hotchk155/arpie/docs/images/FlickerFix.JPG

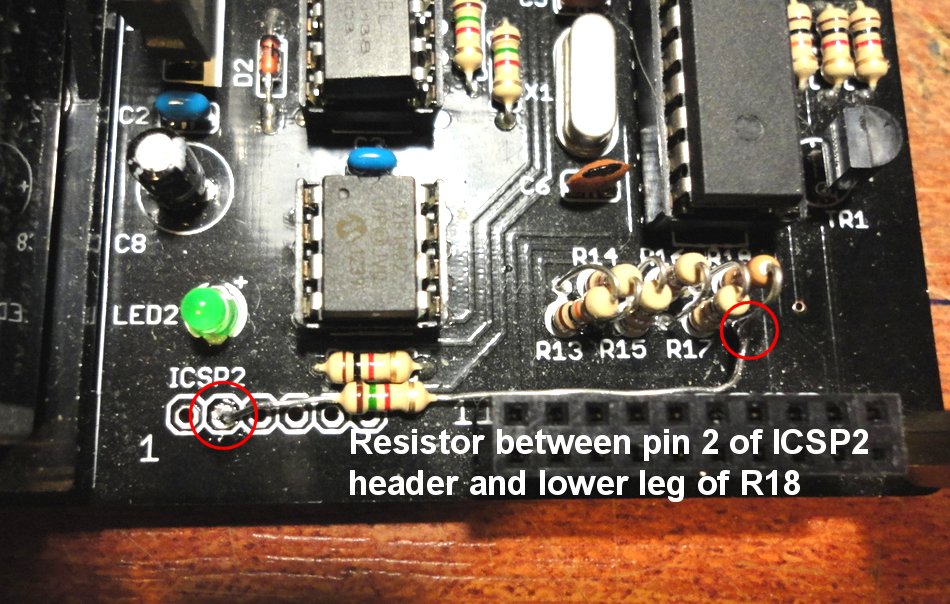
docs/images/FlickerFix.JPG
