hotchk155/arpie/docs/images/Dsc01868.jpg

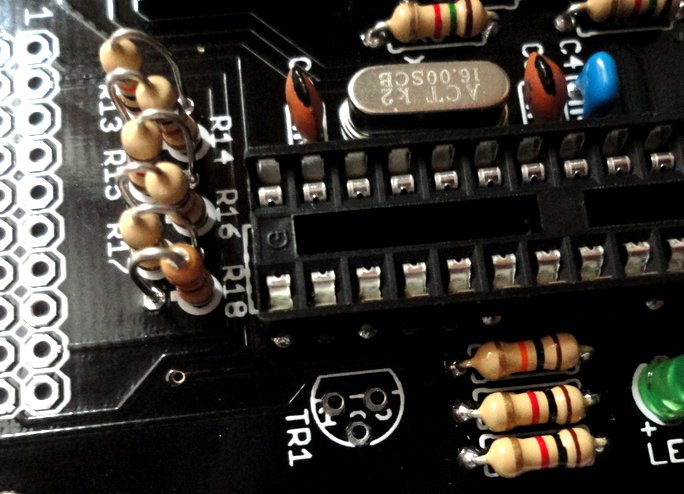
docs/images/Dsc01868.jpg
