hotchk155/arpie/case/ARPIE Case Label.docx

ARPIE Case For assembly instructions please see http://six4pix.com/arpie/case If you have any questions please contact me at goarpie@gmail.com Thanks! Jason | ARPIE Case For assembly instructions please see http://six4pix.com/arpie/case If you have any questions please contact me at goarpie@gmail.com Thanks! Jason
ARPIE Case For assembly instructions please see http://six4pix.com/arpie/case If you have any questions please contact me at goarpie@gmail.com Thanks! Jason | ARPIE Case For assembly instructions please see http://six4pix.com/arpie/case If you have any questions please contact me at goarpie@gmail.com Thanks! Jason
ARPIE Case For assembly instructions please see http://six4pix.com/arpie/case If you have any questions please contact me at goarpie@gmail.com Thanks! Jason | ARPIE Case For assembly instructions please see http://six4pix.com/arpie/case If you have any questions please contact me at goarpie@gmail.com Thanks! Jason
ARPIE Case For assembly instructions please see http://six4pix.com/arpie/case If you have any questions please contact me at goarpie@gmail.com Thanks! Jason | ARPIE Case For assembly instructions please see http://six4pix.com/arpie/case If you have any questions please contact me at goarpie@gmail.com Thanks! Jason
