hotchk155/arpie/docs/Arpie Upgrade.odt

ARPIE 4 Firmware Upgrade (ATMega328)

Before starting work, turn ARPIE off and touch a grounded metal surface to discharge any static build-up (These components can be damaged by static discharge)

Align the pin 1 notch on the chip with the notch on the socket and take care to avoid bending the pins.

Tip: Your old microcontroller chip can be reprogrammed and used in other projects so take care removing it and don't throw it away! (it has Arduino Duemilanova bootloader on it)

ARPIE Website (incl. new user manual): six4pix.com/arpie

Email: goarpie@gmail.com

ARPIE 4 Firmware Upgrade (ATMega328)

Before starting work, turn ARPIE off and touch a grounded metal surface to discharge any static build-up (These components can be damaged by static discharge)

Align the pin 1 notch on the chip with the notch on the socket and take care to avoid bending the pins.

Tip: Your old microcontroller chip can be reprogrammed and used in other projects so take care removing it and don't throw it away! (it has Arduino Duemilanova bootloader on it)

ARPIE Website (incl. new user manual): six4pix.com/arpie

Email: goarpie@gmail.com

ARPIE 4 Firmware Upgrade (ATMega328)

Before starting work, turn ARPIE off and touch a grounded metal surface to discharge any static build-up (These components can be damaged by static discharge)

Align the pin 1 notch on the chip with the notch on the socket and take care to avoid bending the pins.

Tip: Your old microcontroller chip can be reprogrammed and used in other projects so take care removing it and don't throw it away! (it has Arduino Duemilanova bootloader on it)

ARPIE Website (incl. new user manual): six4pix.com/arpie

Email: goarpie@gmail.com

ARPIE 4 Firmware Upgrade (ATMega328)

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

ARPIE Website (incl. new user manual): six4pix.com/arpie

Email: goarpie@gmail.com

ARPIE 4 Firmware Upgrade (ATMega328)

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

ARPIE Website (incl. new user manual): six4pix.com/arpie

Email: goarpie@gmail.com

ARPIE 4 Firmware Upgrade (ATMega328)

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

ARPIE Website (incl. new user manual): six4pix.com/arpie

Email: goarpie@gmail.com

ARPIE 4 Firmware Upgrade (ATMega328)

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

ARPIE Website (incl. new user manual): six4pix.com/arpie

Email: goarpie@gmail.com

ARPIE 4 Firmware Upgrade (ATMega328)

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

ARPIE Website (incl. new user manual): six4pix.com/arpie

Email: goarpie@gmail.com
