hotchk155/arpie/docs/images/B300.JPG

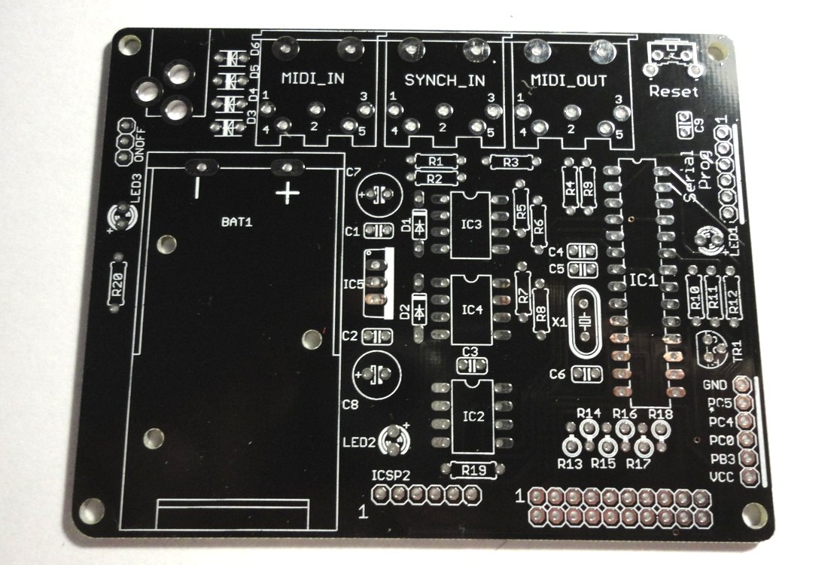
docs/images/B300.JPG
