hotchk155/arpie/docs/images/B301.JPG

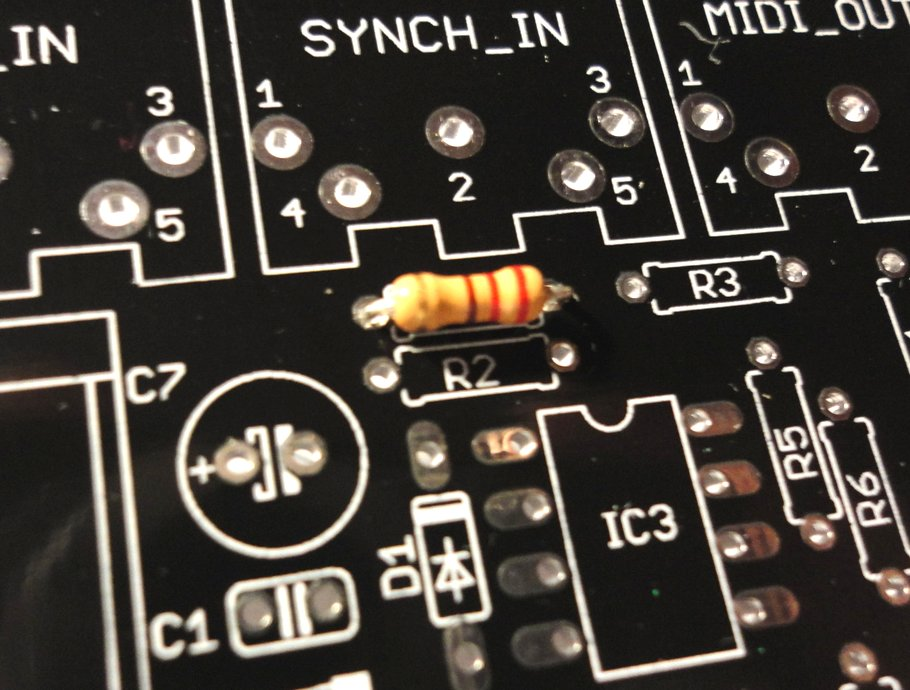
docs/images/B301.JPG
