hotchk155/arpie/docs/images/B302.JPG

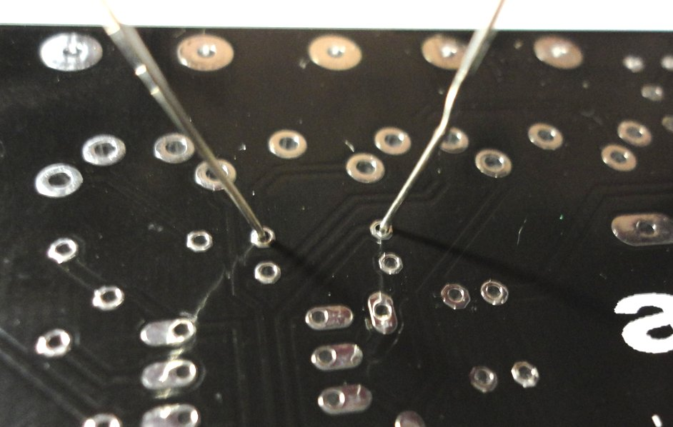
docs/images/B302.JPG
