hotchk155/arpie/docs/images/B303.JPG

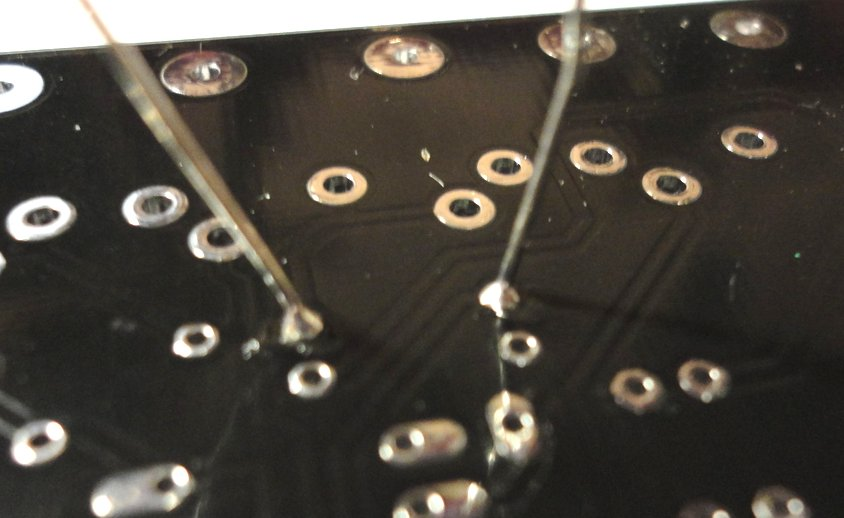
docs/images/B303.JPG
