hotchk155/arpie/docs/images/B304.JPG

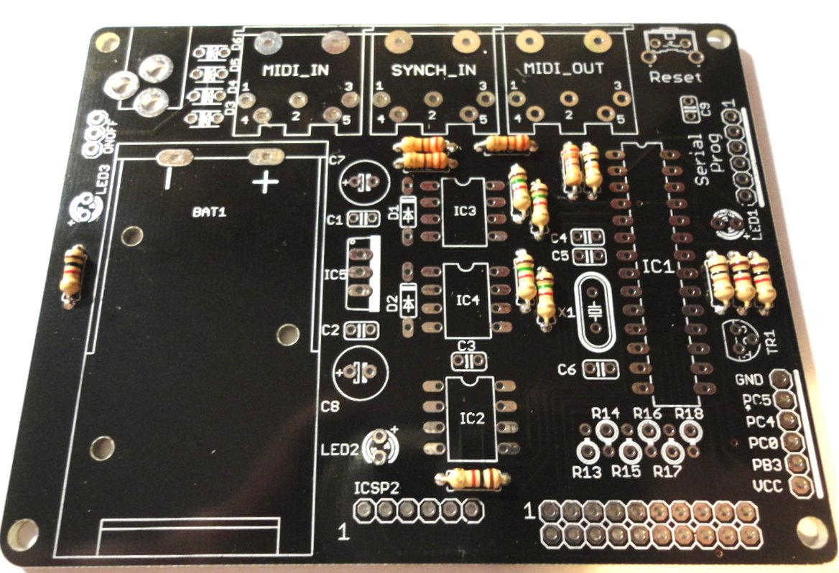
docs/images/B304.JPG
