hotchk155/arpie/docs/images/B305.JPG

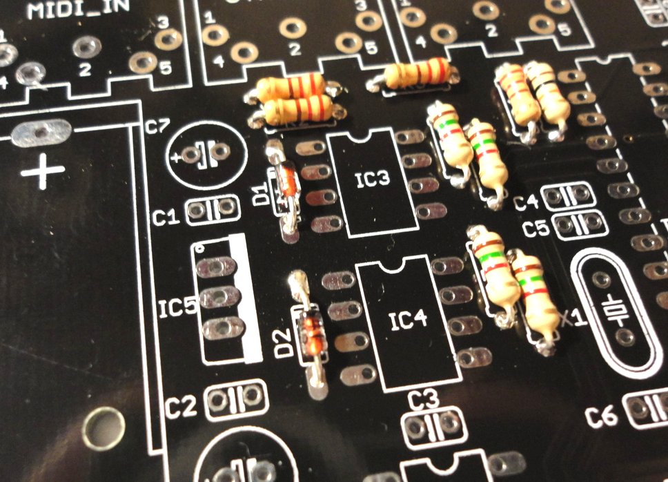
docs/images/B305.JPG
