hotchk155/arpie/docs/images/B306.JPG

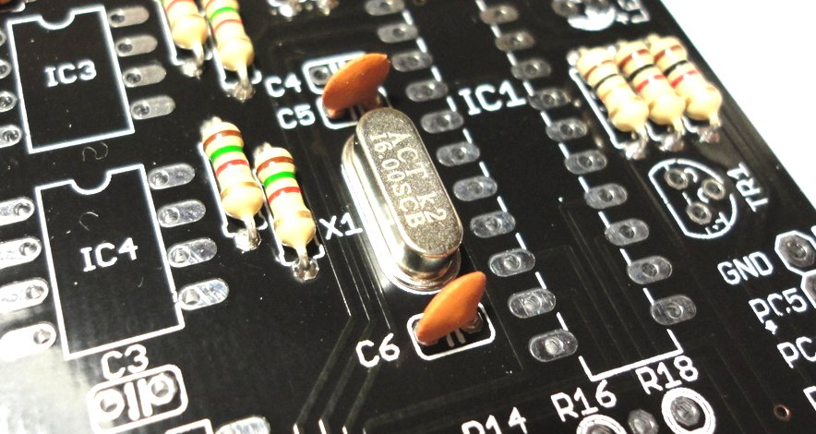
docs/images/B306.JPG
