hotchk155/arpie/docs/images/B307.JPG

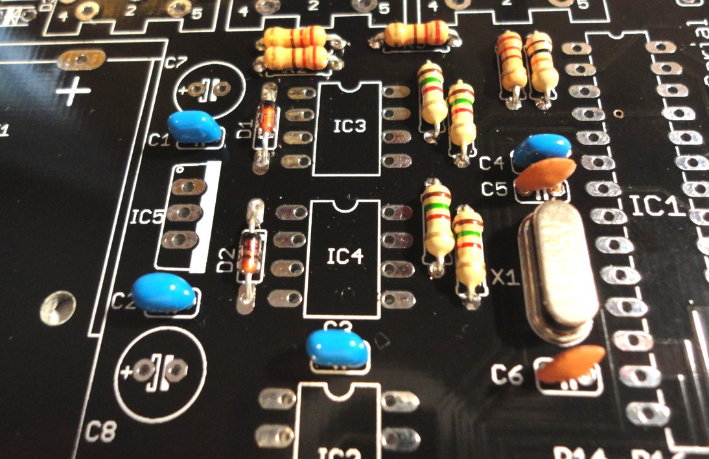
docs/images/B307.JPG
