hotchk155/arpie/docs/images/B308.JPG

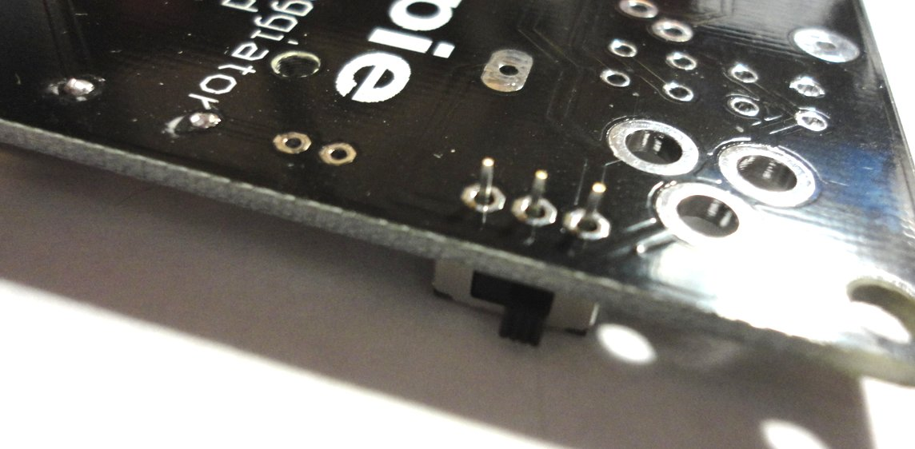
docs/images/B308.JPG
