hotchk155/arpie/docs/images/B309.JPG

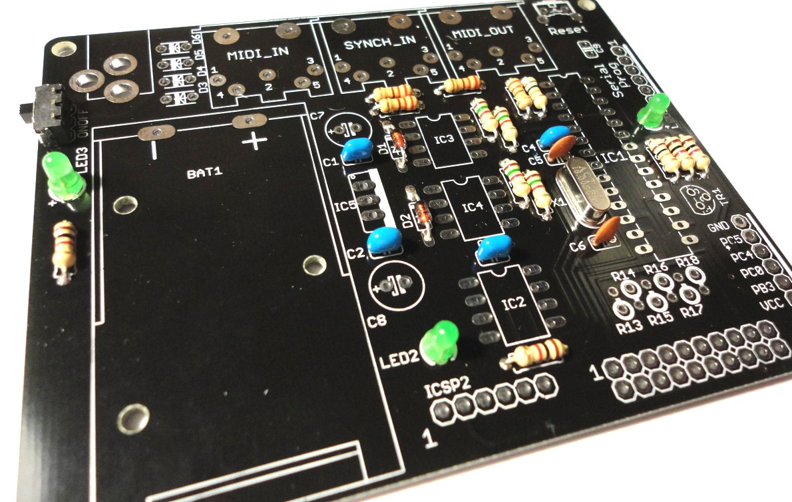
docs/images/B309.JPG
