hotchk155/arpie/docs/images/B310.JPG

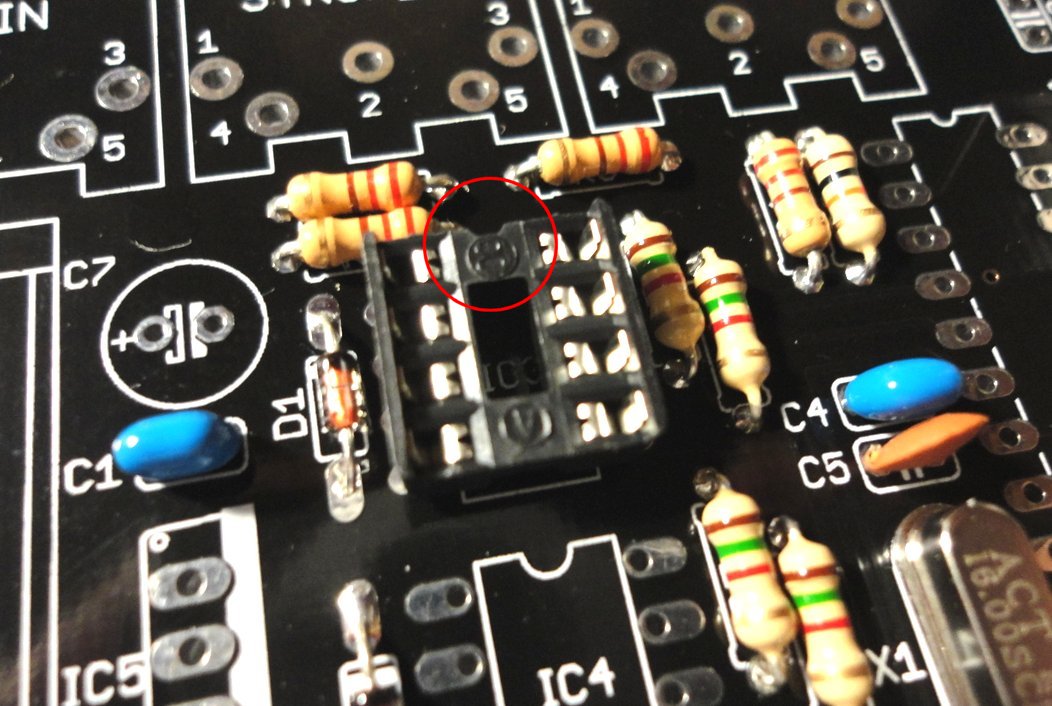
docs/images/B310.JPG
