hotchk155/arpie/docs/images/B311.JPG

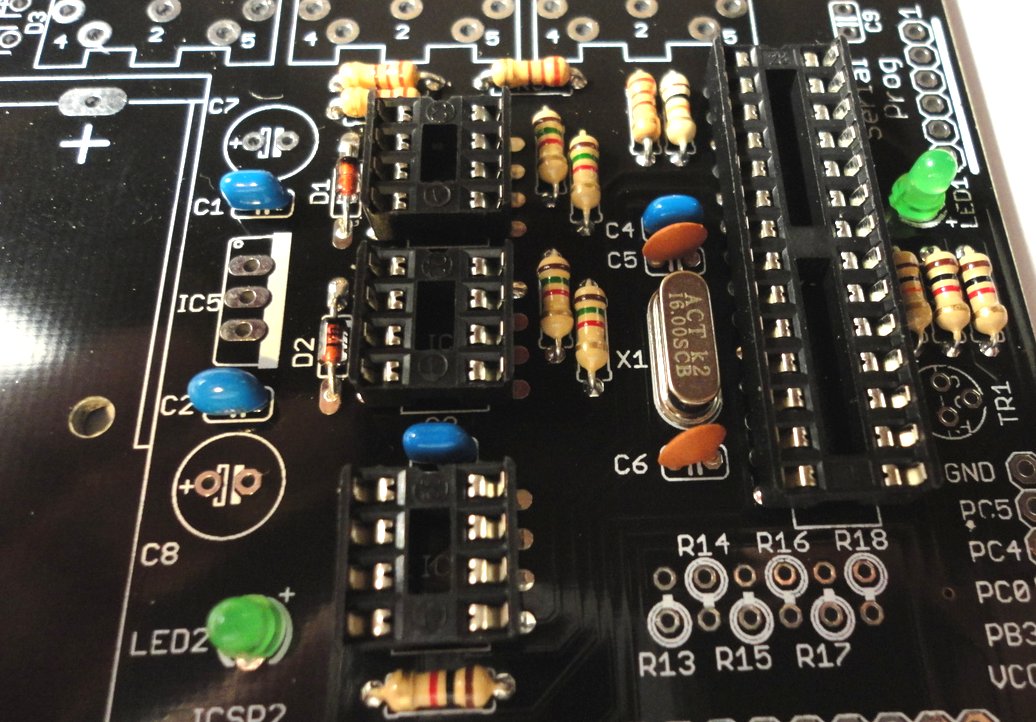
docs/images/B311.JPG
