hotchk155/arpie/docs/images/B312.JPG

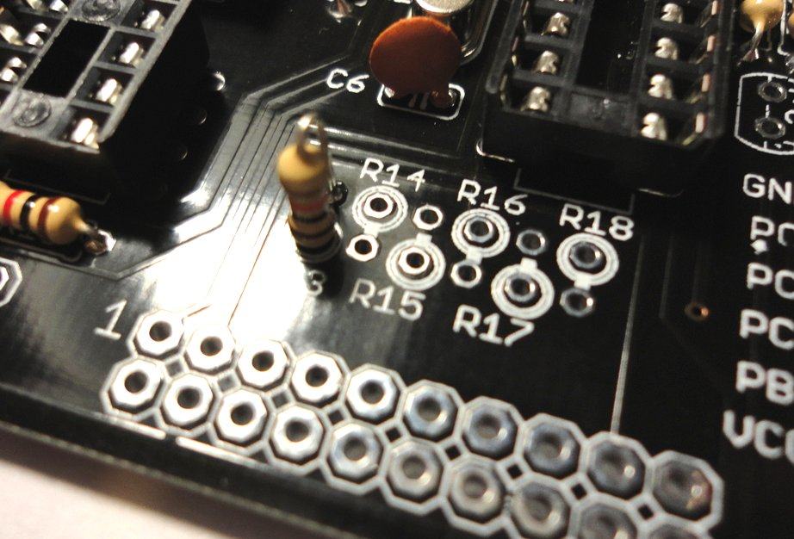
docs/images/B312.JPG
