hotchk155/arpie/docs/images/B313.JPG

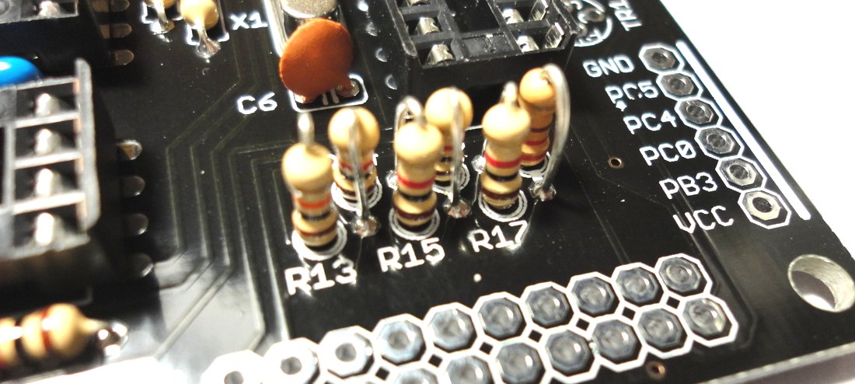
docs/images/B313.JPG
