hotchk155/arpie/docs/images/B314.JPG

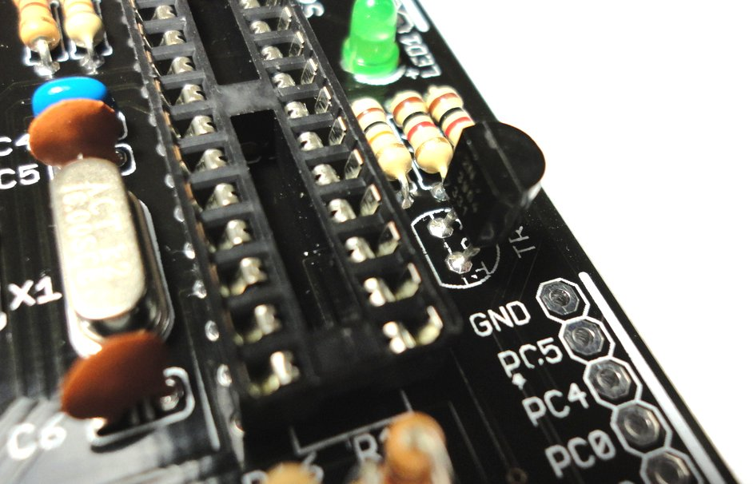
docs/images/B314.JPG
