hotchk155/arpie/docs/images/B315.JPG

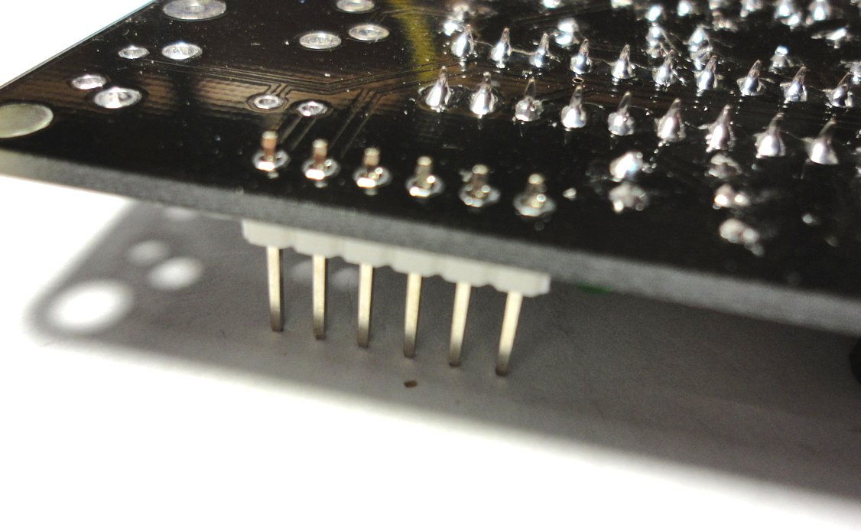
docs/images/B315.JPG
