hotchk155/arpie/docs/images/B316.JPG

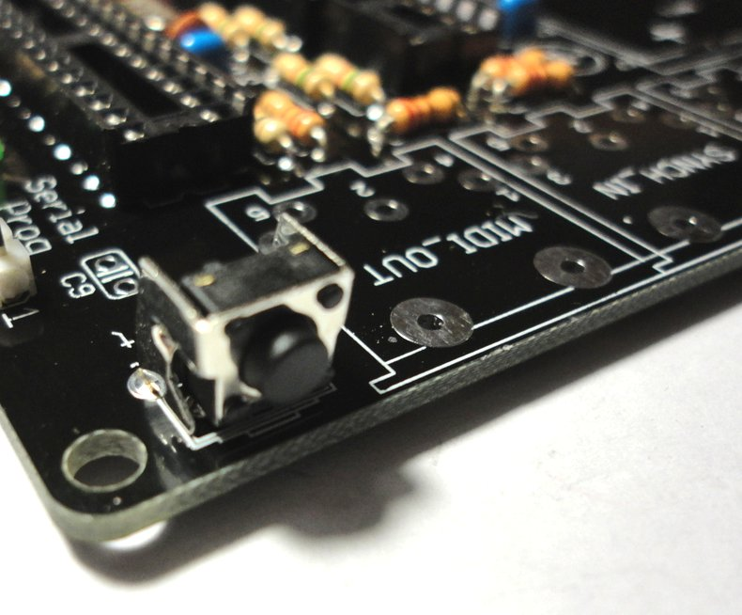
docs/images/B316.JPG
