hotchk155/arpie/docs/images/B317.JPG

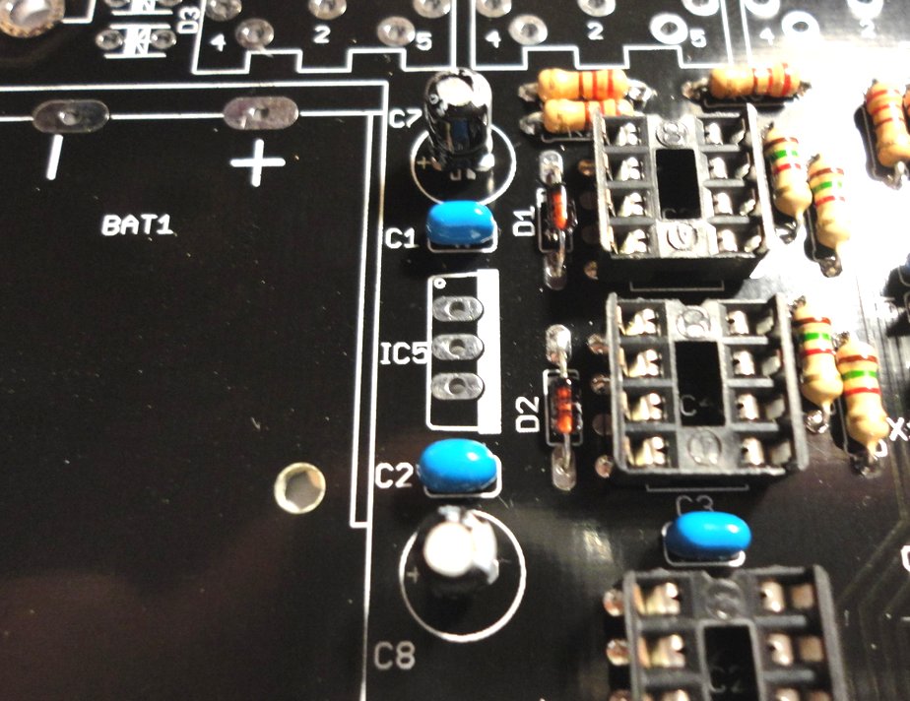
docs/images/B317.JPG
