hotchk155/arpie/docs/images/B318.JPG

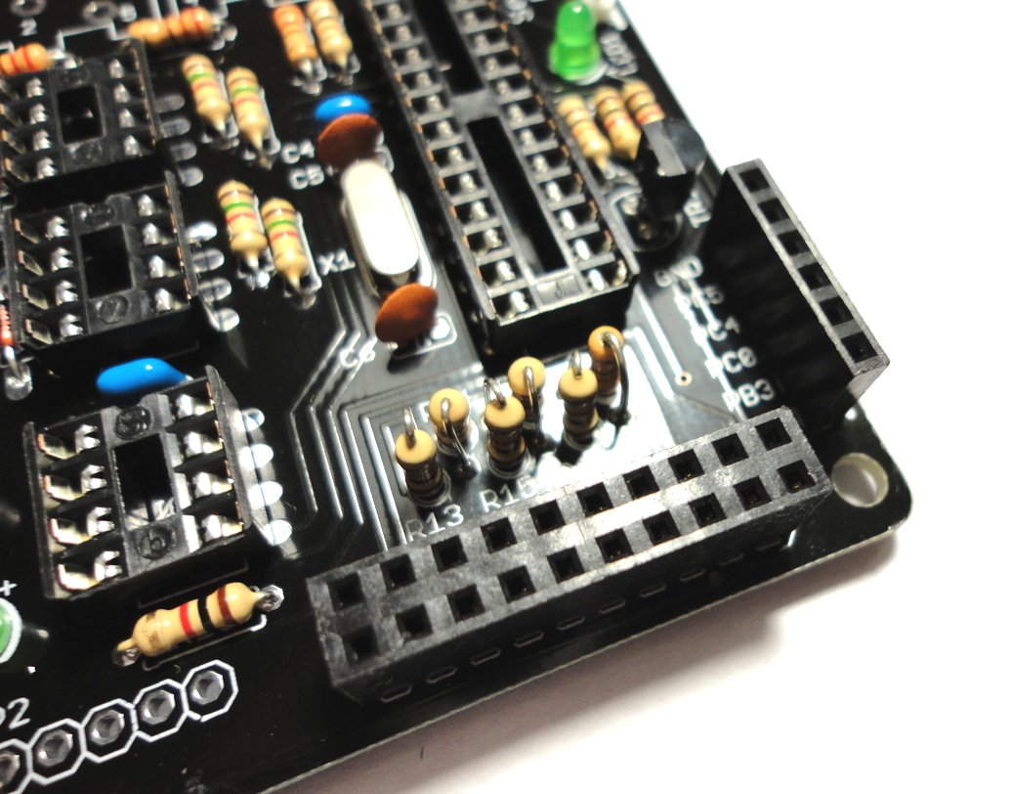
docs/images/B318.JPG
