hotchk155/arpie/docs/images/B319.JPG

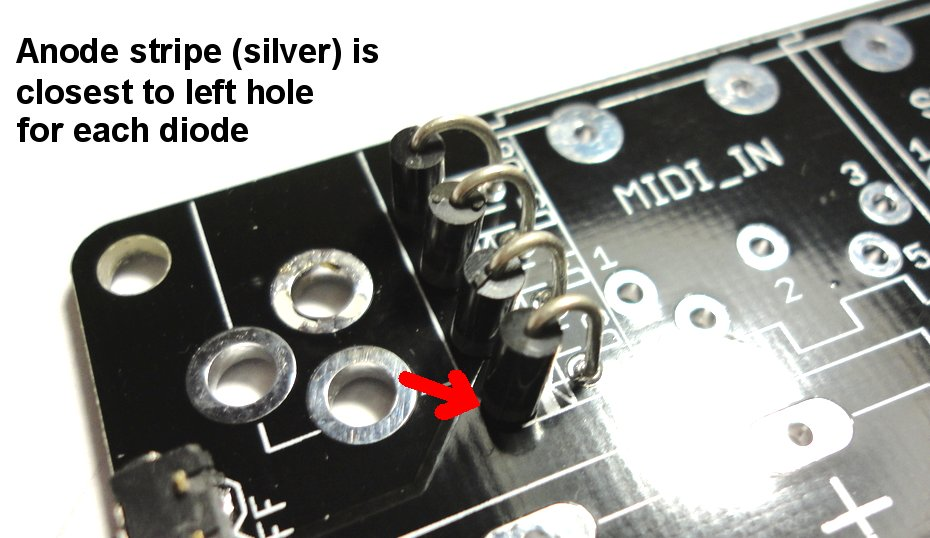
docs/images/B319.JPG
