hotchk155/arpie/docs/images/B320.JPG

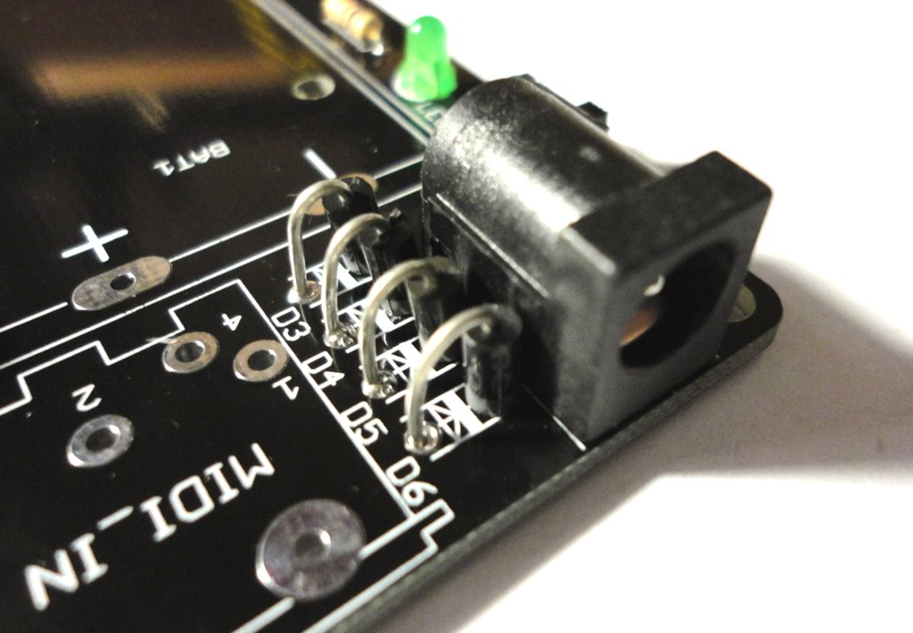
docs/images/B320.JPG
