hotchk155/arpie/docs/images/B321.JPG

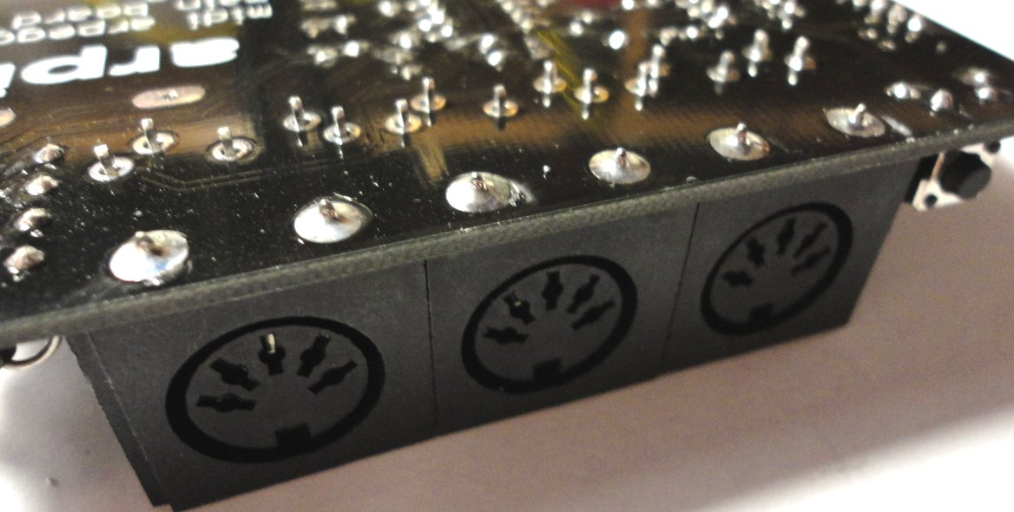
docs/images/B321.JPG
