hotchk155/arpie/docs/images/B322.JPG

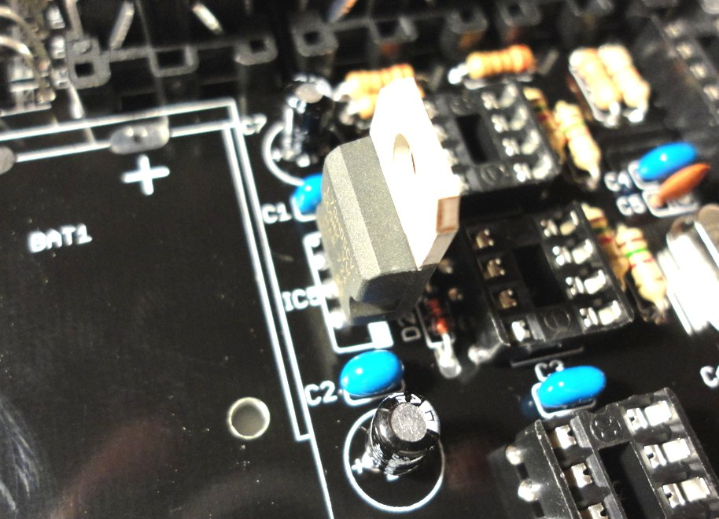
docs/images/B322.JPG
