hotchk155/arpie/docs/images/B323.JPG

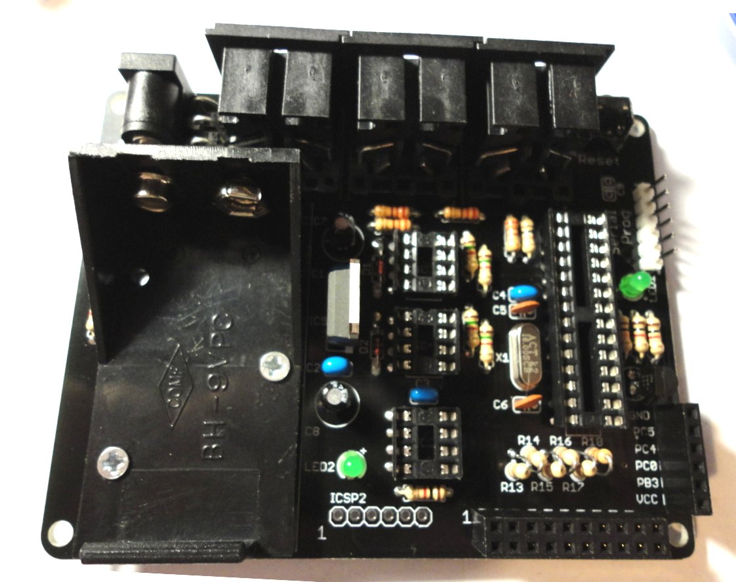
docs/images/B323.JPG
