hotchk155/arpie/docs/images/B324.JPG

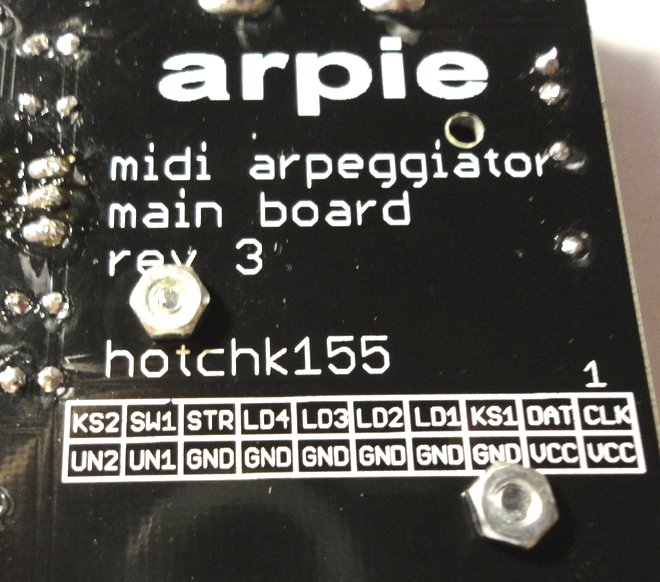
docs/images/B324.JPG
