hotchk155/arpie/docs/images/B325.JPG

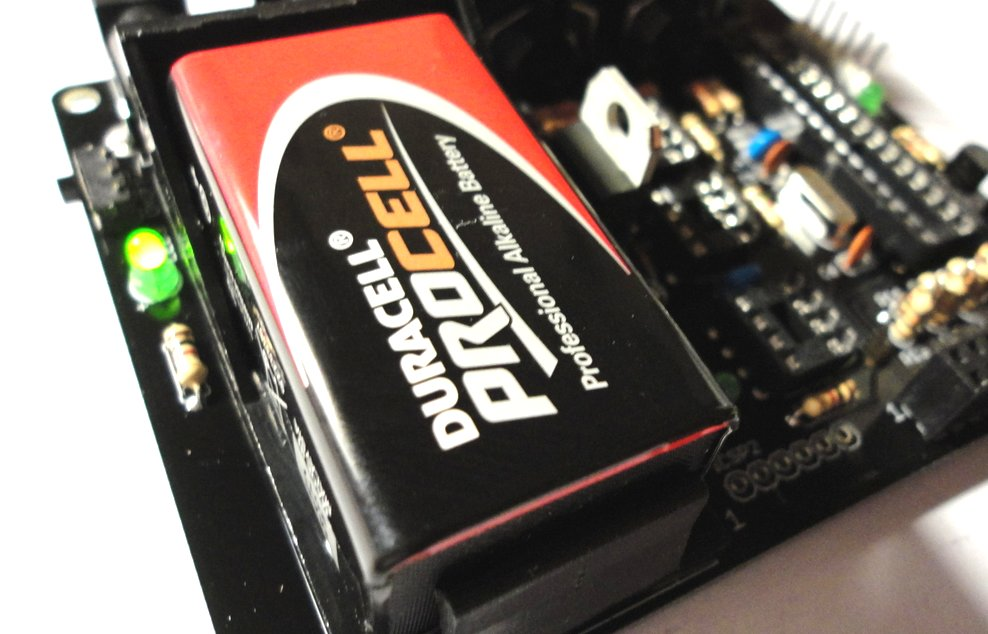
docs/images/B325.JPG
