hotchk155/arpie/docs/images/B326.JPG

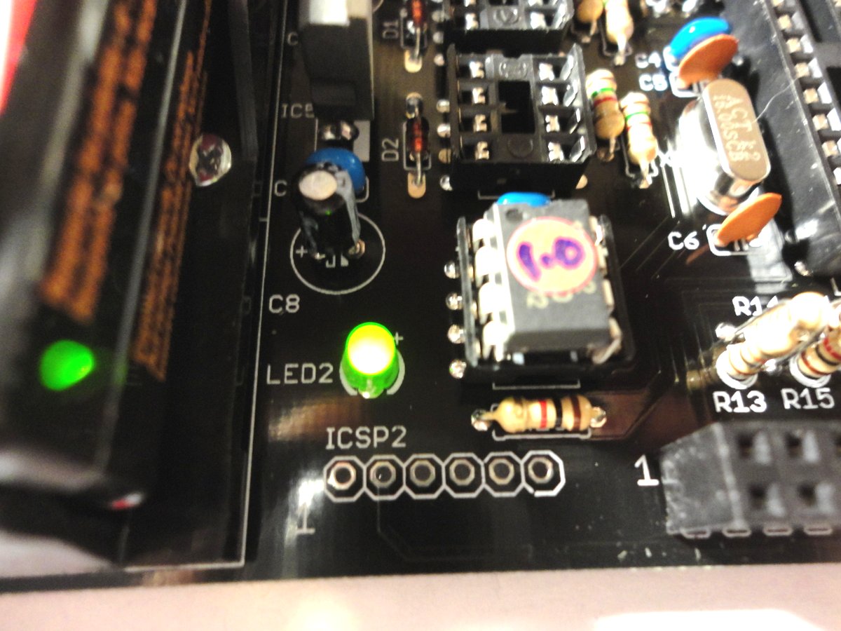
docs/images/B326.JPG
