hotchk155/arpie/docs/images/B327.JPG

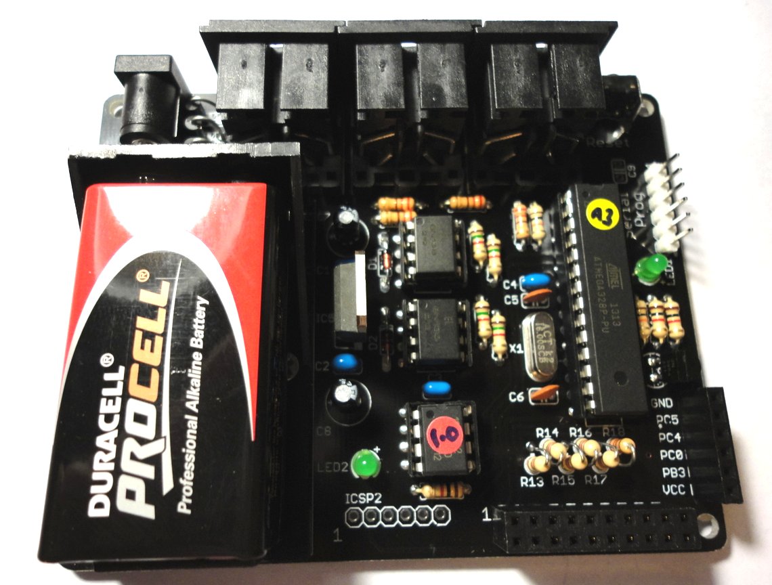
docs/images/B327.JPG
