hotchk155/arpie/docs/images/B328.JPG

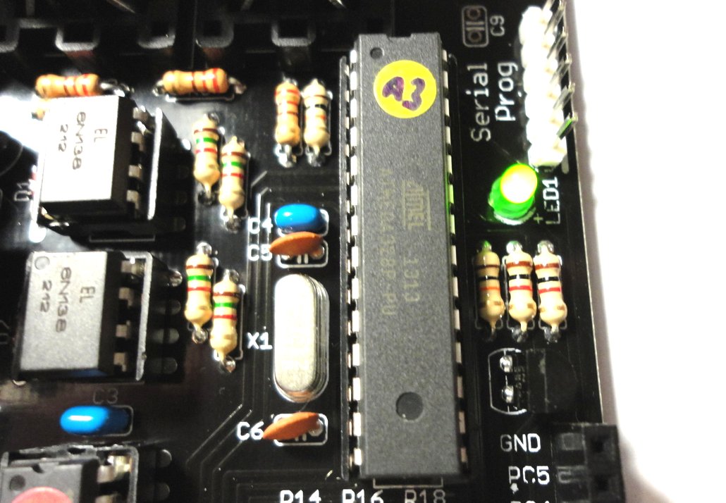
docs/images/B328.JPG
