hotchk155/arpie/docs/images/B329.JPG

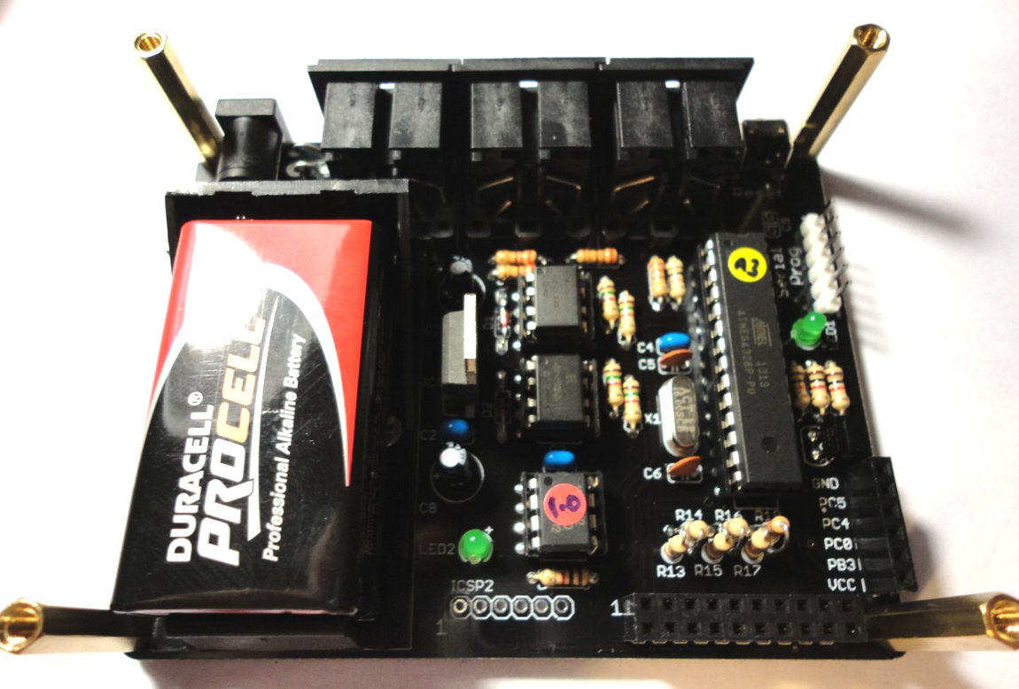
docs/images/B329.JPG
