hotchk155/arpie/docs/images/B330.JPG

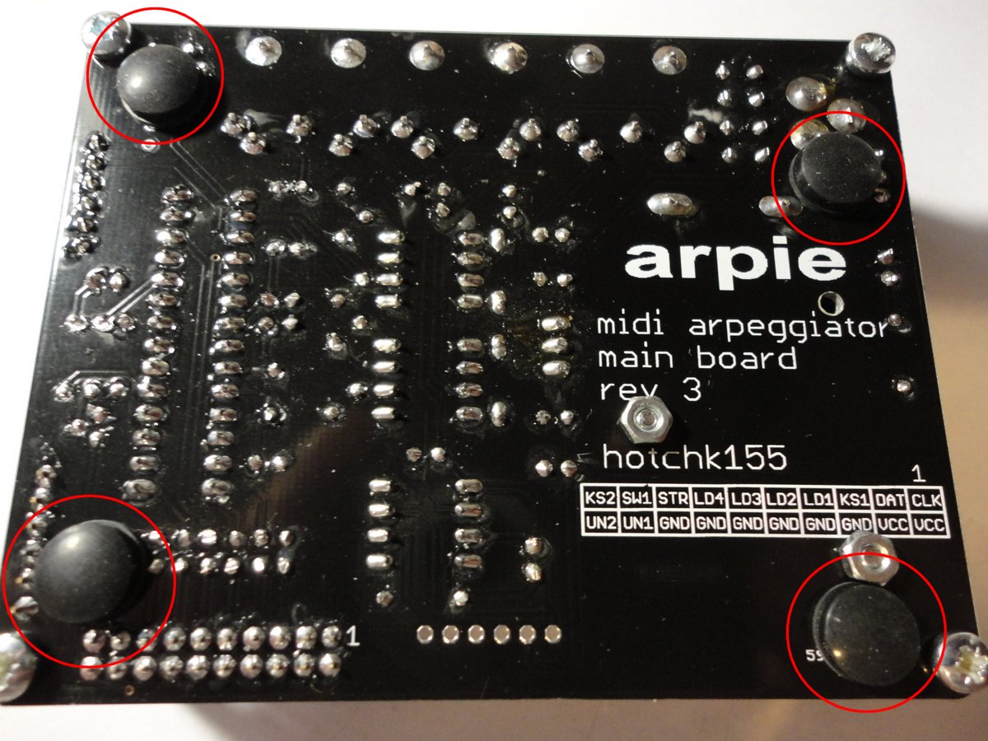
docs/images/B330.JPG
