hotchk155/arpie/docs/images/chan.png

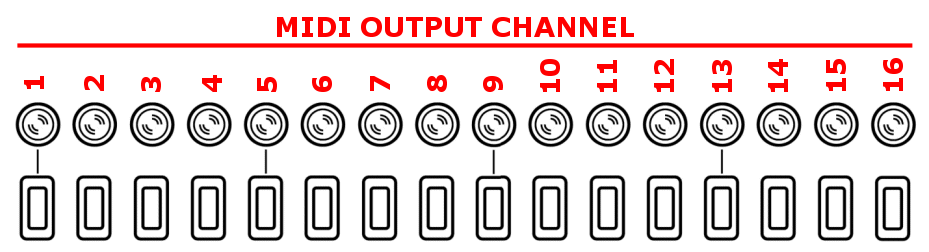
docs/images/chan.png
