hotchk155/arpie/docs/images/display_template.png

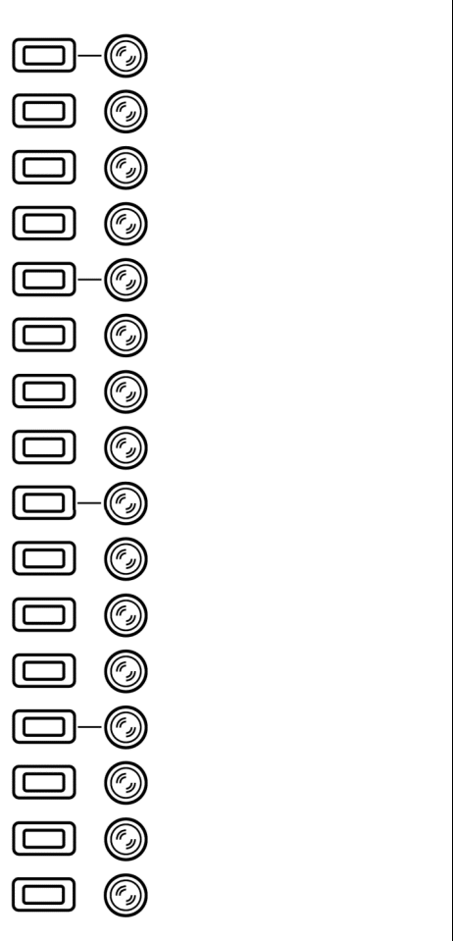
docs/images/display_template.png
