hotchk155/arpie/docs/images/DSC01828.JPG

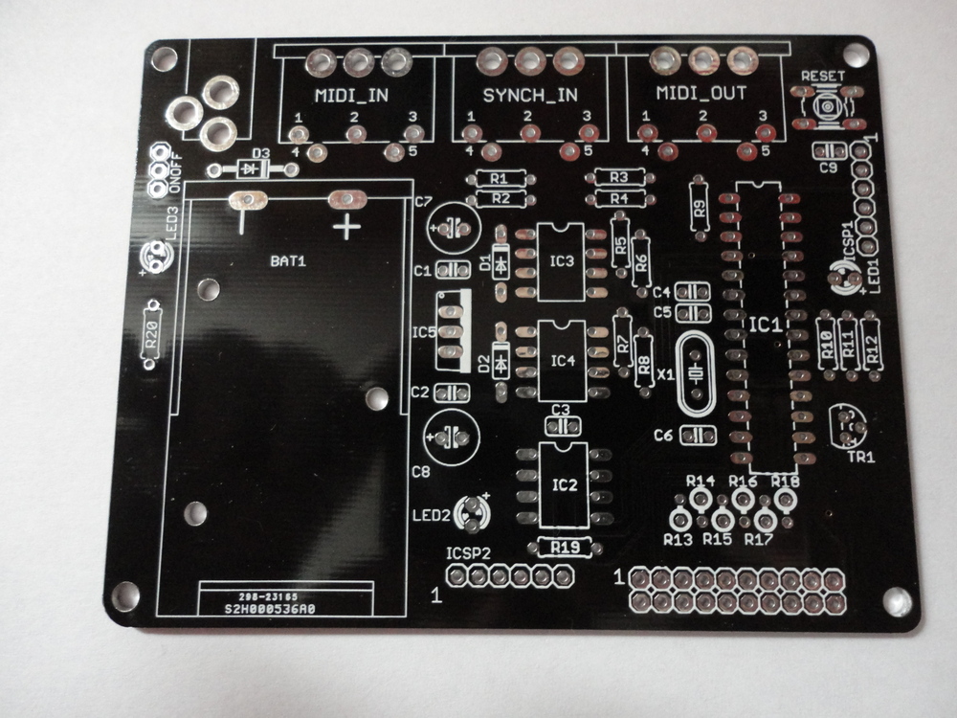
docs/images/DSC01828.JPG
