hotchk155/arpie/docs/images/Dsc01830.jpg

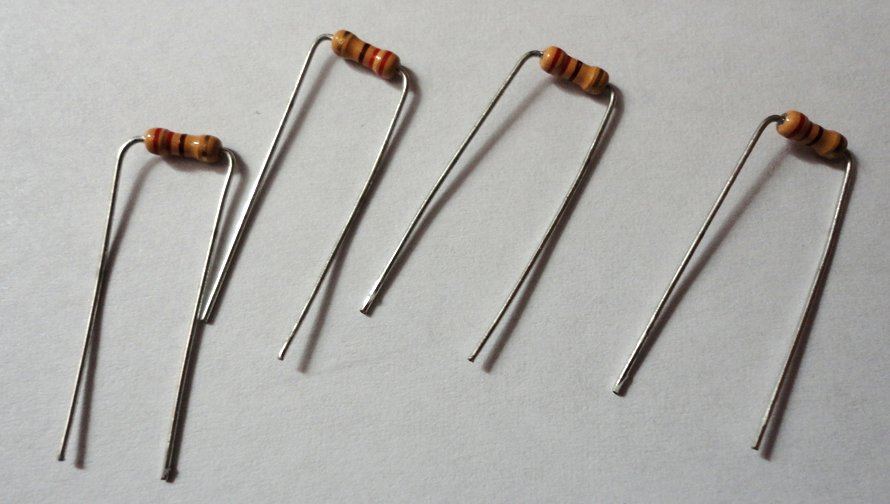
docs/images/Dsc01830.jpg
