hotchk155/arpie/docs/images/DSC01833.JPG

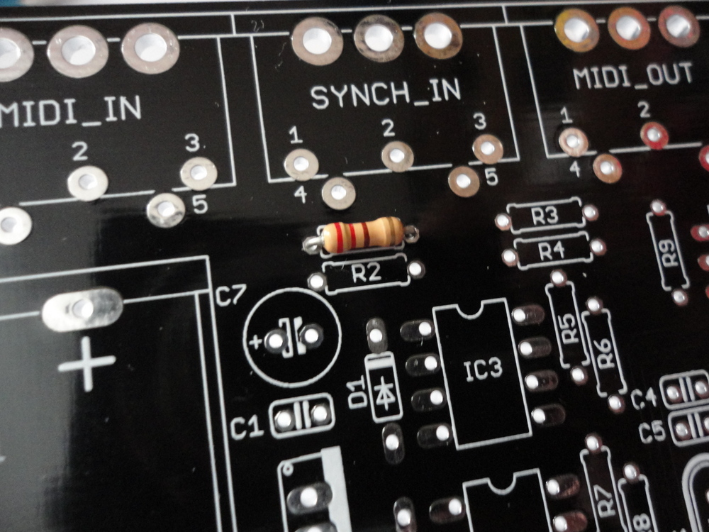
docs/images/DSC01833.JPG
