hotchk155/arpie/docs/images/Dsc01834.jpg

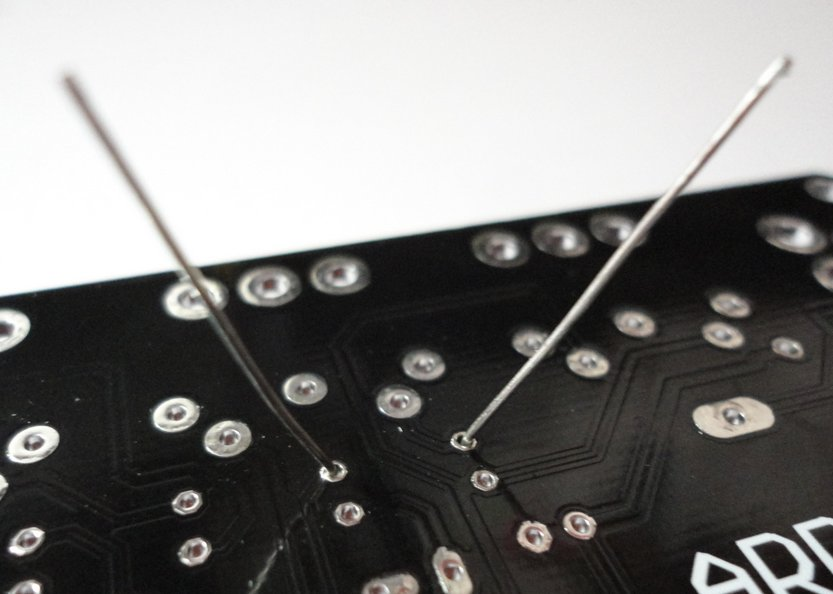
docs/images/Dsc01834.jpg
