hotchk155/arpie/docs/images/Dsc01835.jpg

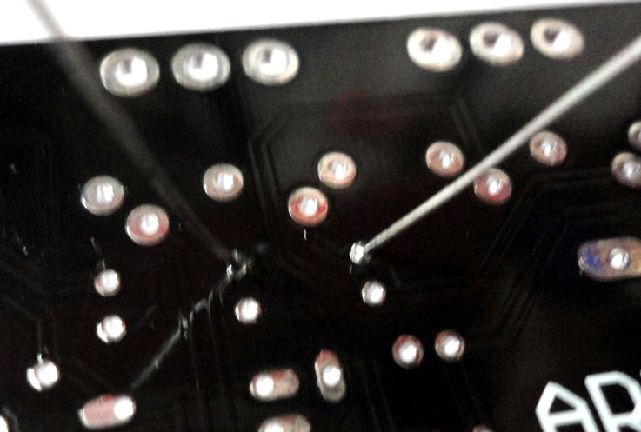
docs/images/Dsc01835.jpg
