hotchk155/arpie/docs/images/Dsc01839.jpg

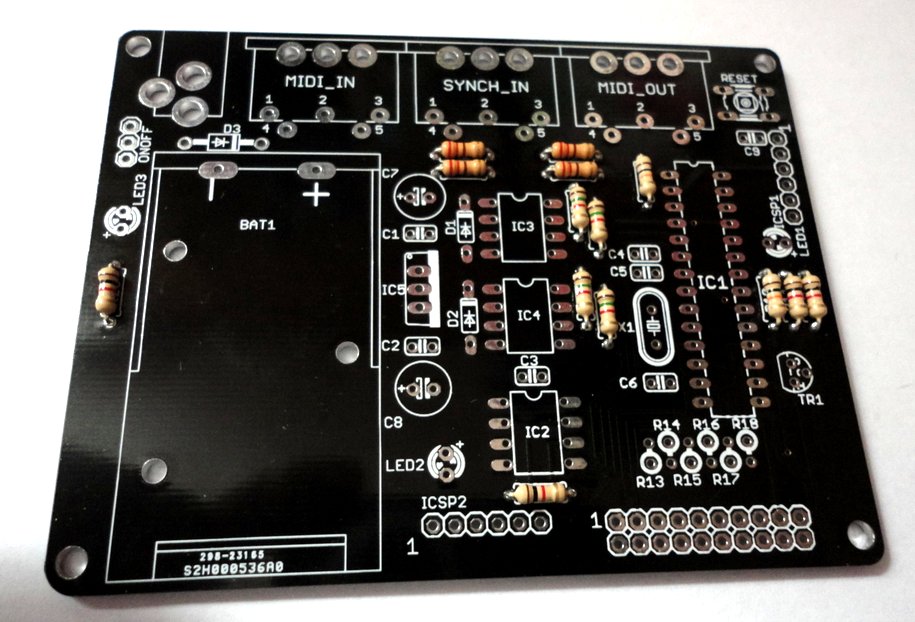
docs/images/Dsc01839.jpg
