hotchk155/arpie/docs/images/DSC01840.JPG

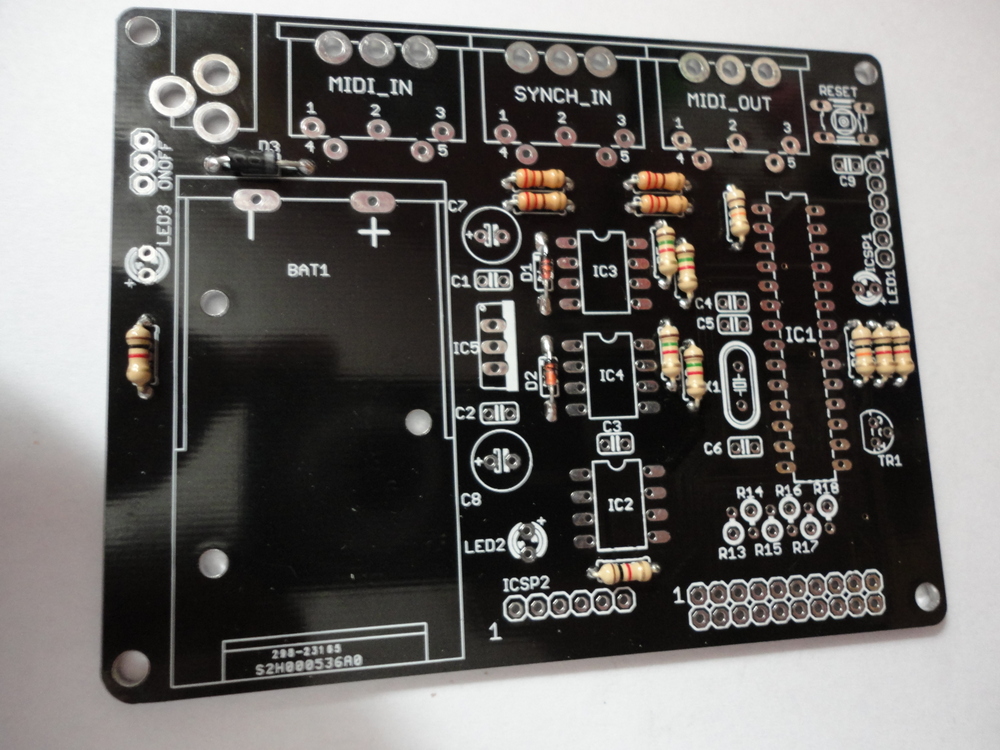
docs/images/DSC01840.JPG
