hotchk155/arpie/docs/images/Dsc01841.jpg

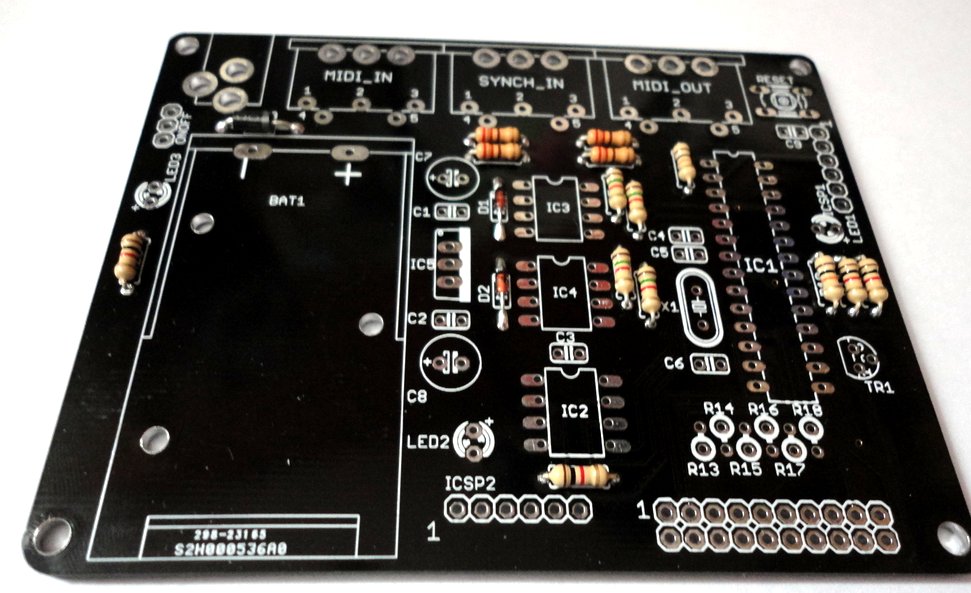
docs/images/Dsc01841.jpg
