hotchk155/arpie/docs/images/Dsc01846.jpg

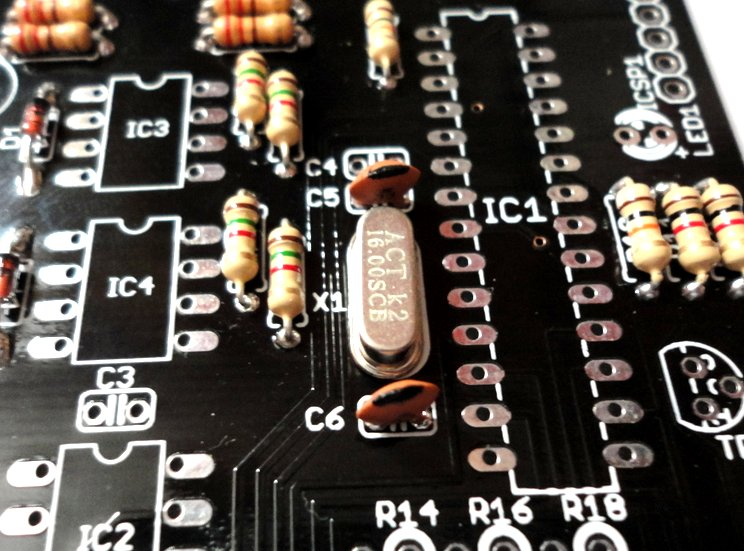
docs/images/Dsc01846.jpg
