hotchk155/arpie/docs/images/Dsc01847.jpg

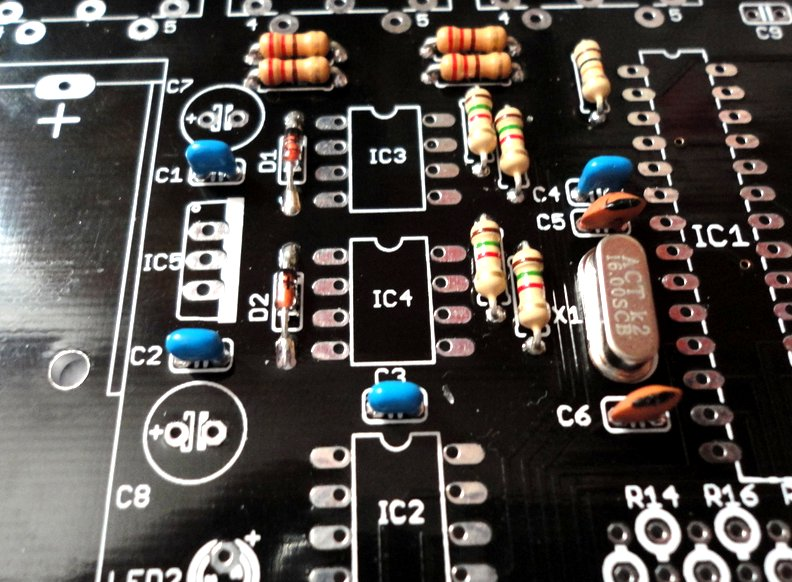
docs/images/Dsc01847.jpg
