hotchk155/arpie/docs/images/Dsc01849.jpg

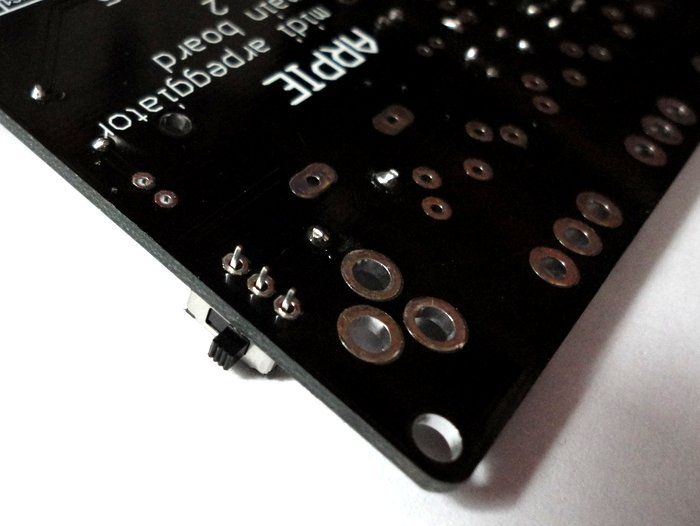
docs/images/Dsc01849.jpg
