hotchk155/arpie/docs/images/Dsc01852.jpg

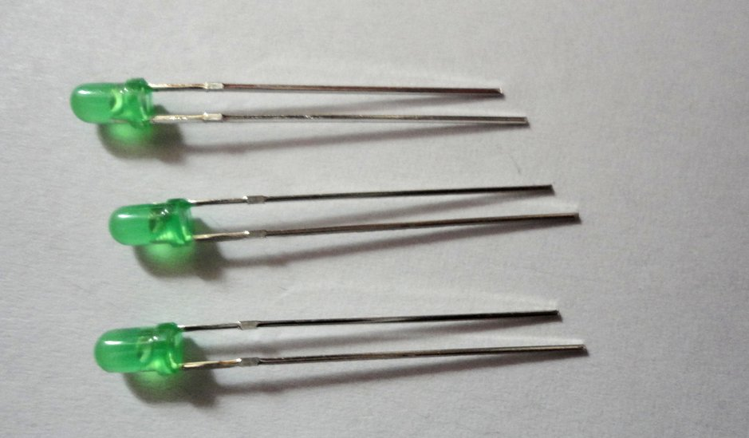
docs/images/Dsc01852.jpg
