hotchk155/arpie/docs/images/Dsc01853.jpg

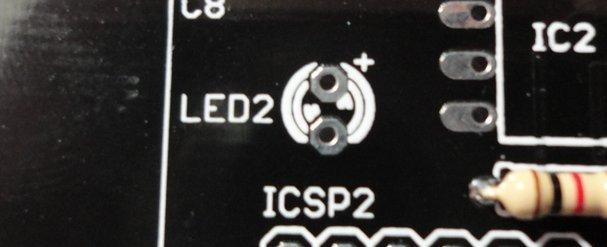
docs/images/Dsc01853.jpg
