hotchk155/arpie/docs/images/Dsc01854.jpg

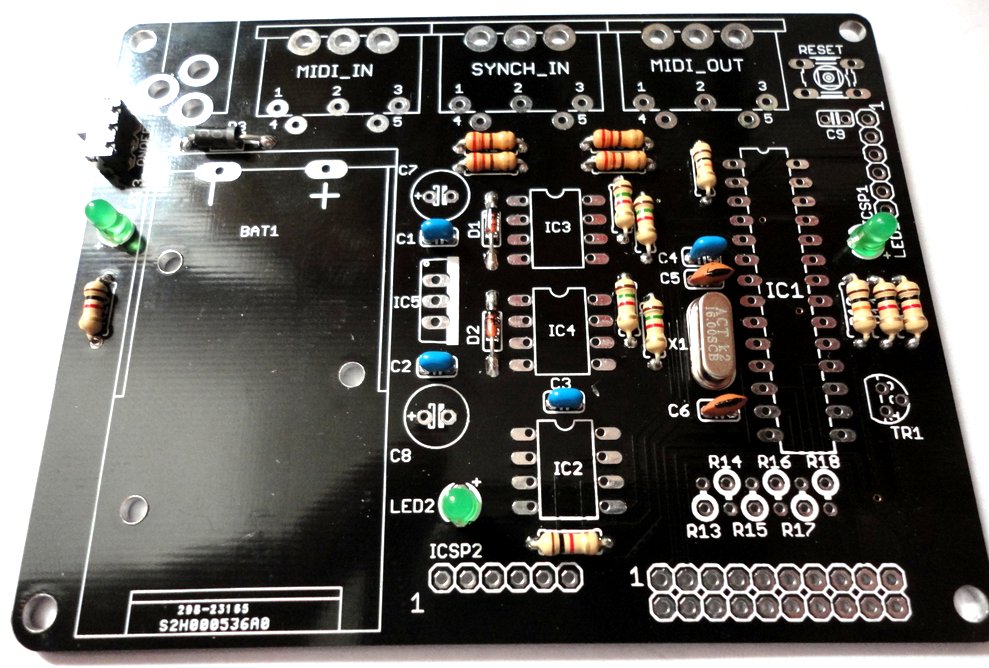
docs/images/Dsc01854.jpg
