hotchk155/arpie/docs/images/Dsc01856.jpg

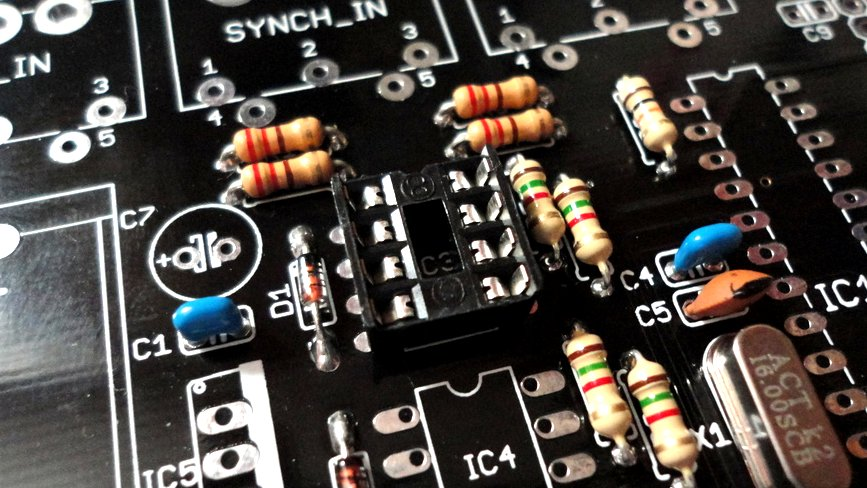
docs/images/Dsc01856.jpg
