hotchk155/arpie/docs/images/Dsc01859.jpg

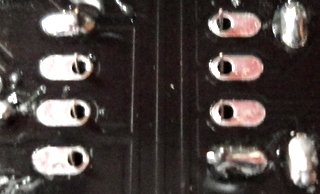
docs/images/Dsc01859.jpg
