hotchk155/arpie/docs/images/Dsc01860.jpg

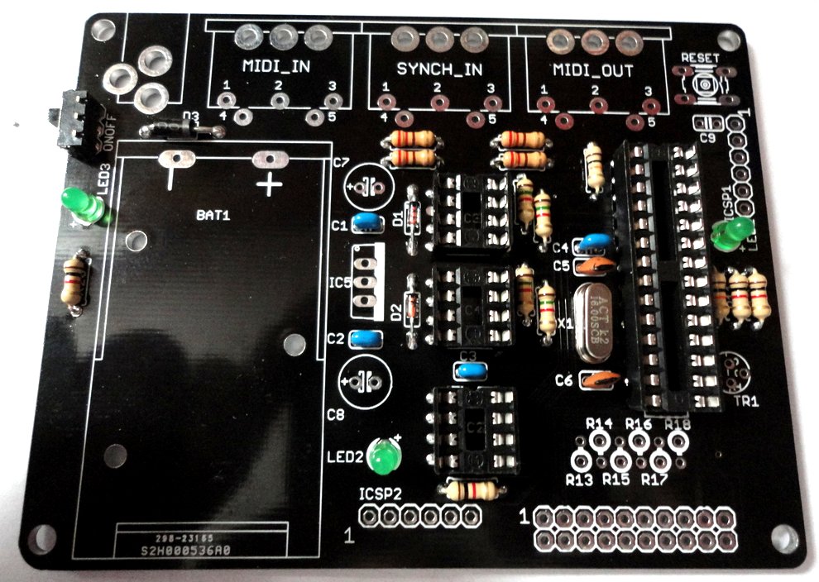
docs/images/Dsc01860.jpg
