hotchk155/arpie/docs/images/Dsc01861.jpg

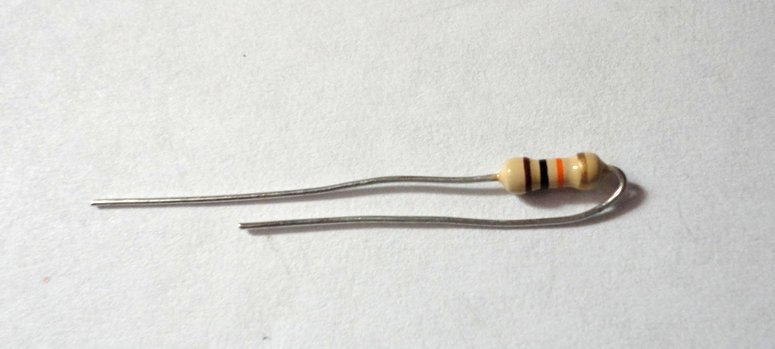
docs/images/Dsc01861.jpg
