hotchk155/arpie/docs/images/Dsc01864.jpg

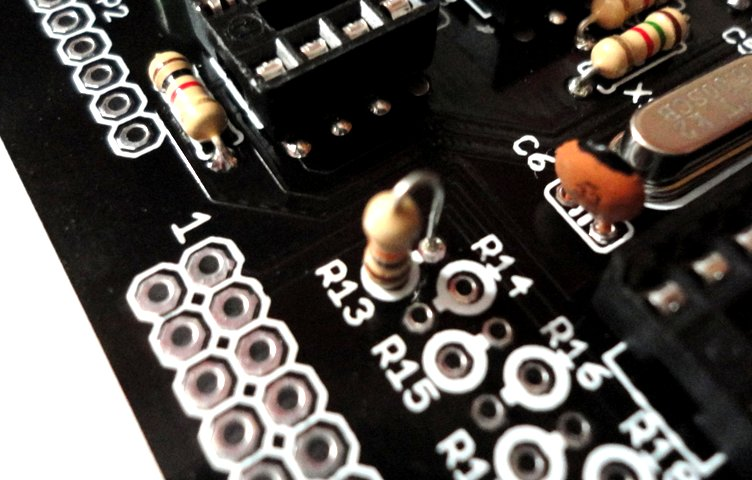
docs/images/Dsc01864.jpg
