hotchk155/arpie/docs/images/Dsc01865.jpg

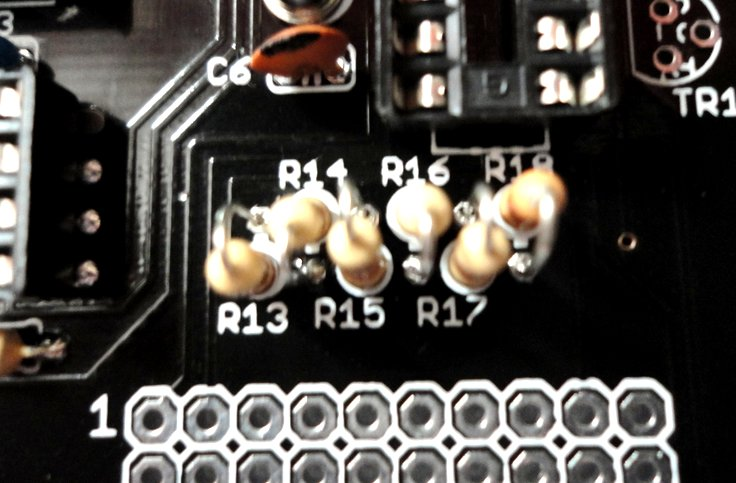
docs/images/Dsc01865.jpg
