hotchk155/arpie/docs/images/Dsc01867.jpg

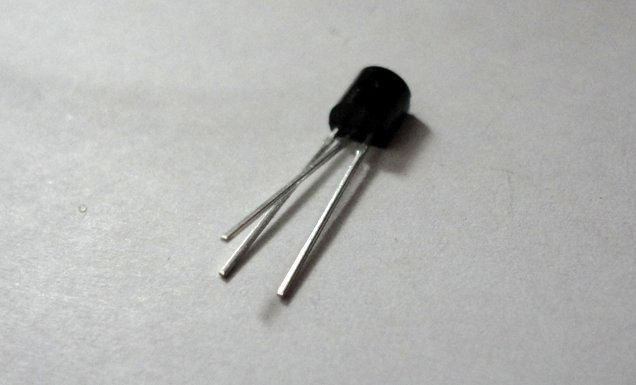
docs/images/Dsc01867.jpg
