hotchk155/arpie/docs/images/Dsc01870.jpg

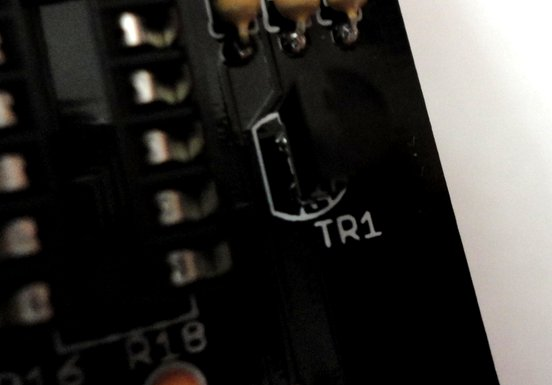
docs/images/Dsc01870.jpg
