hotchk155/arpie/docs/images/Dsc01871.jpg

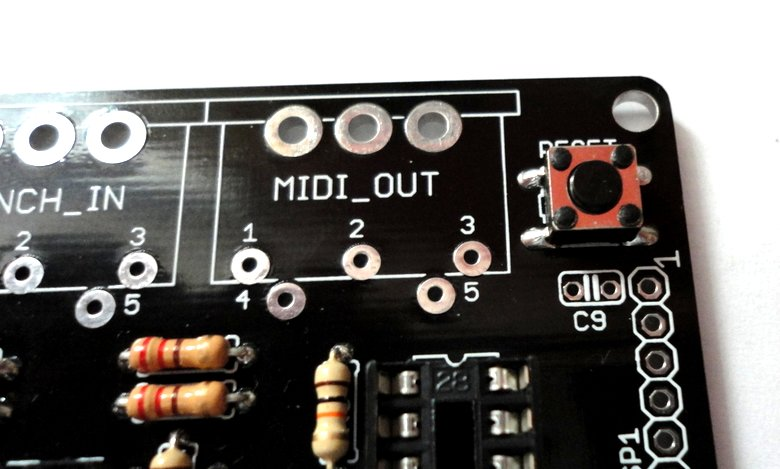
docs/images/Dsc01871.jpg
