hotchk155/arpie/docs/images/Dsc01872.jpg

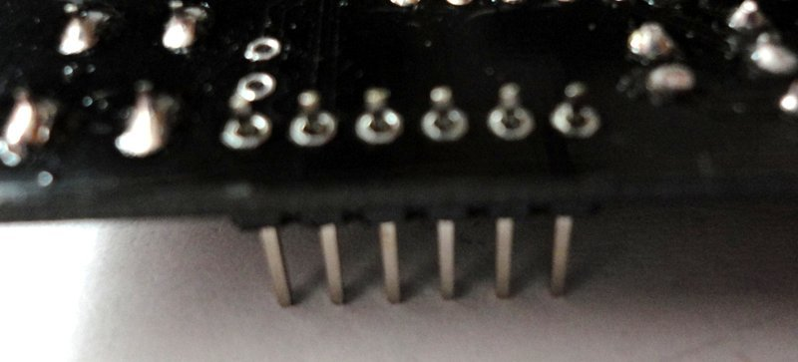
docs/images/Dsc01872.jpg
