hotchk155/arpie/docs/images/Dsc01876.jpg

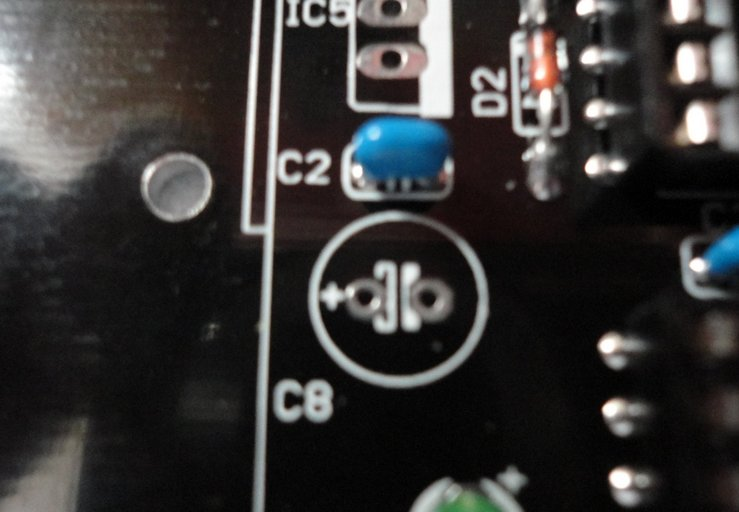
docs/images/Dsc01876.jpg
