hotchk155/arpie/docs/images/Dsc01877.jpg

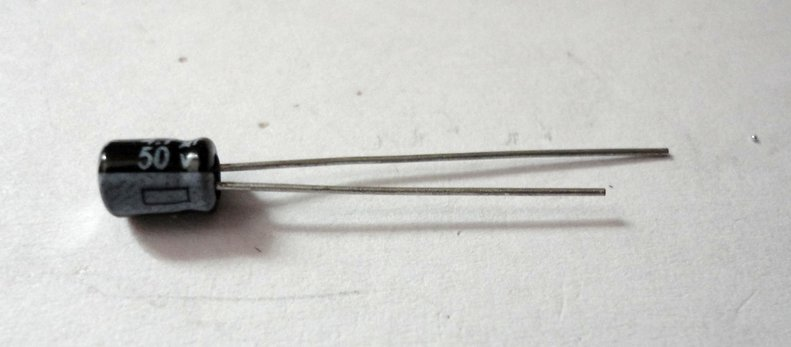
docs/images/Dsc01877.jpg
