hotchk155/arpie/docs/images/Dsc01878.jpg

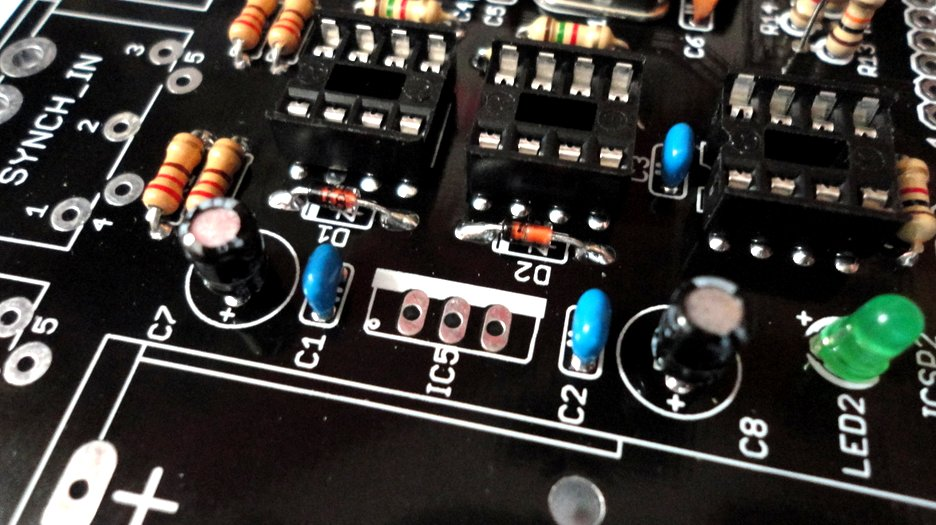
docs/images/Dsc01878.jpg
