hotchk155/arpie/docs/images/Dsc01879.jpg

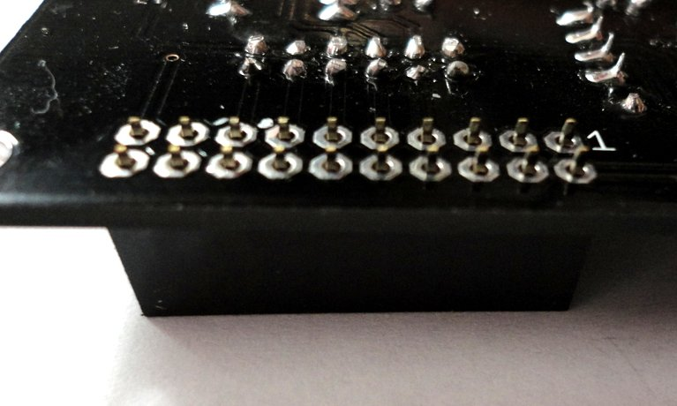
docs/images/Dsc01879.jpg
