hotchk155/arpie/docs/images/Dsc01881.jpg

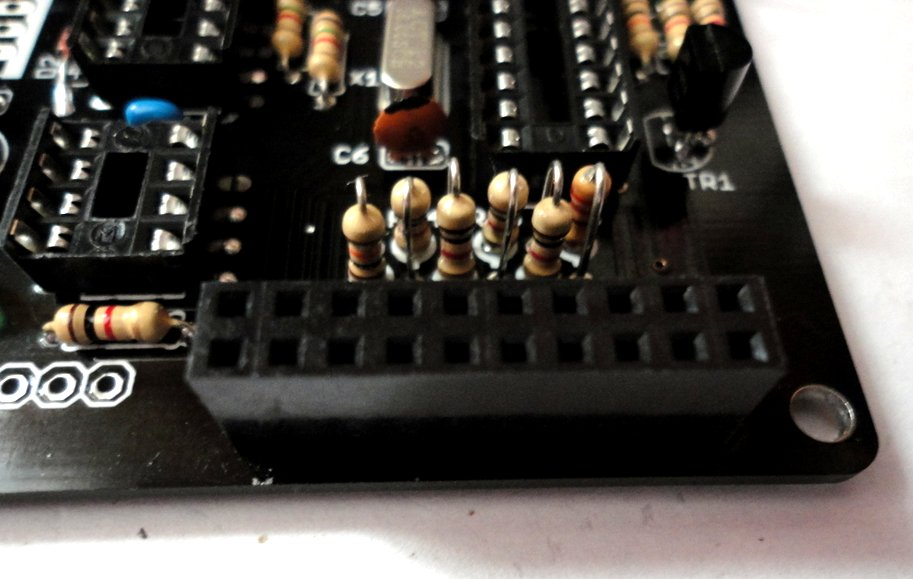
docs/images/Dsc01881.jpg
