hotchk155/arpie/docs/images/Dsc01883.jpg

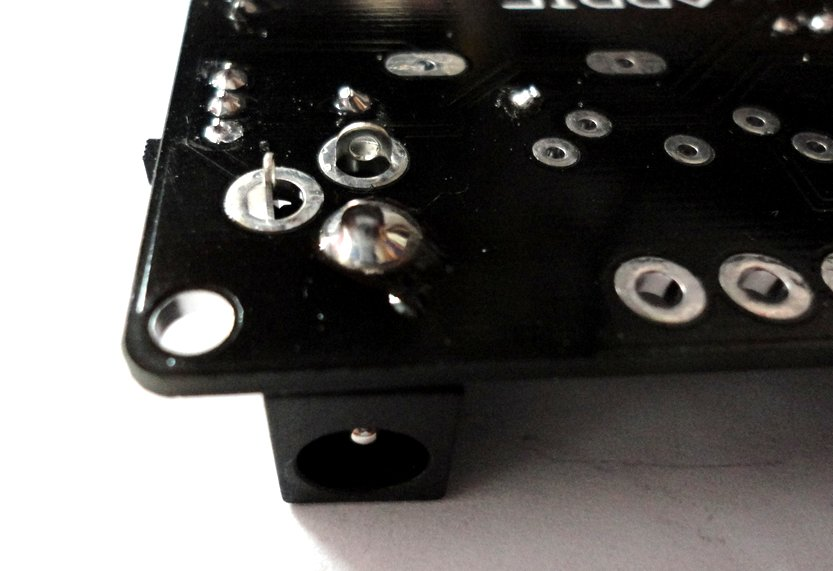
docs/images/Dsc01883.jpg
