hotchk155/arpie/docs/images/Dsc01886.jpg

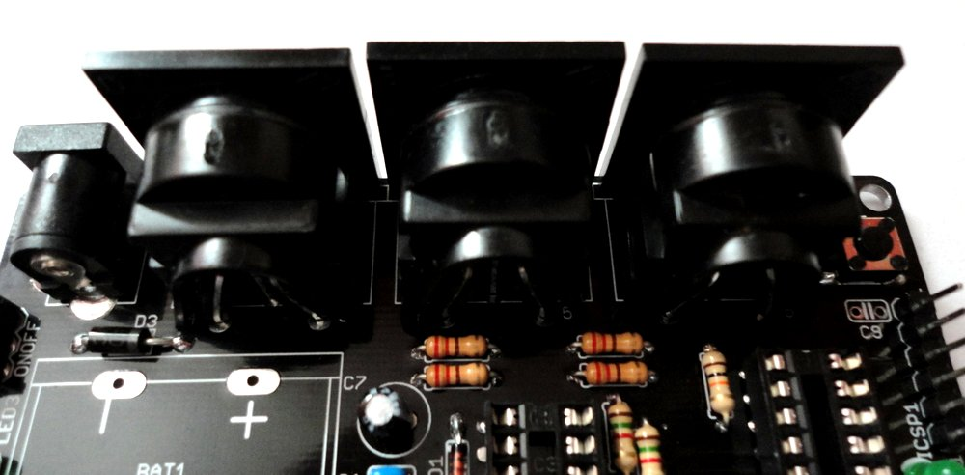
docs/images/Dsc01886.jpg
