hotchk155/arpie/docs/images/Dsc01887.jpg

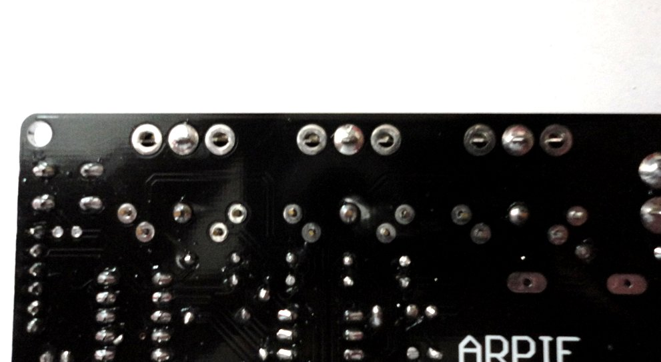
docs/images/Dsc01887.jpg
