hotchk155/arpie/docs/images/Dsc01891.jpg

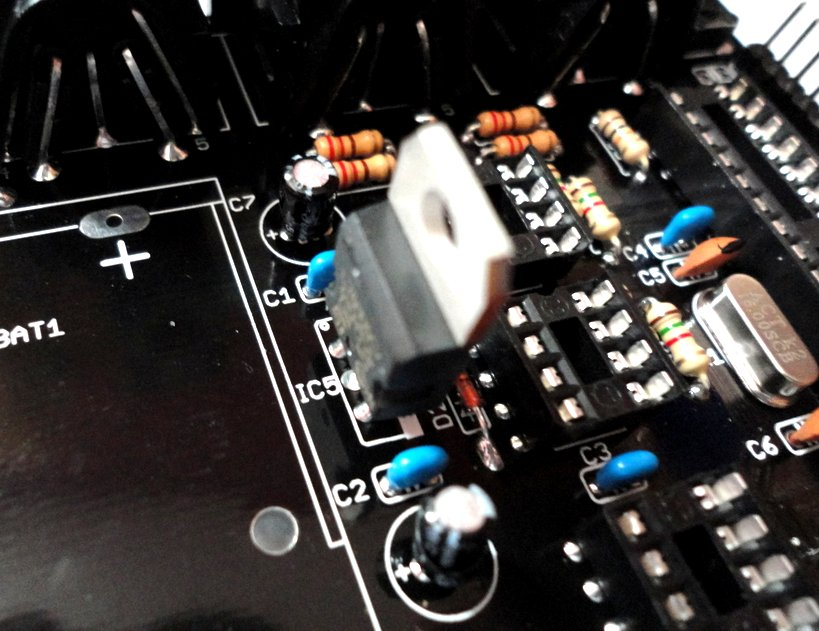
docs/images/Dsc01891.jpg
