hotchk155/arpie/docs/images/Dsc01894.jpg

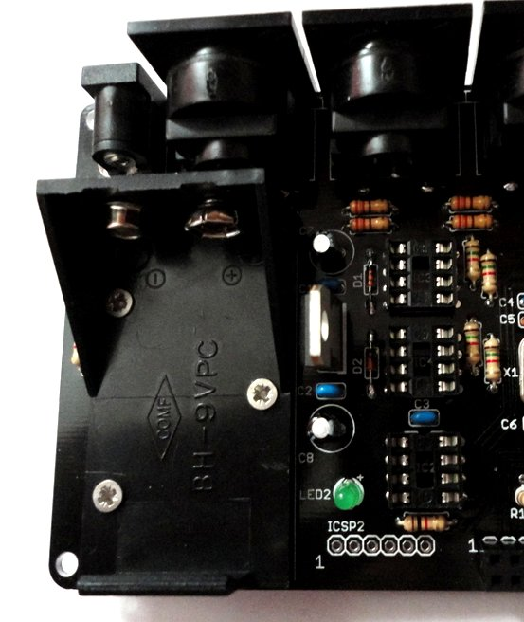
docs/images/Dsc01894.jpg
