hotchk155/arpie/docs/images/Dsc01896.jpg

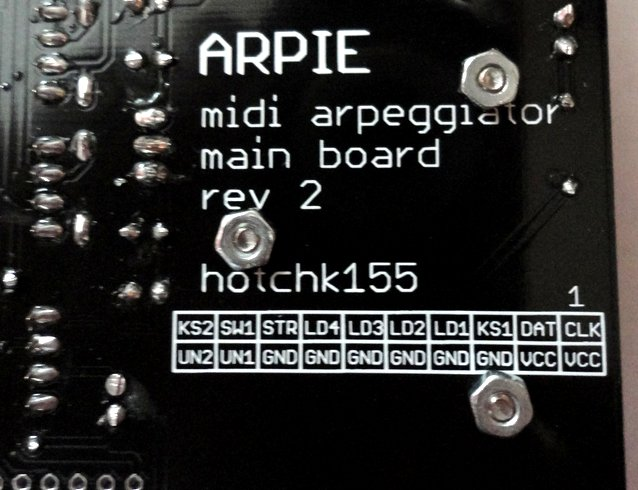
docs/images/Dsc01896.jpg
