hotchk155/arpie/docs/images/DSC01899.JPG

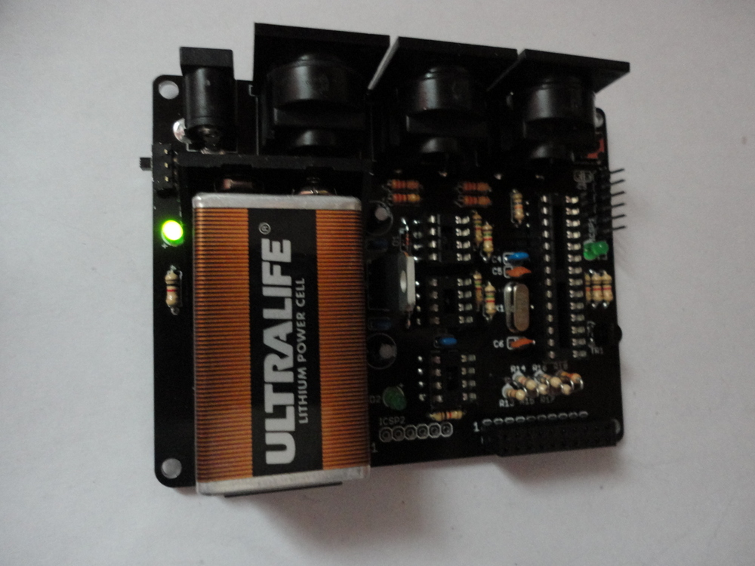
docs/images/DSC01899.JPG
