hotchk155/arpie/docs/images/Dsc01901.jpg

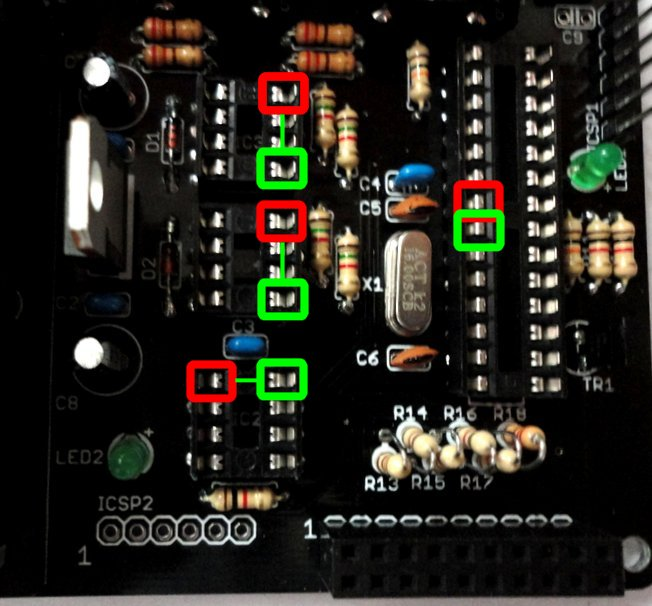
docs/images/Dsc01901.jpg
