hotchk155/arpie/docs/images/Dsc01904.jpg

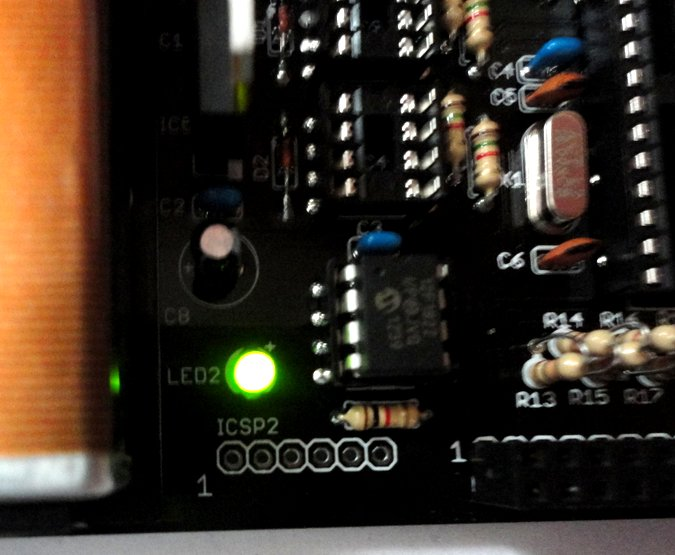
docs/images/Dsc01904.jpg
