hotchk155/arpie/docs/images/Dsc01910.jpg

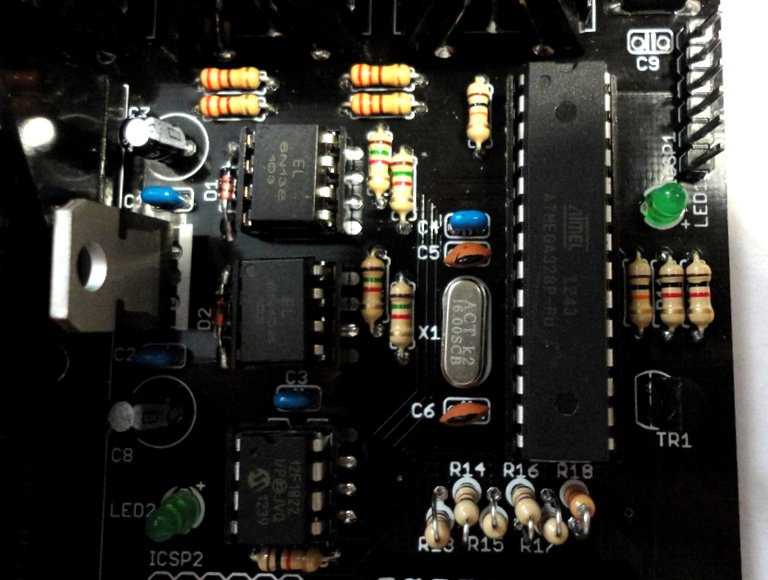
docs/images/Dsc01910.jpg
