hotchk155/arpie/docs/images/Dsc01915.jpg

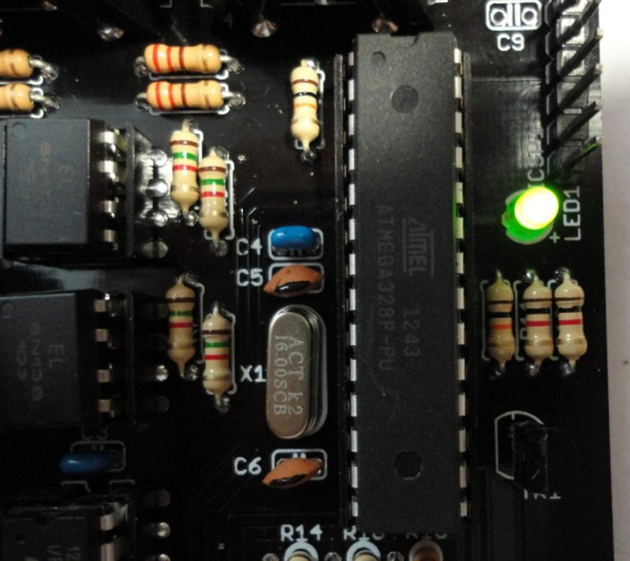
docs/images/Dsc01915.jpg
