hotchk155/arpie/docs/images/Dsc01917.jpg

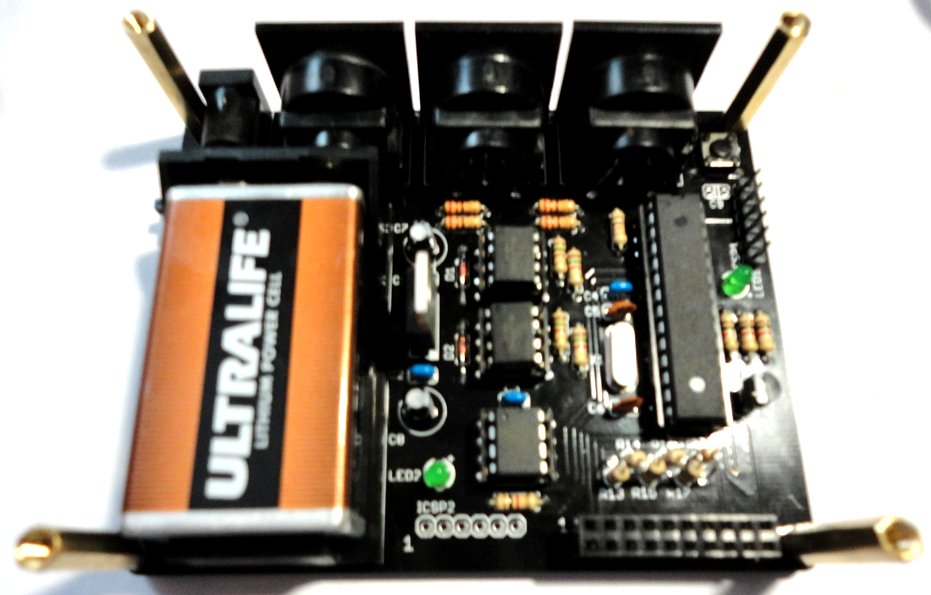
docs/images/Dsc01917.jpg
