hotchk155/arpie/docs/images/Dsc01919.jpg

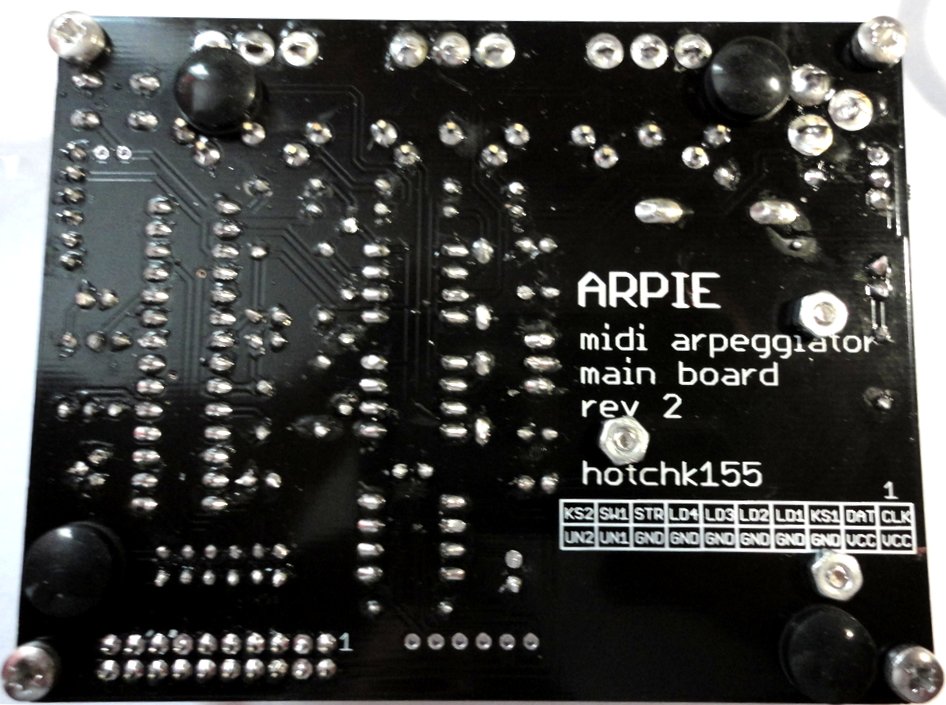
docs/images/Dsc01919.jpg
