hotchk155/arpie/docs/images/Dsc01920.jpg

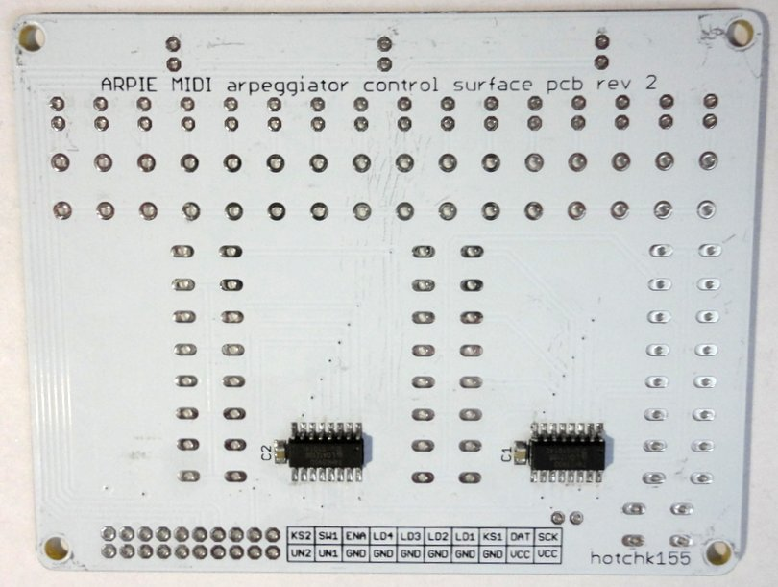
docs/images/Dsc01920.jpg
