hotchk155/arpie/docs/images/Dsc01921.jpg

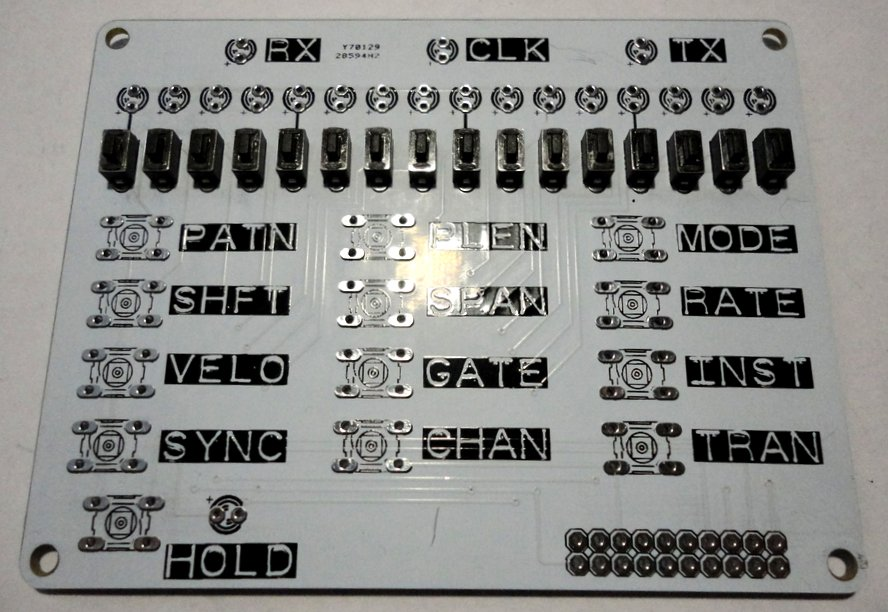
docs/images/Dsc01921.jpg
