hotchk155/arpie/docs/images/Dsc01922.jpg

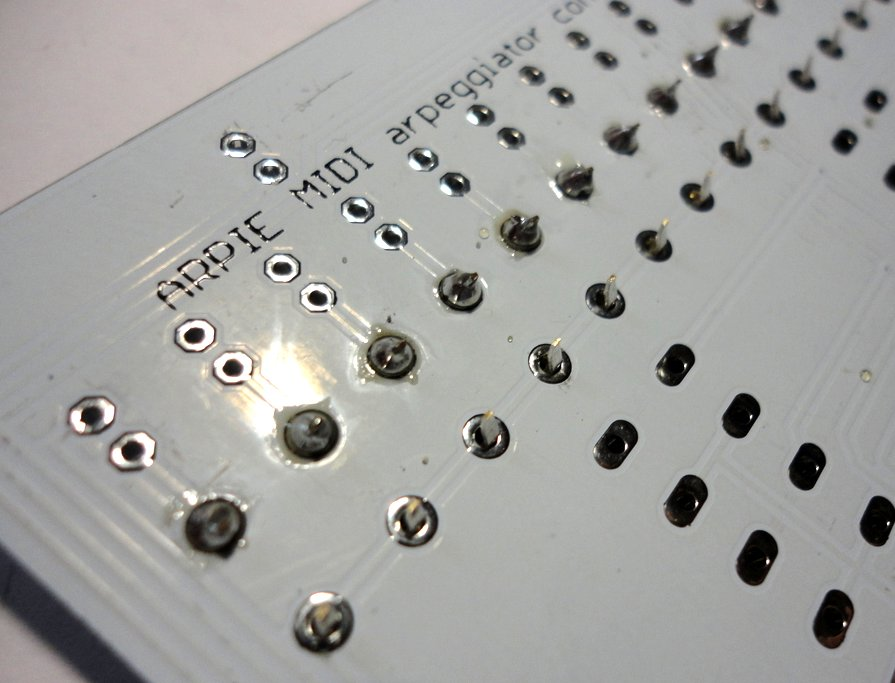
docs/images/Dsc01922.jpg
