hotchk155/arpie/docs/images/Dsc01924.jpg

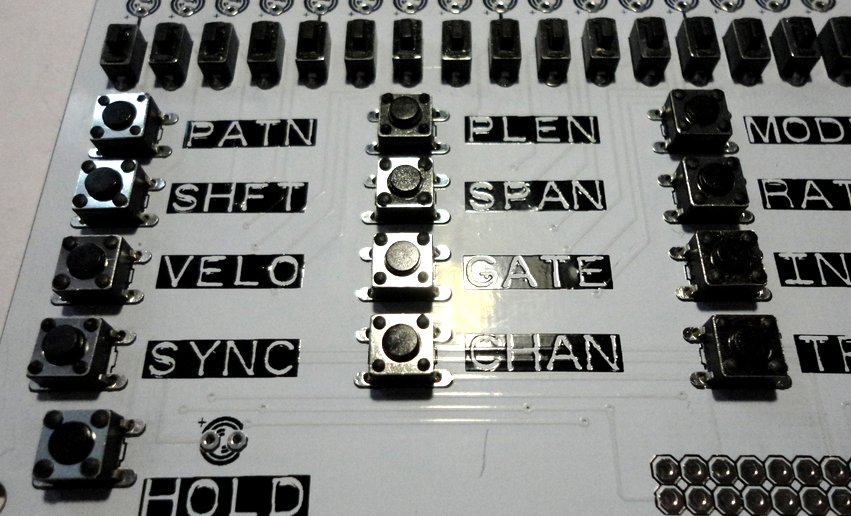
docs/images/Dsc01924.jpg
