hotchk155/arpie/docs/images/Dsc01925.jpg

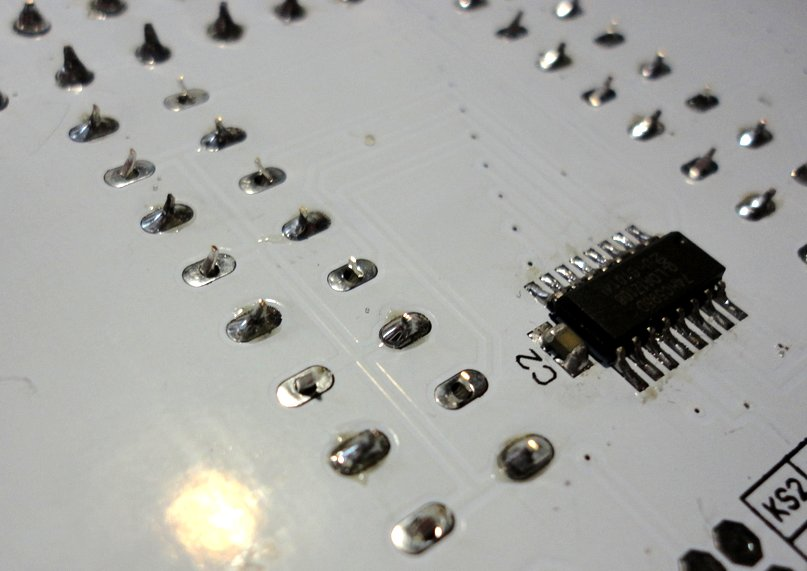
docs/images/Dsc01925.jpg
