hotchk155/arpie/docs/images/Dsc01928.jpg

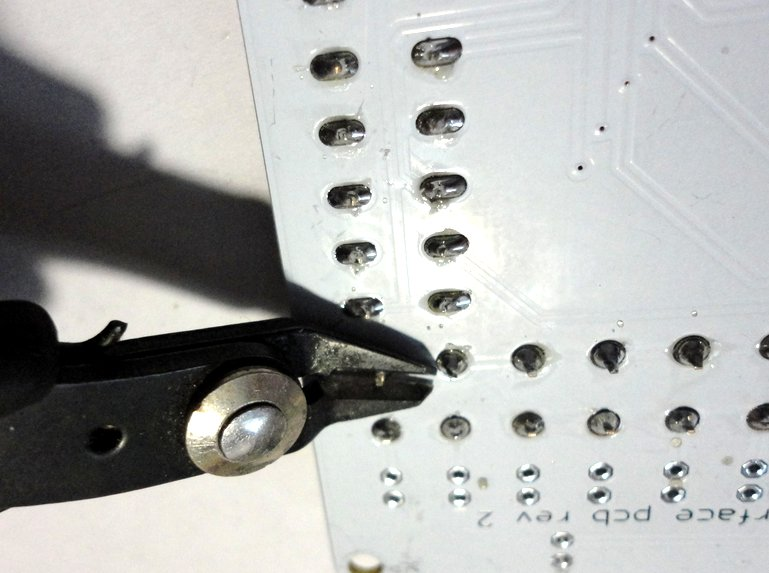
docs/images/Dsc01928.jpg
