hotchk155/arpie/docs/images/Dsc01929.jpg

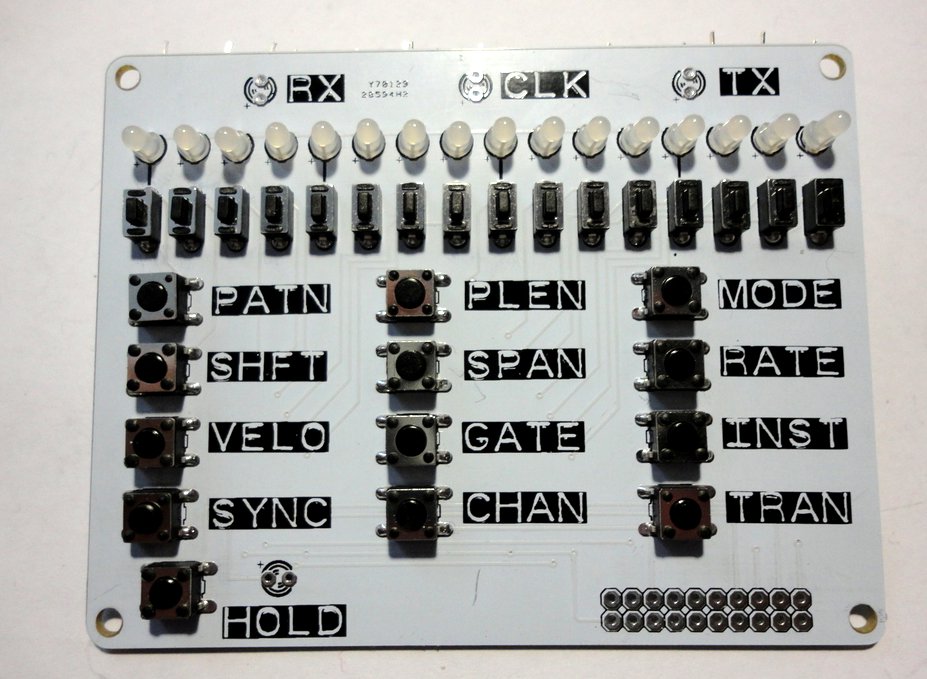
docs/images/Dsc01929.jpg
