hotchk155/arpie/docs/images/Dsc01931.jpg

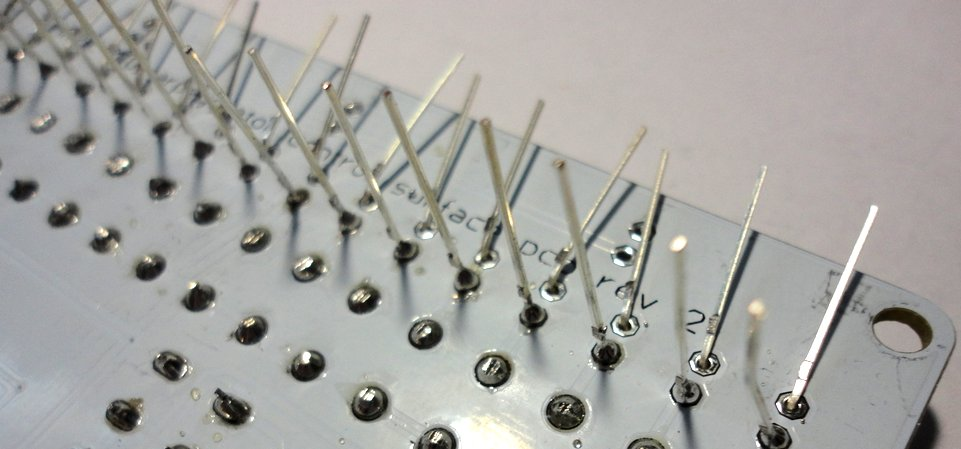
docs/images/Dsc01931.jpg
