hotchk155/arpie/docs/images/Dsc01932.jpg

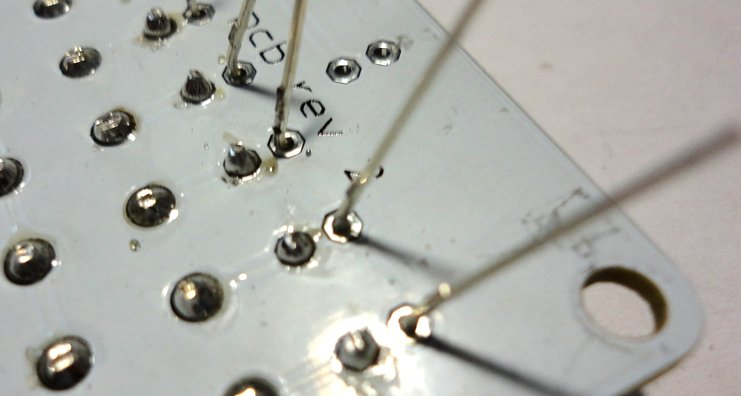
docs/images/Dsc01932.jpg
