hotchk155/arpie/docs/images/DSC01933.JPG

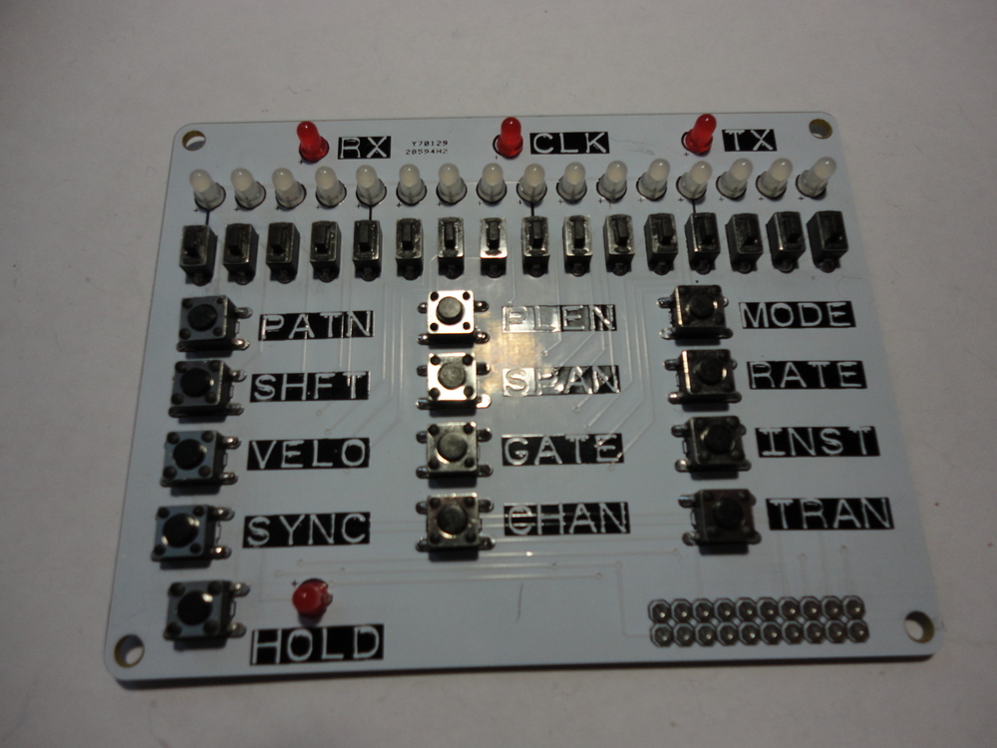
docs/images/DSC01933.JPG
