hotchk155/arpie/docs/images/Dsc01934.jpg

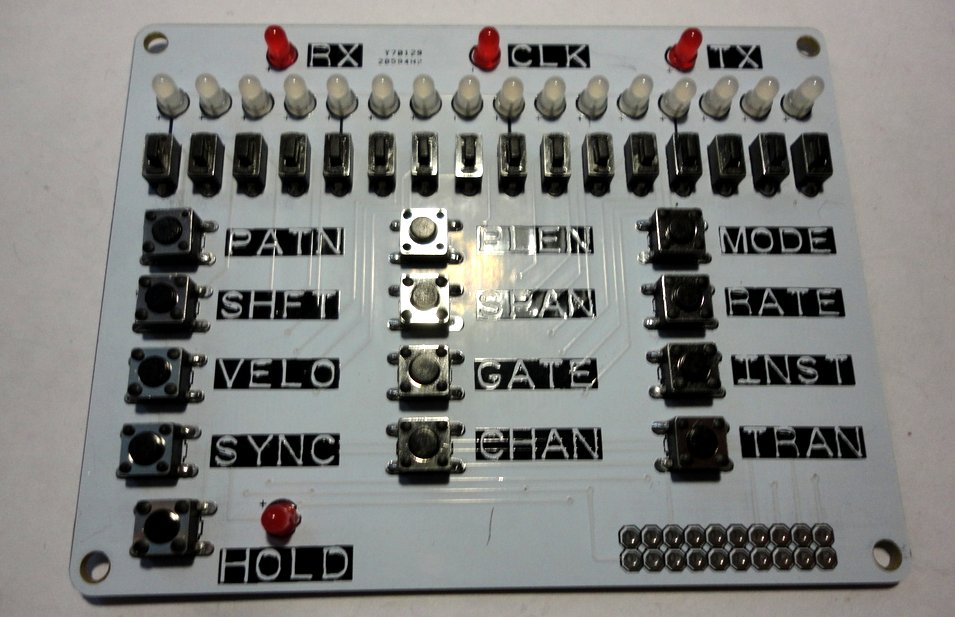
docs/images/Dsc01934.jpg
