hotchk155/arpie/docs/images/Dsc01936.jpg

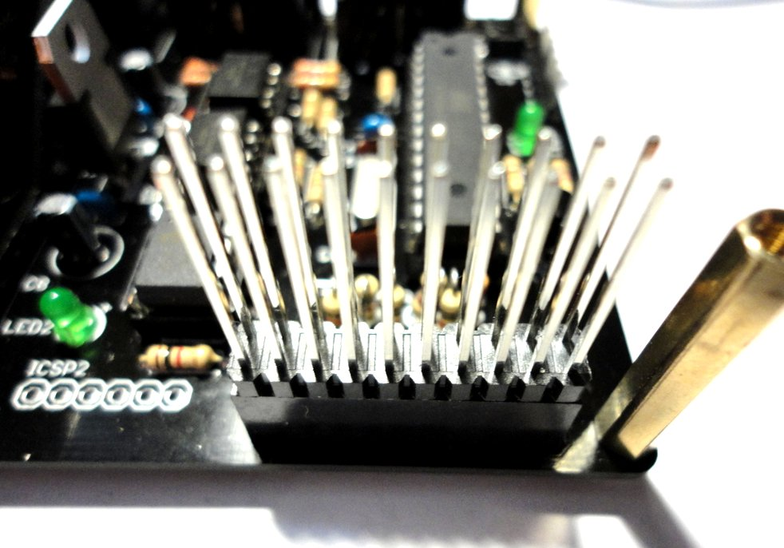
docs/images/Dsc01936.jpg
