hotchk155/arpie/docs/images/Dsc01938.jpg

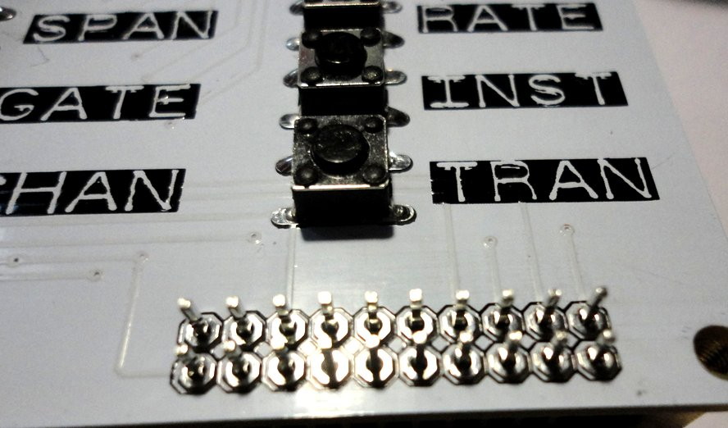
docs/images/Dsc01938.jpg
