hotchk155/arpie/docs/images/Dsc01939.jpg

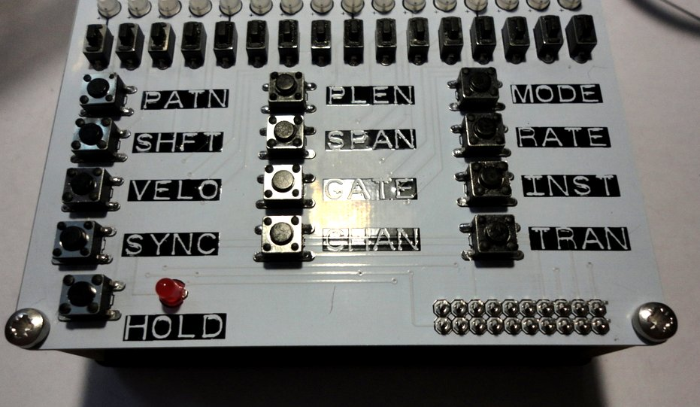
docs/images/Dsc01939.jpg
