hotchk155/arpie/docs/images/Dsc01941.jpg

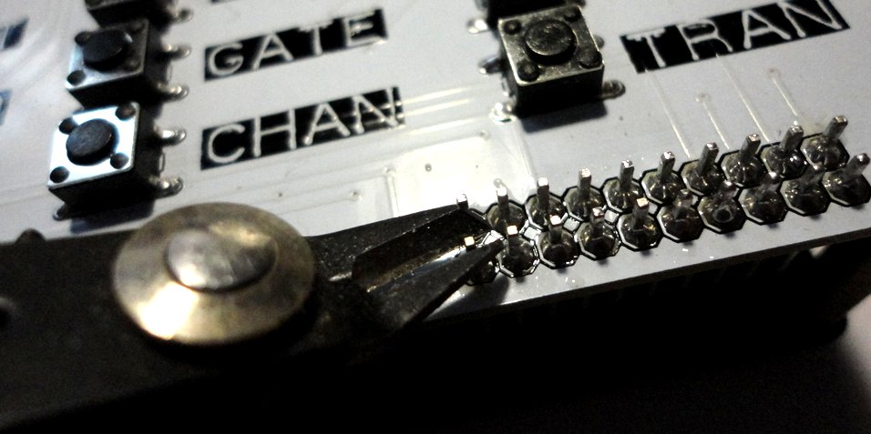
docs/images/Dsc01941.jpg
