hotchk155/arpie/docs/images/Dsc01943.jpg

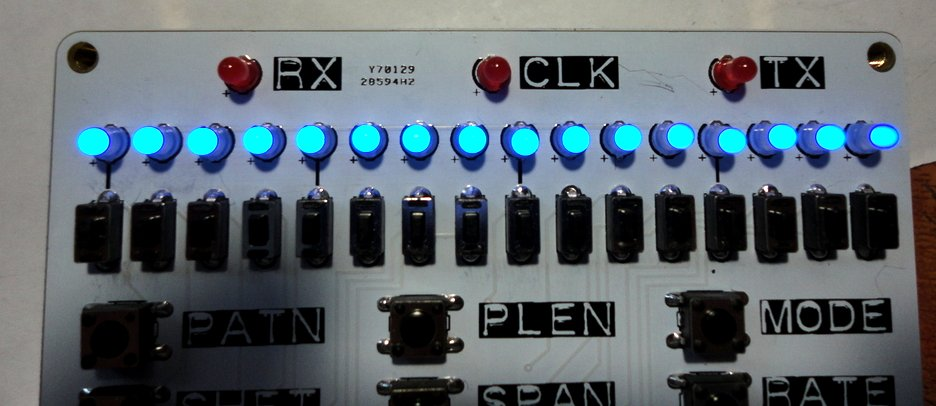
docs/images/Dsc01943.jpg
