hotchk155/arpie/docs/images/Dsc01945.jpg

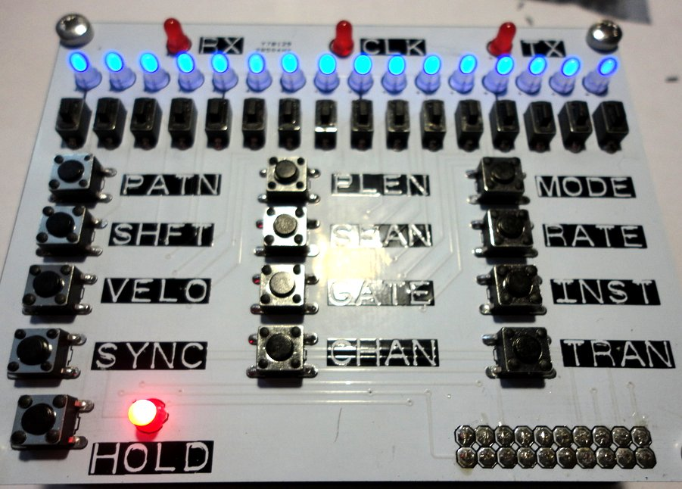
docs/images/Dsc01945.jpg
