hotchk155/arpie/docs/images/gate.png

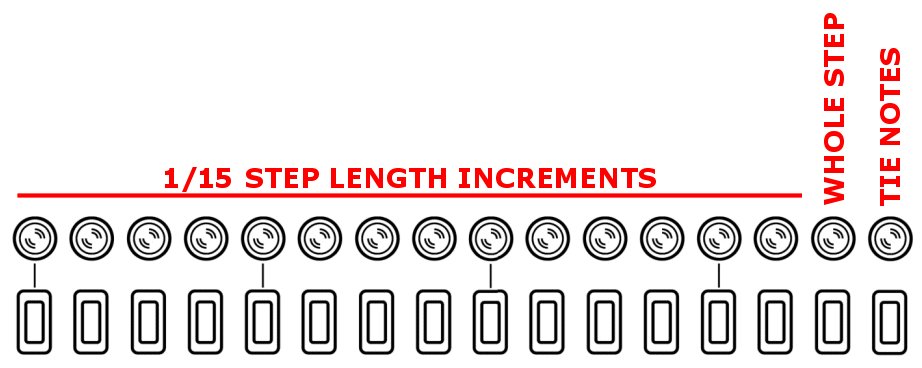
docs/images/gate.png
