hotchk155/arpie/docs/images/globalopts.png

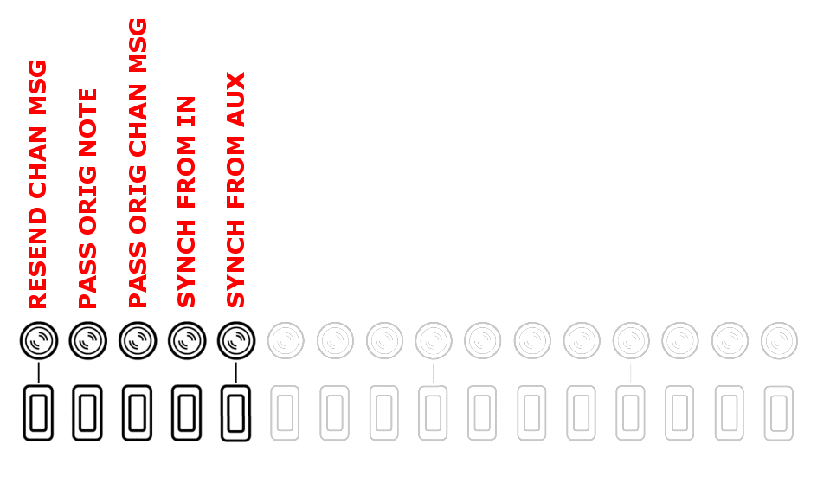
docs/images/globalopts.png
