hotchk155/arpie/docs/images/inst.png

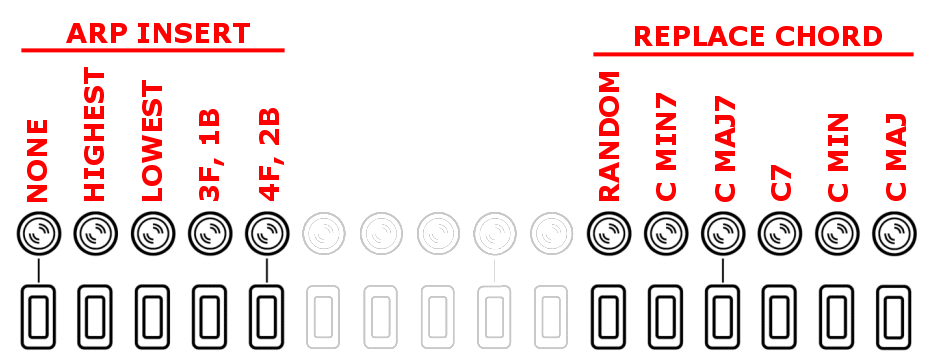
docs/images/inst.png
