hotchk155/arpie/docs/images/kit2.JPG

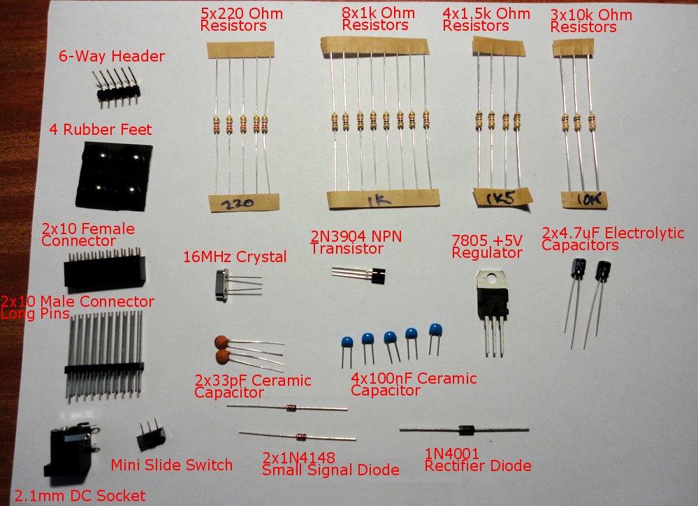
docs/images/kit2.JPG
