hotchk155/arpie/docs/images/kit3.JPG

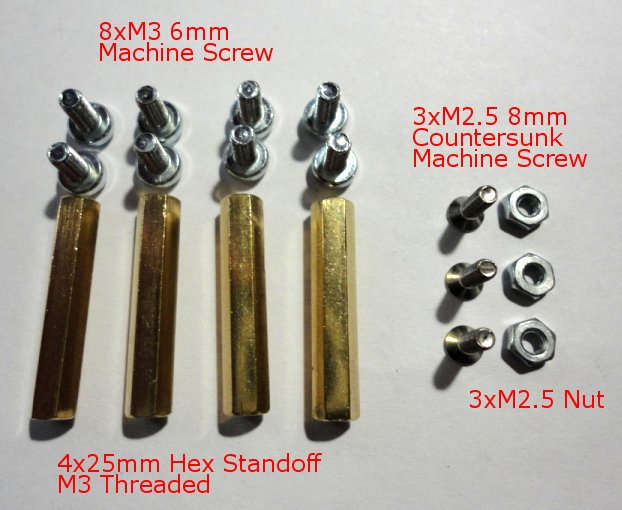
docs/images/kit3.JPG
