hotchk155/arpie/docs/images/kit4.JPG

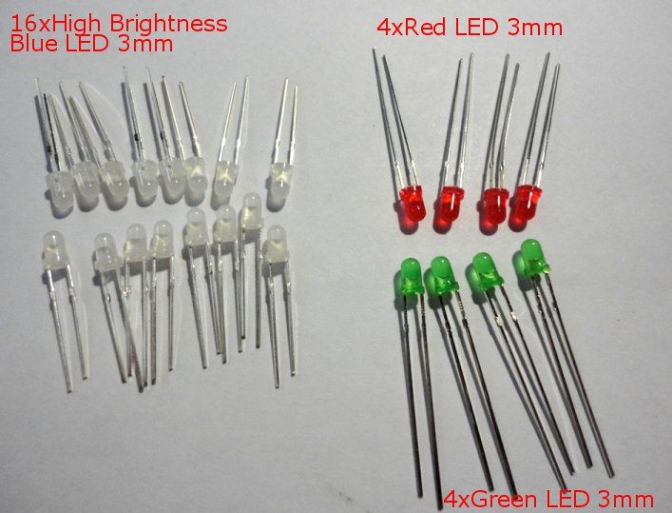
docs/images/kit4.JPG
