hotchk155/arpie/docs/images/kit5.JPG

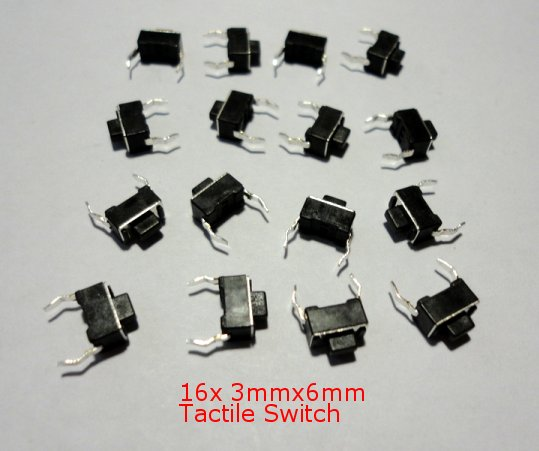
docs/images/kit5.JPG
