hotchk155/arpie/docs/images/kit6.JPG

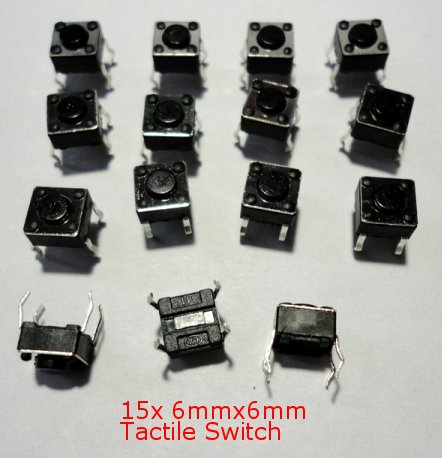
docs/images/kit6.JPG
