hotchk155/arpie/docs/images/kit7.JPG

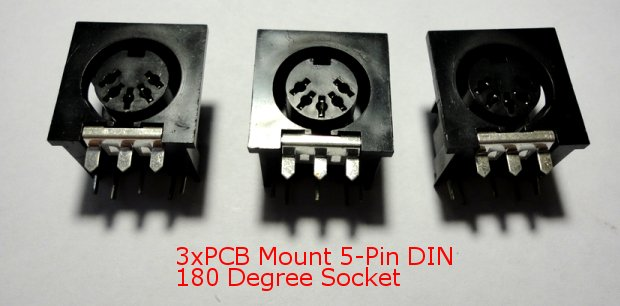
docs/images/kit7.JPG
