hotchk155/arpie/docs/images/kit8.JPG

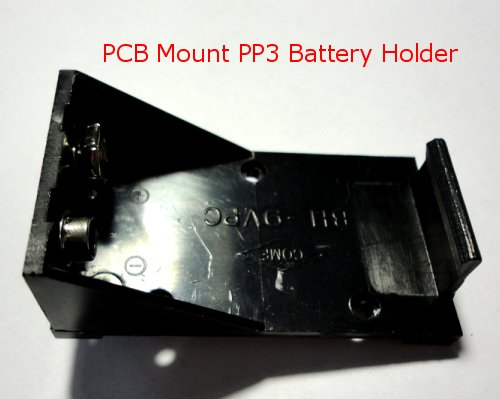
docs/images/kit8.JPG
