hotchk155/arpie/docs/images/kit9.JPG

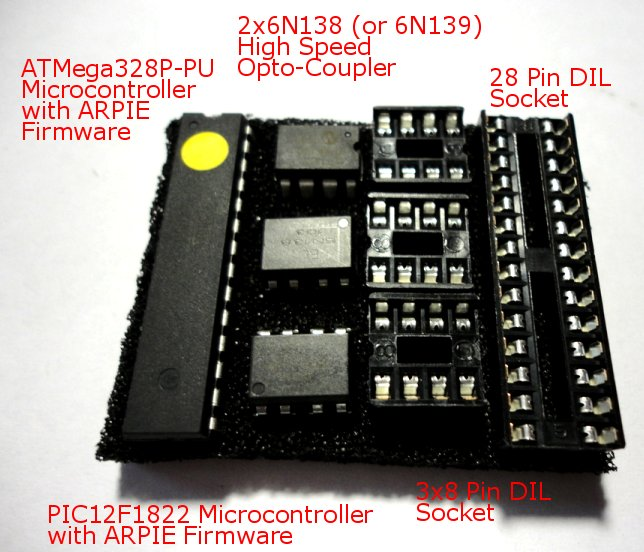
docs/images/kit9.JPG
