hotchk155/arpie/docs/images/kit.JPG

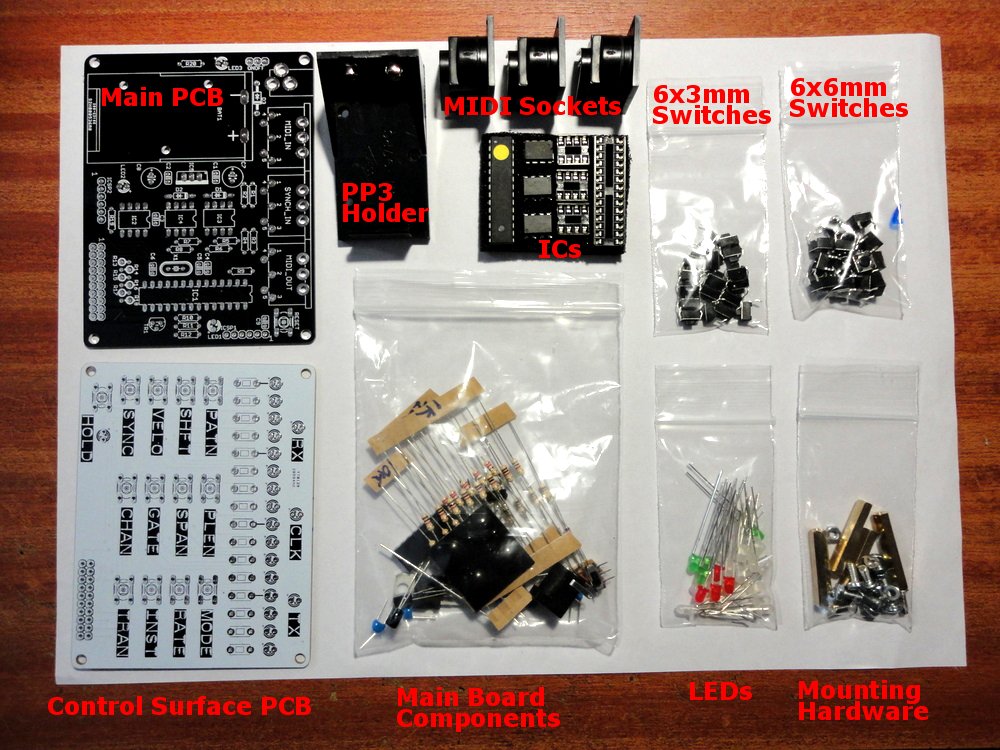
docs/images/kit.JPG
