hotchk155/arpie/docs/images/mode7.png

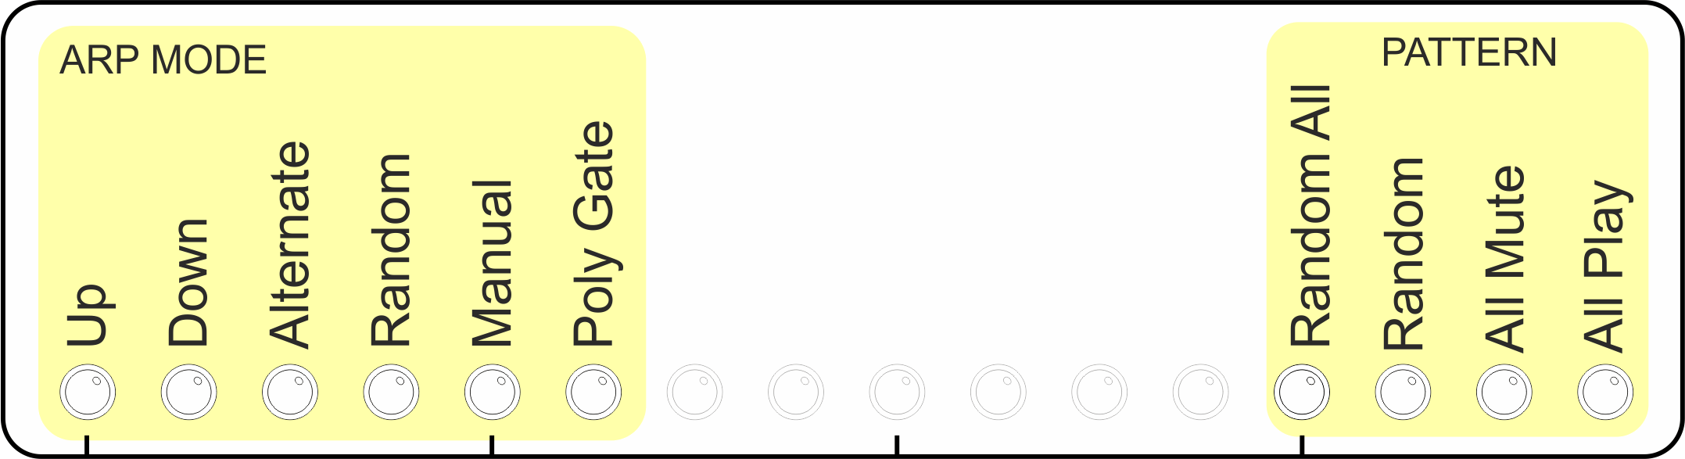
docs/images/mode7.png
