hotchk155/arpie/docs/images/mods1.jpg

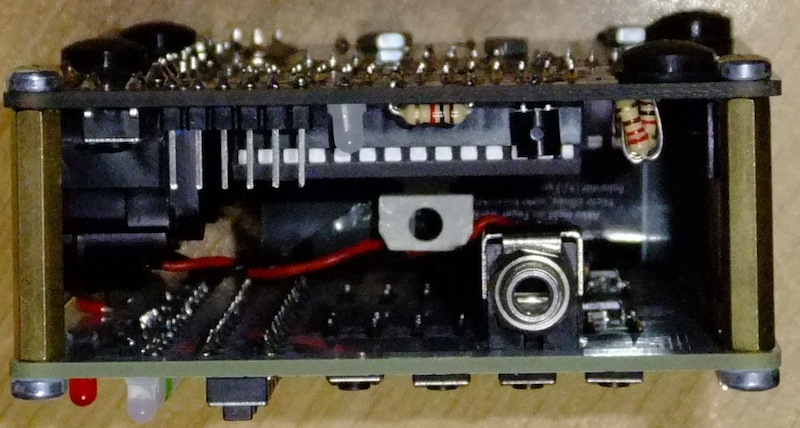
docs/images/mods1.jpg
