hotchk155/arpie/docs/images/mods2.jpg

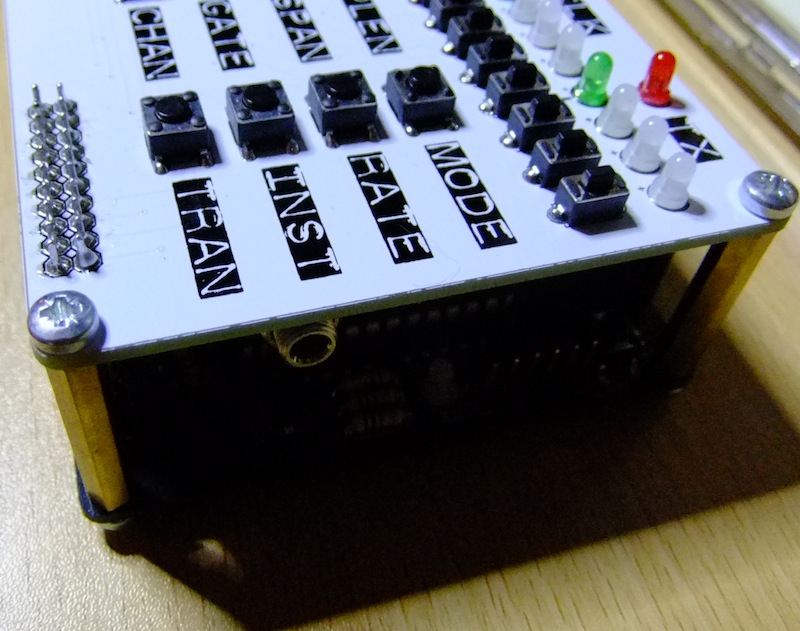
docs/images/mods2.jpg
