hotchk155/arpie/docs/images/mods3.jpg

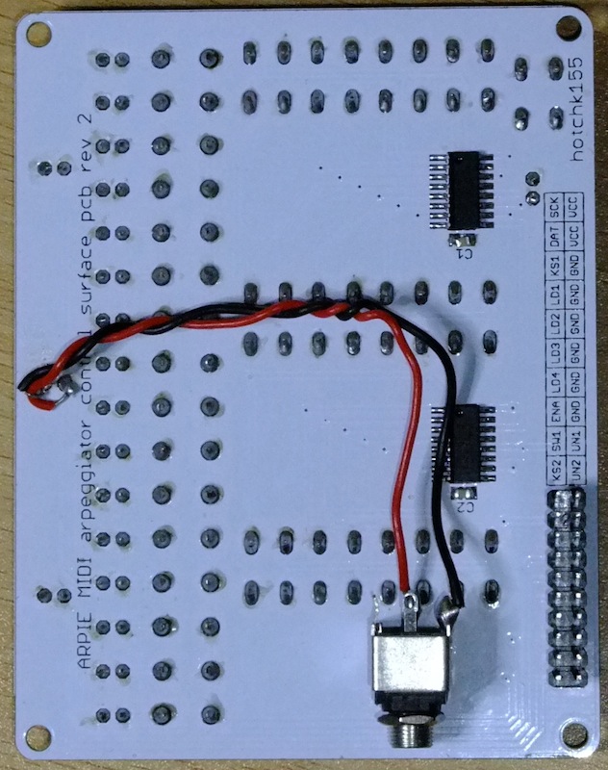
docs/images/mods3.jpg
