hotchk155/arpie/docs/images/overview.png

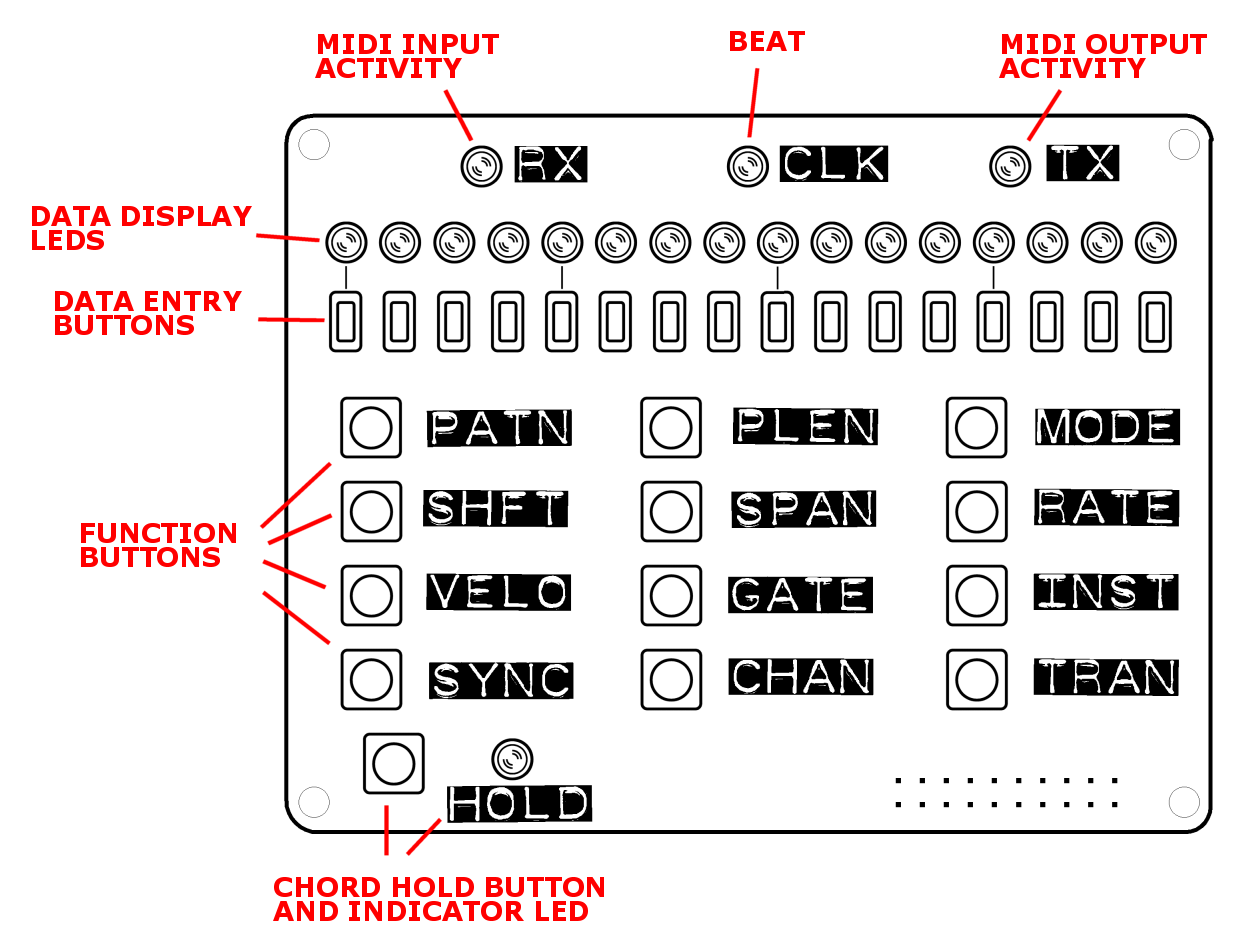
docs/images/overview.png
