hotchk155/arpie/docs/images/pattern_ext.png

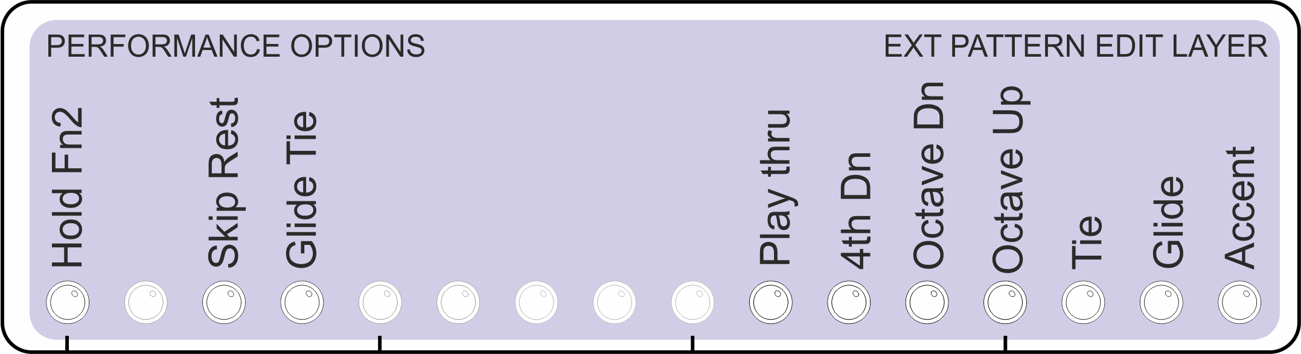
docs/images/pattern_ext.png
