hotchk155/arpie/docs/images/prog1.JPG

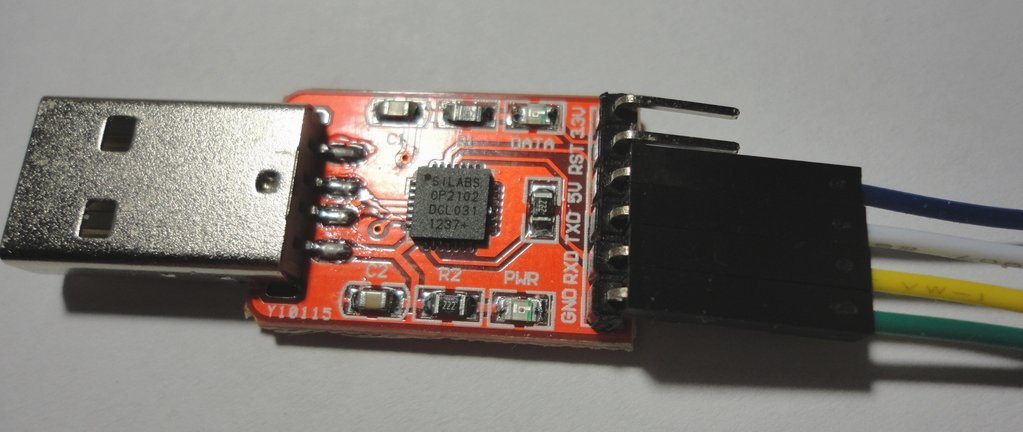
docs/images/prog1.JPG
