hotchk155/arpie/docs/images/prog2.JPG

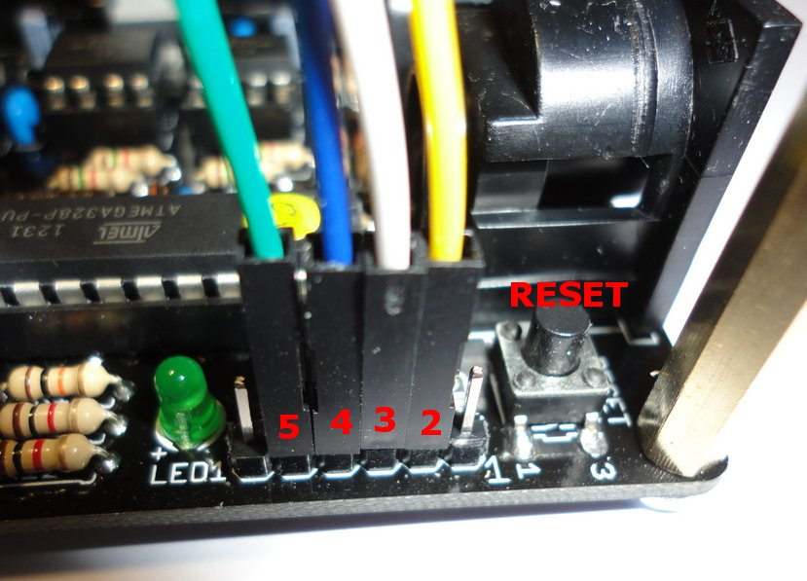
docs/images/prog2.JPG
