hotchk155/arpie/docs/images/prog3.JPG

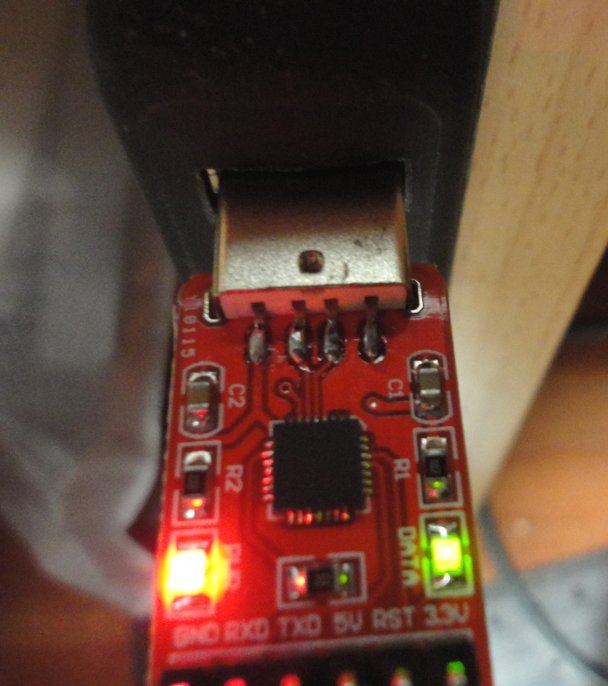
docs/images/prog3.JPG
