hotchk155/arpie/docs/images/prog4.JPG

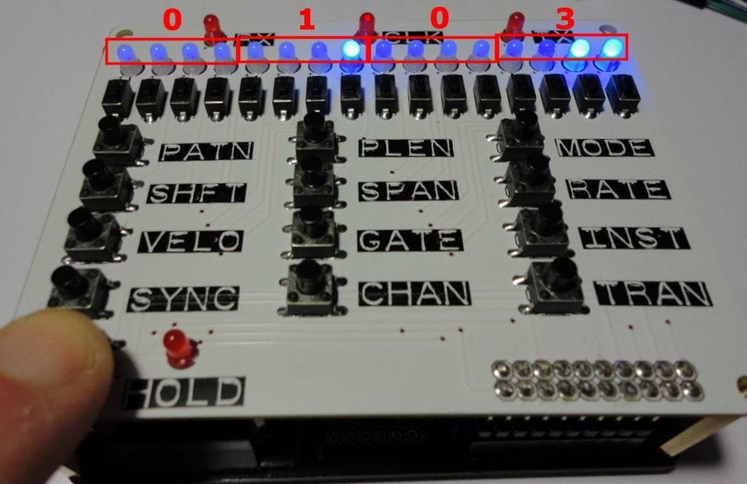
docs/images/prog4.JPG
