hotchk155/arpie/docs/images/rate.png

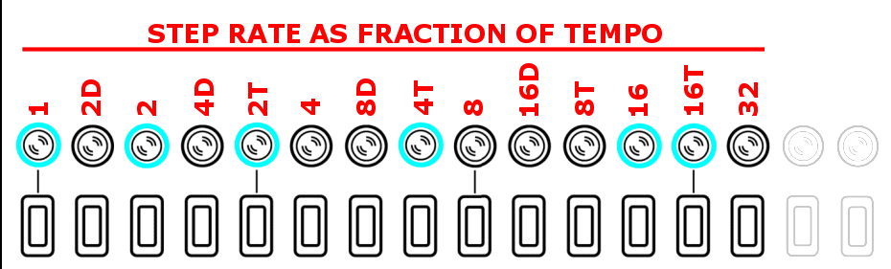
docs/images/rate.png
