hotchk155/arpie/docs/images/rear.png

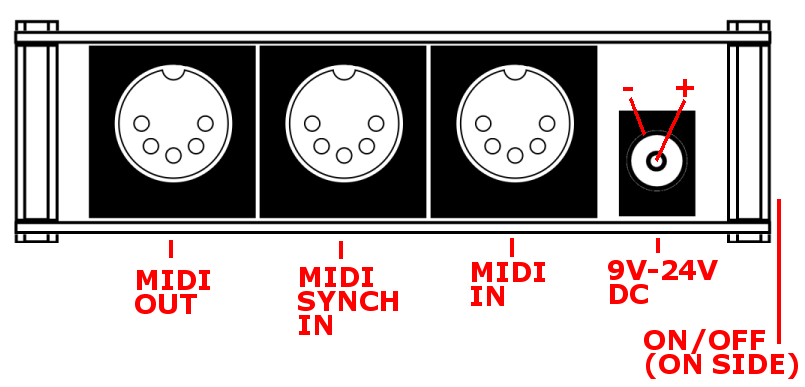
docs/images/rear.png
