hotchk155/arpie/docs/images/shift.png

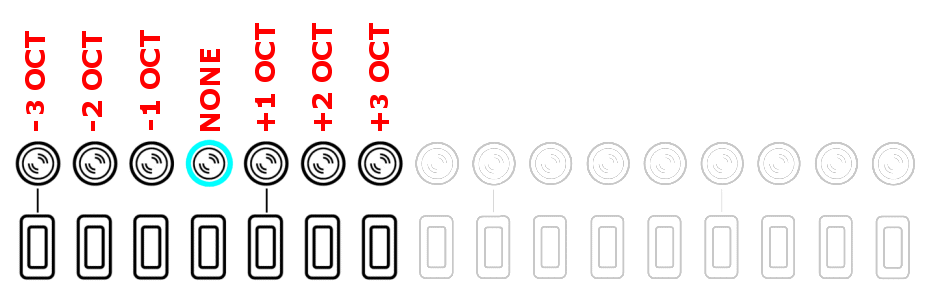
docs/images/shift.png
