hotchk155/arpie/docs/images/simons_case2.jpg

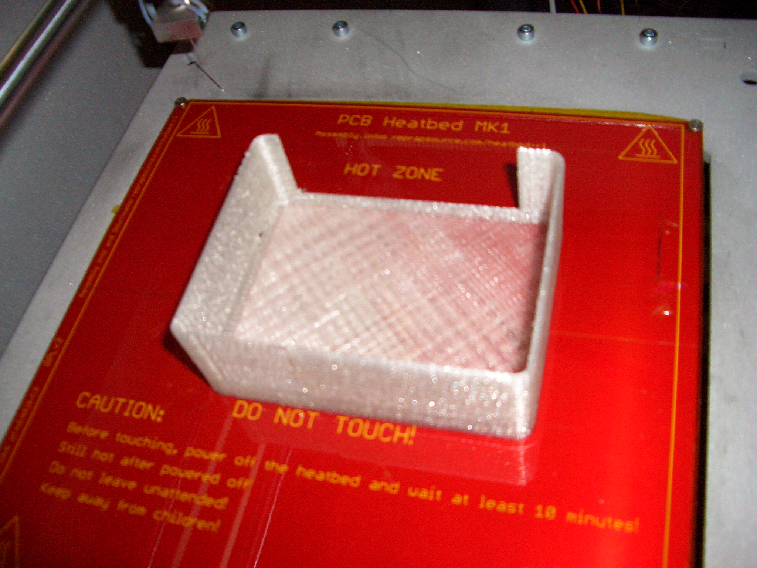
docs/images/simons_case2.jpg
