hotchk155/arpie/docs/images/simons_case.jpg

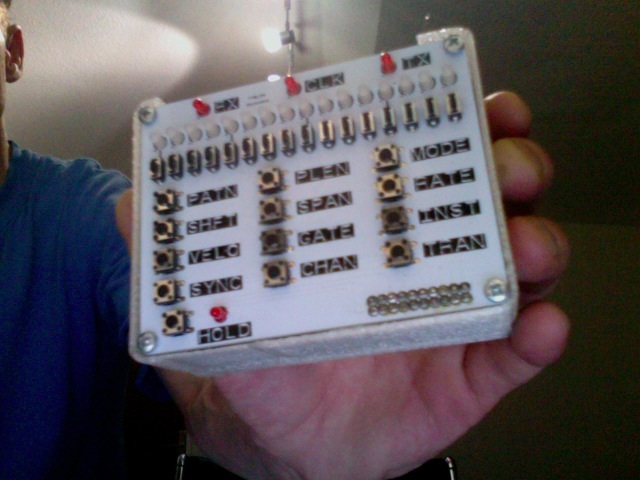
docs/images/simons_case.jpg
