hotchk155/arpie/docs/images/span.png

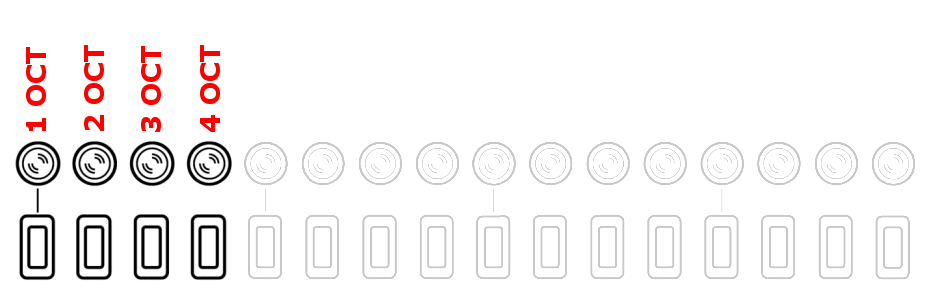
docs/images/span.png
