hotchk155/arpie/docs/images/sync.png

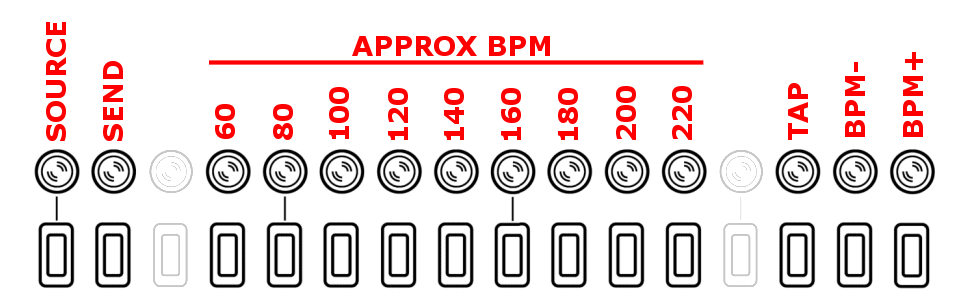
docs/images/sync.png
