hotchk155/arpie/docs/images/tran.png

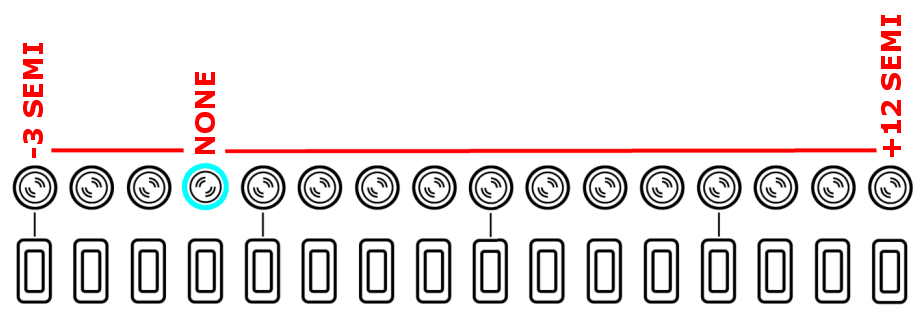
docs/images/tran.png
