hotchk155/arpie/docs/images/type.png

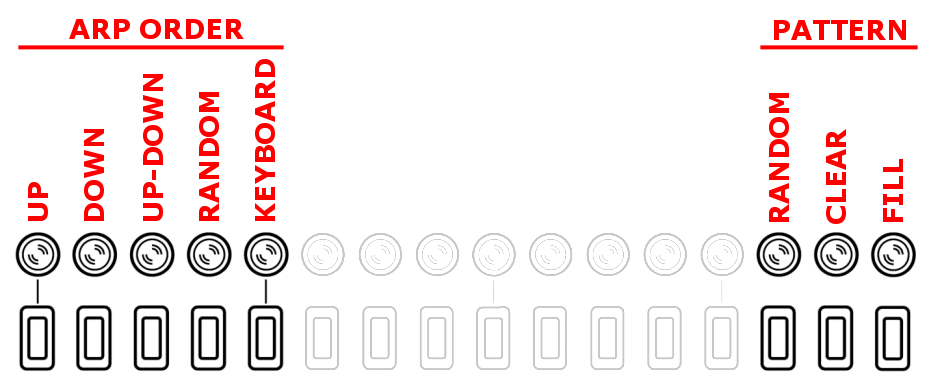
docs/images/type.png
