hotchk155/arpie/docs/images/velo.png

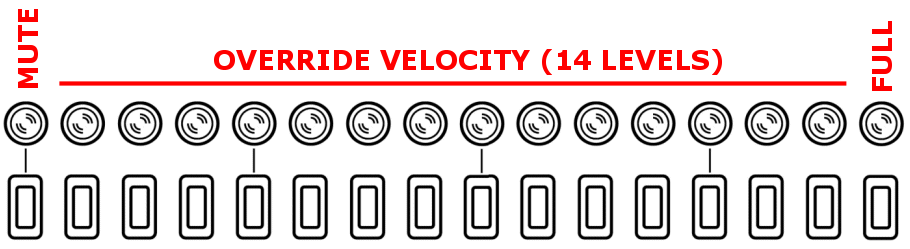
docs/images/velo.png
