hotchk155/arpie/hardware/control.png

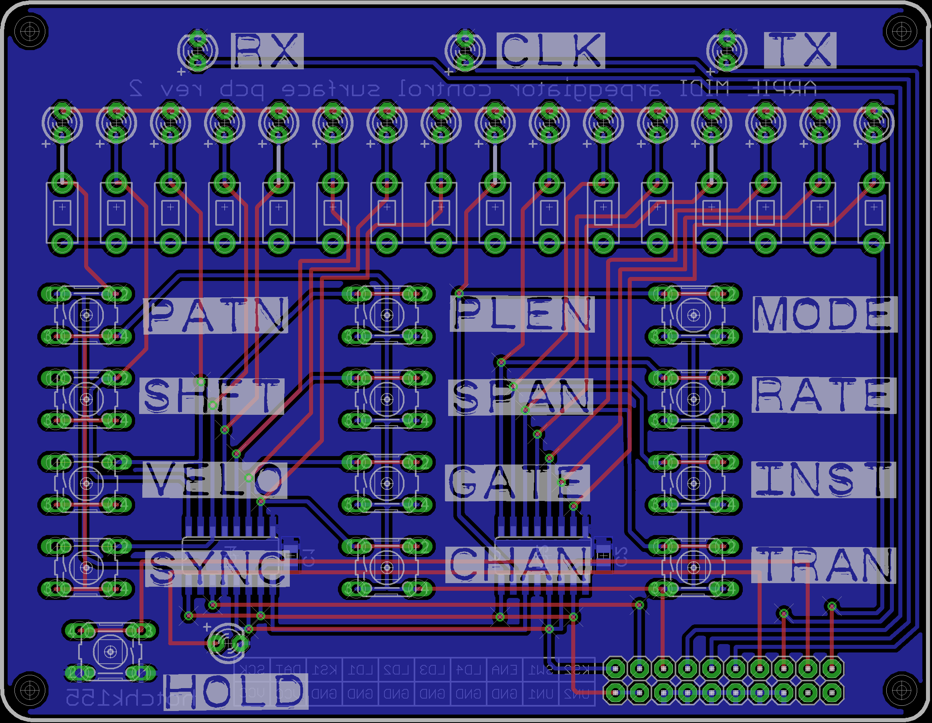
hardware/control.png
