hotchk155/arpie/hardware/control_sch.png

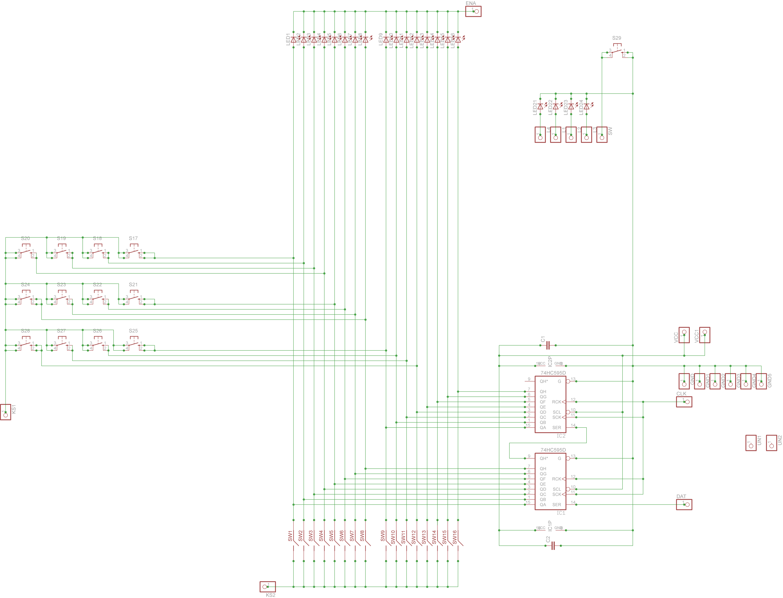
hardware/control_sch.png
