hotchk155/arpie/hardware/main.png

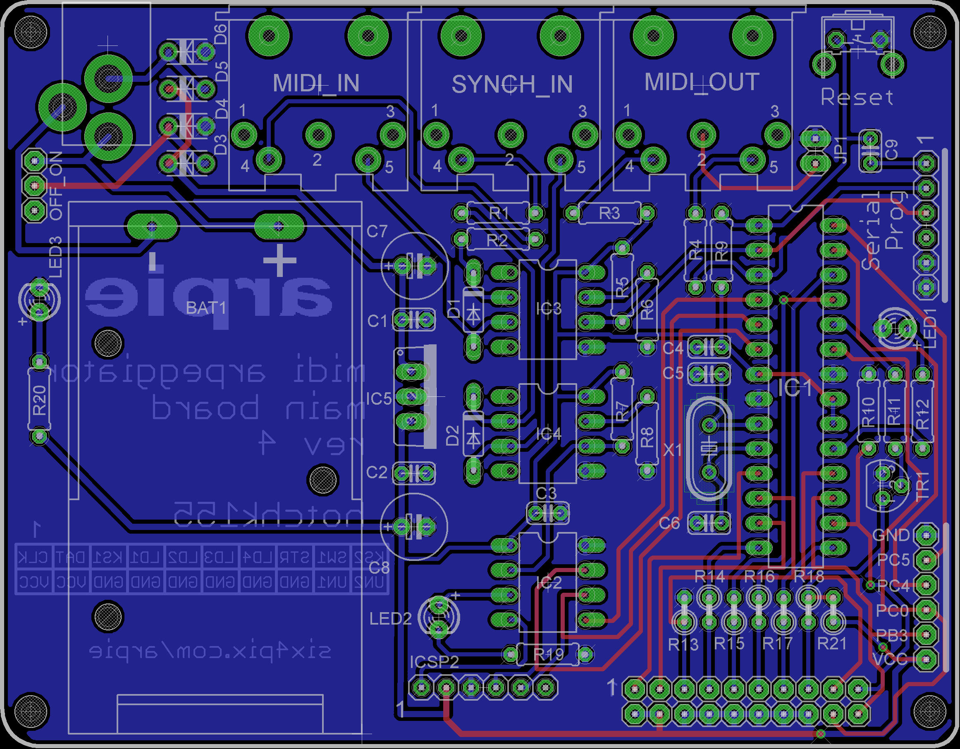
hardware/main.png
