hotchk155/arpie/hardware/main_sch.png

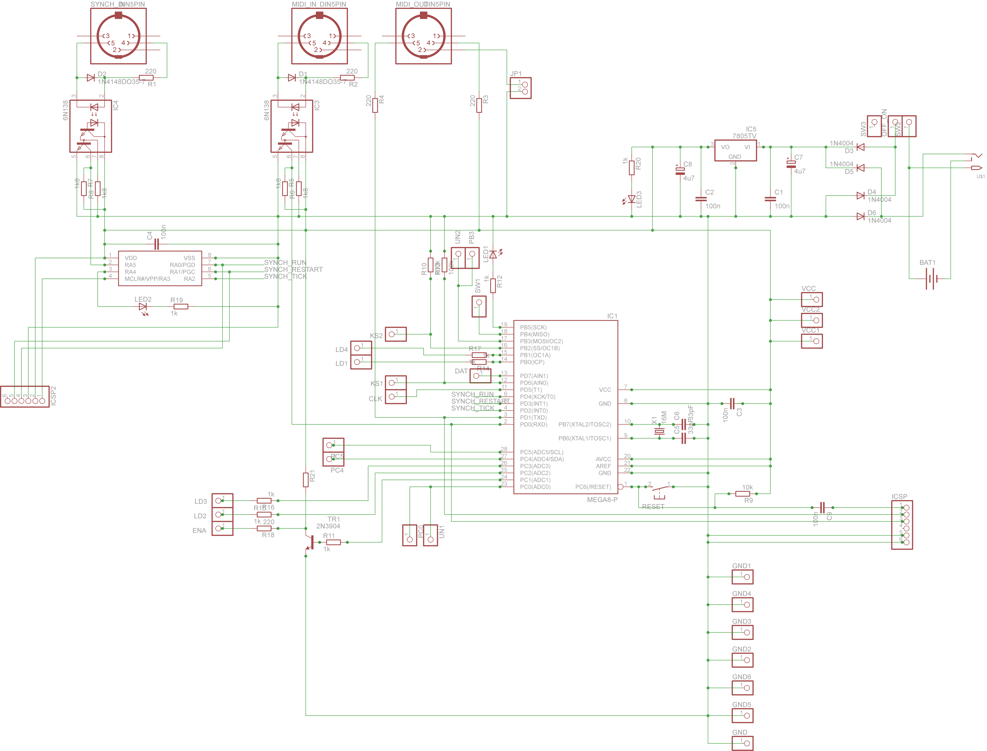
hardware/main_sch.png
