hotchk155/arpie/case/case parts.txt

4 x 3mm spacer
4 x 12mm pan head M3 screw
4 x Self adhesive feet

2 x 12mm M3 hex screw
2 x Flange nut

1 x Switch actuator laser cut
