hotchk155/arpie/case/arpiecase-5mm.dxf

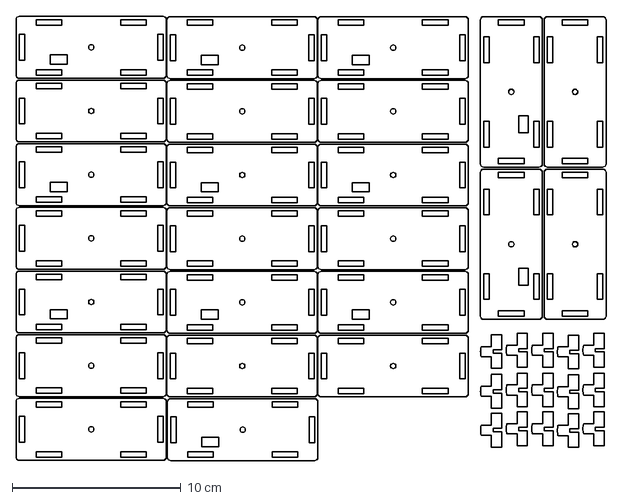
[picture p152: CAD file, 2018-08-25]
case/arpiecase-5mm.dxf
34.9 x 26.3 cm
