hotchk155/arpie/case/arpiecase-3mm_b.dxf

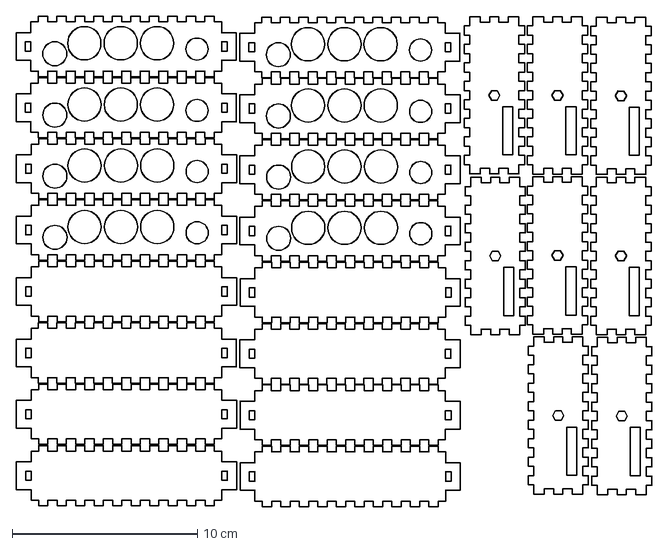
[picture p153: CAD file, 2018-08-25]
case/arpiecase-3mm_b.dxf
34.4 x 26.5 cm
