hotchk155/arpie/case/arpiecase-3mm_a.dxf

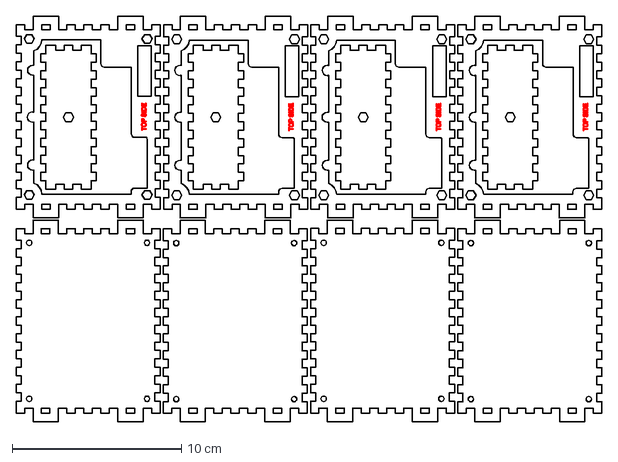
[picture p154: CAD file, 2018-08-25]
case/arpiecase-3mm_a.dxf
34.6 x 24.0 cm
