hotchk155/arpie/case/arpie-case-twin.dxf

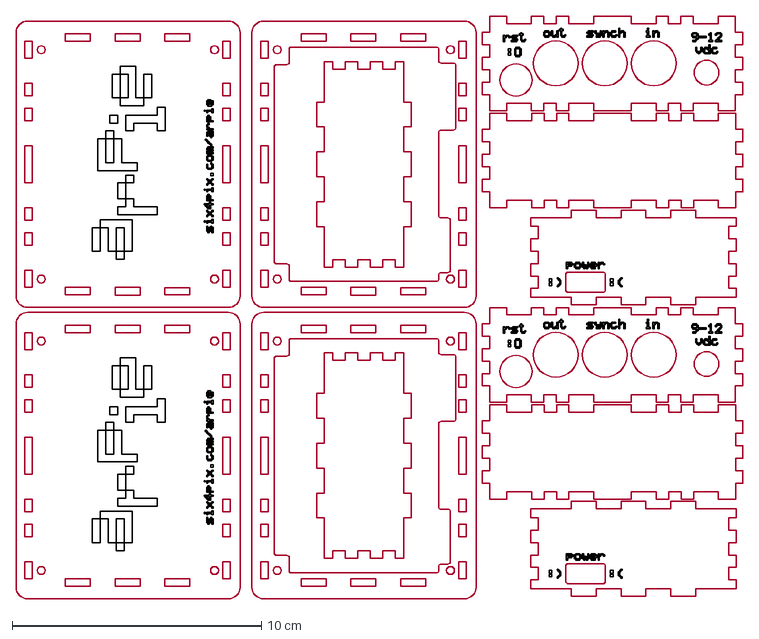
[picture p155: CAD file, 2015-03-02]
case/arpie-case-twin.dxf
29.2 x 23.4 cm
