hotchk155/arpie/docs/images/manual.png

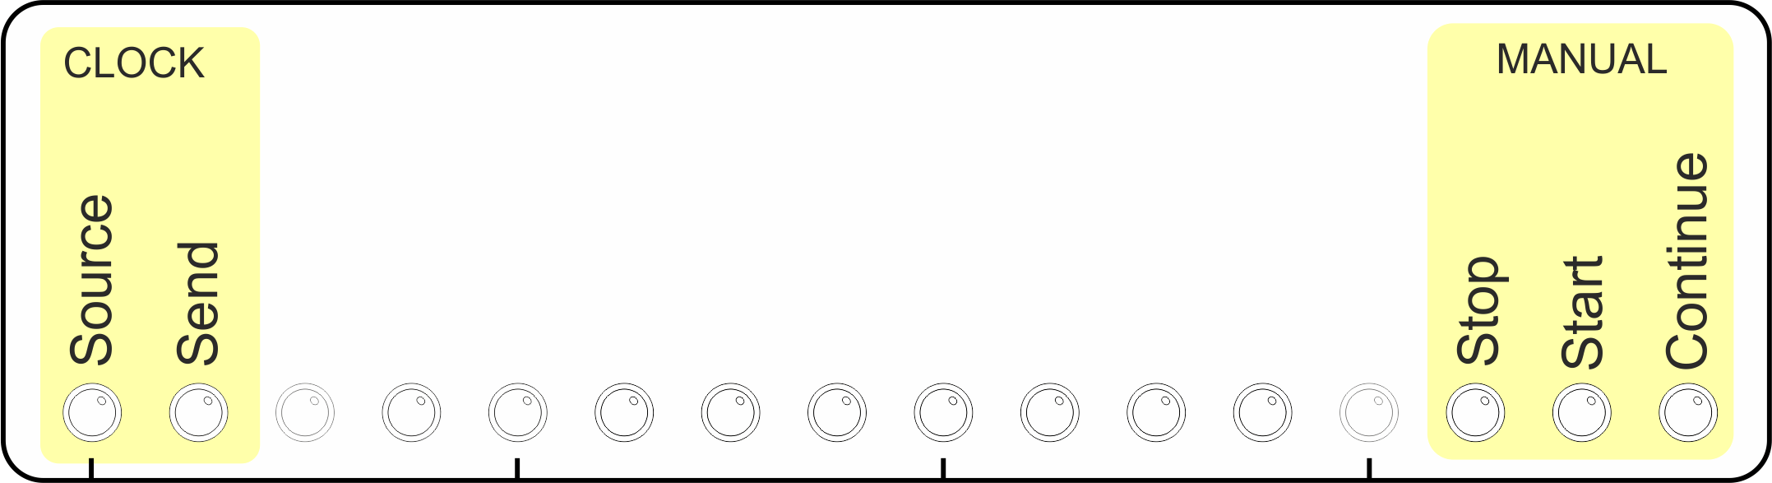
docs/images/manual.png
