hotchk155/arpie/docs/images/manual_chord.png

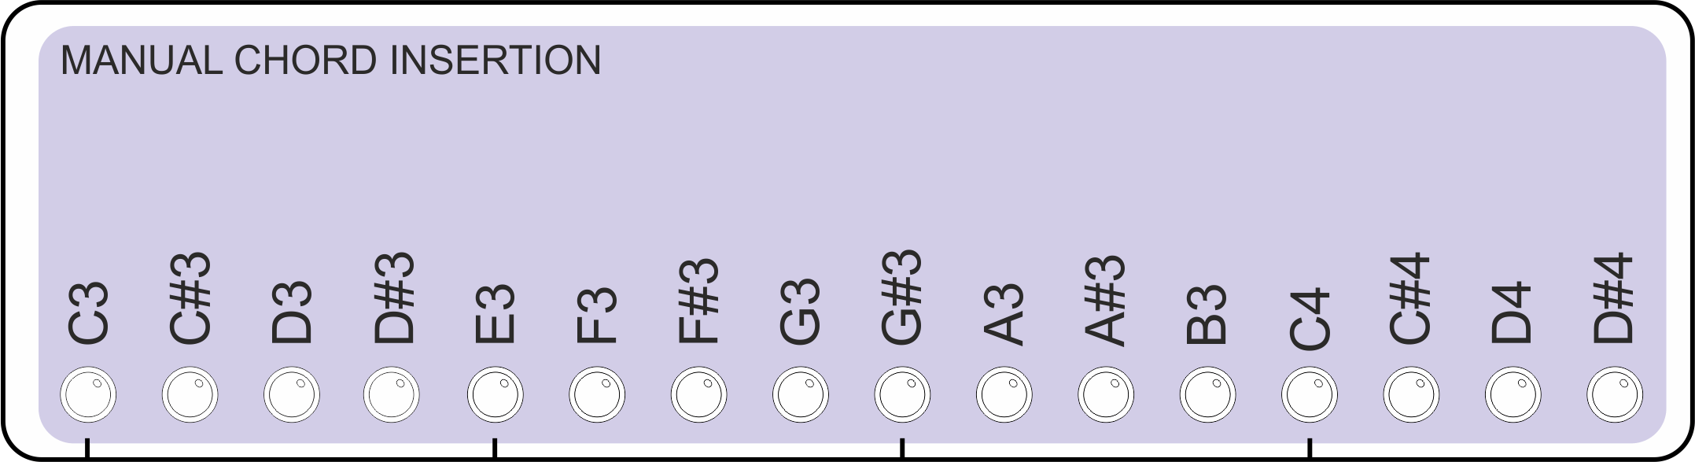
docs/images/manual_chord.png
