hotchk155/arpie/docs/manual/images/CVTAB2.png

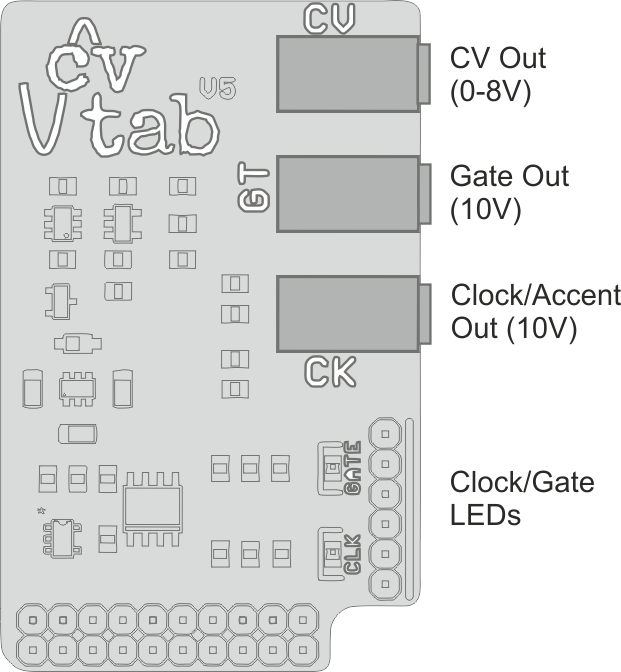
docs/manual/images/CVTAB2.png
