hotchk155/arpie/docs/manual/images/CVTAB.png

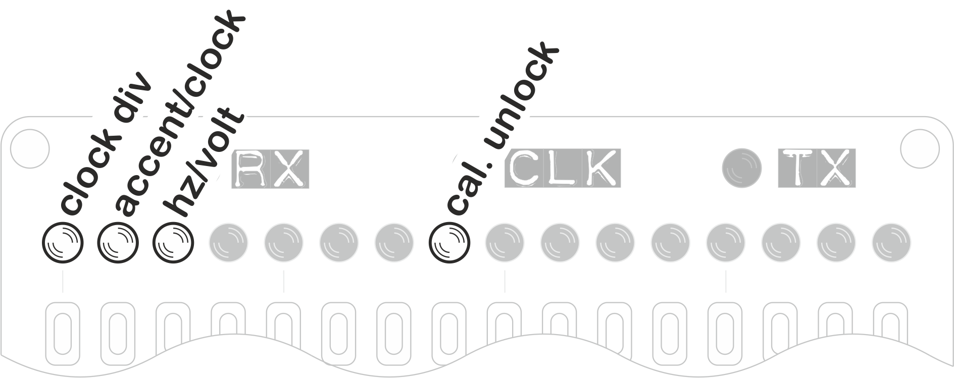
docs/manual/images/CVTAB.png
