hotchk155/arpie/docs/manual/images/GATE.png

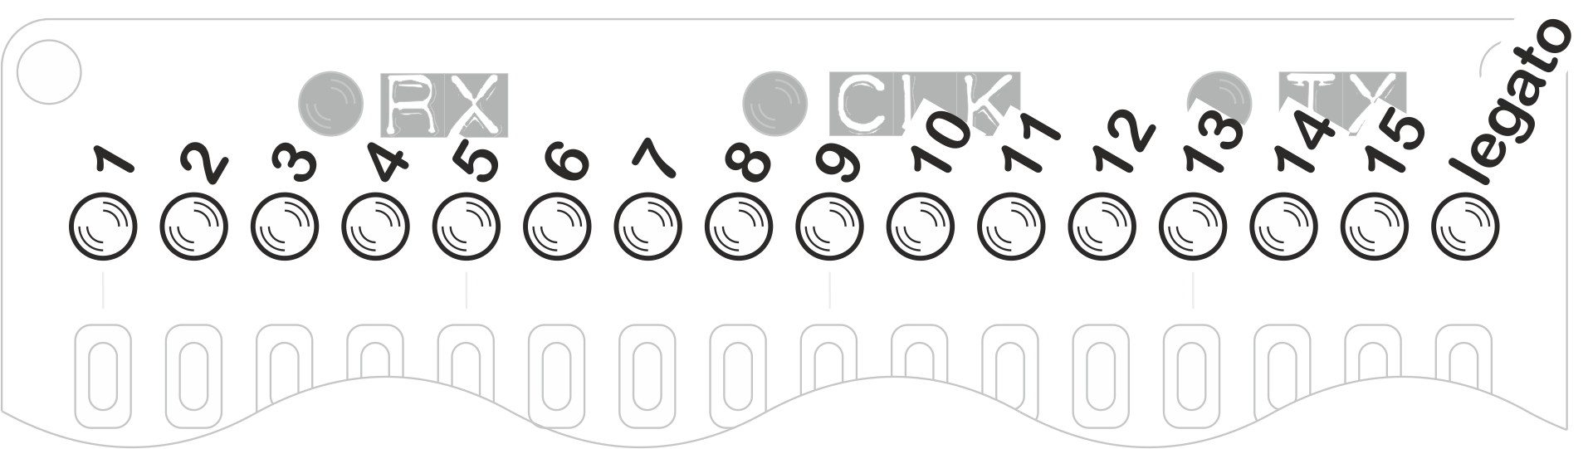
docs/manual/images/GATE.png
