hotchk155/arpie/docs/manual/images/HH.png

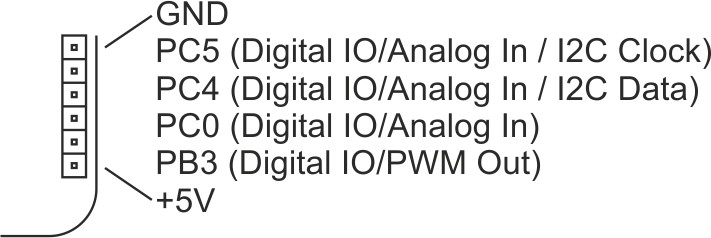
docs/manual/images/HH.png
