hotchk155/arpie/docs/manual/images/HHSEL.png

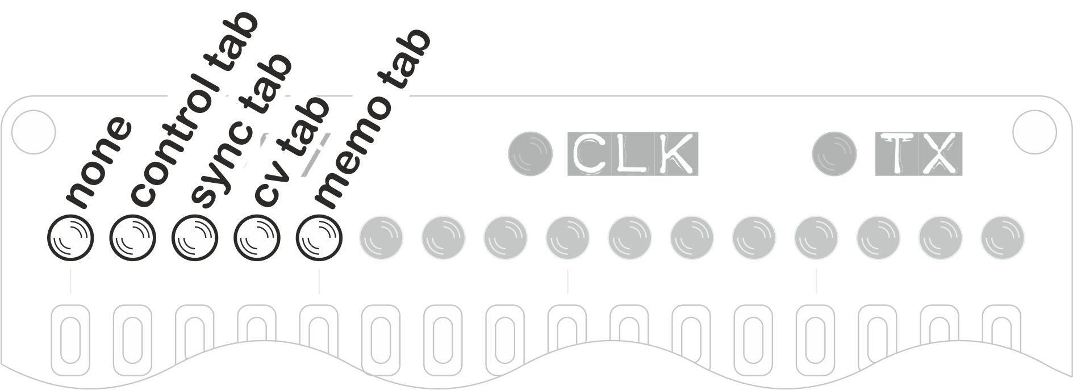
docs/manual/images/HHSEL.png
