hotchk155/arpie/docs/manual/images/PLEN2.png

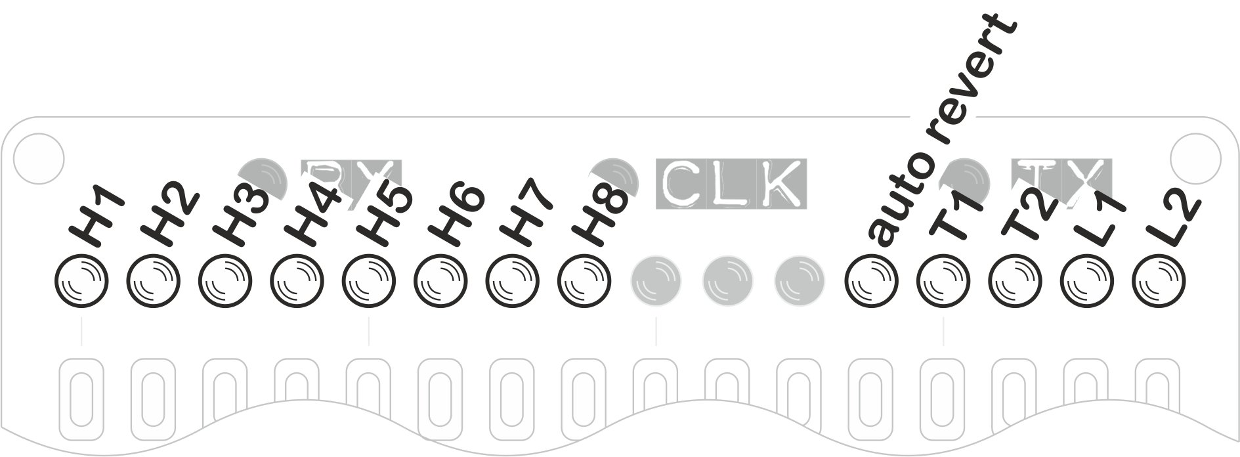
docs/manual/images/PLEN2.png
