hotchk155/arpie/docs/manual/images/PLEN.png

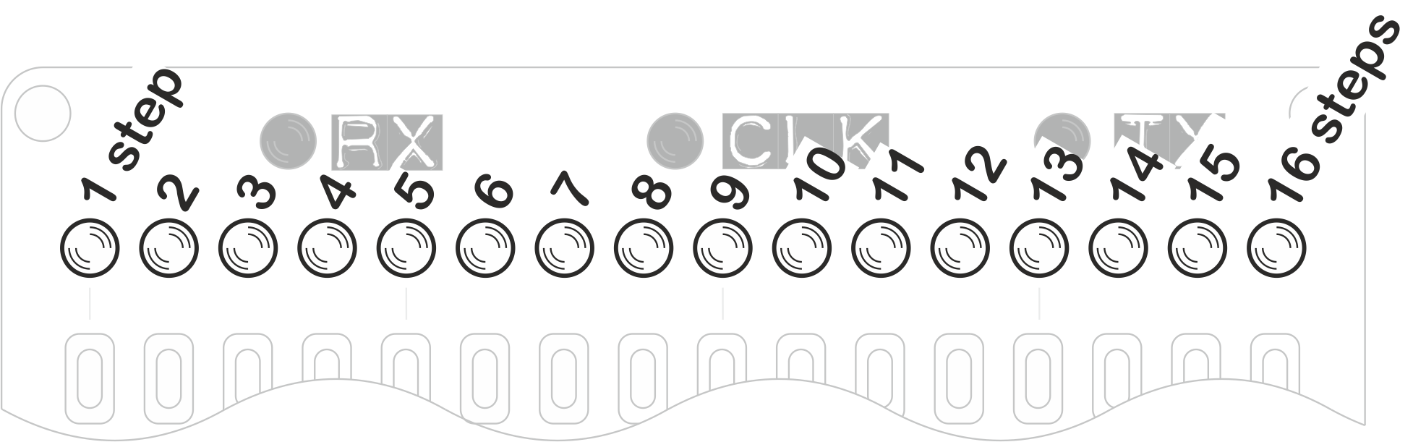
docs/manual/images/PLEN.png
