hotchk155/arpie/docs/manual/images/PROG.png

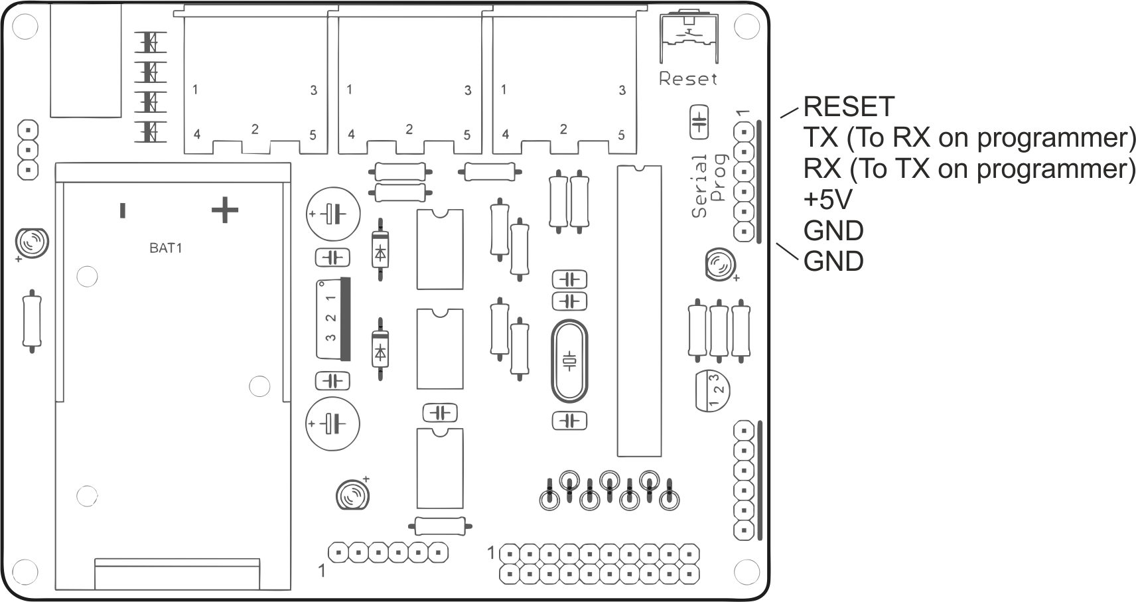
docs/manual/images/PROG.png
