hotchk155/arpie/docs/manual/images/SHFT2.png

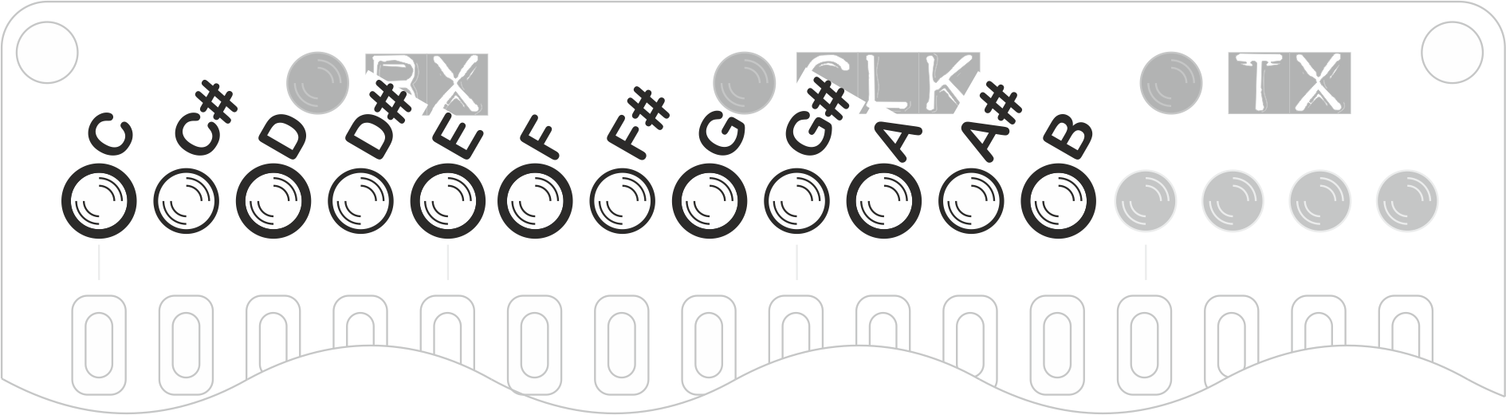
docs/manual/images/SHFT2.png
