hotchk155/arpie/docs/manual/images/SHFT.png

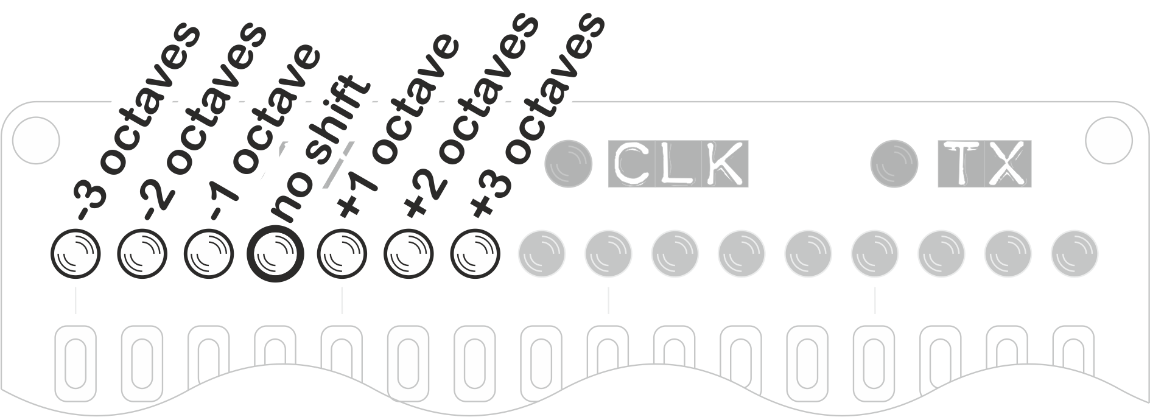
docs/manual/images/SHFT.png
