hotchk155/arpie/docs/manual/images/SYNCTAB.png

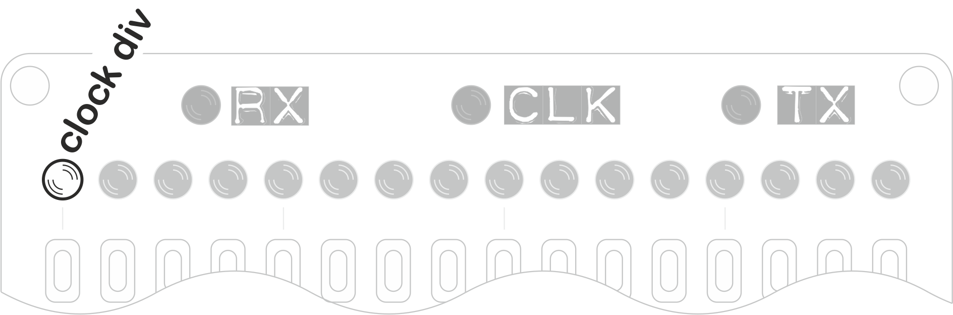
docs/manual/images/SYNCTAB.png
