hotchk155/arpie/docs/manual/images/TAB_CTRL.png

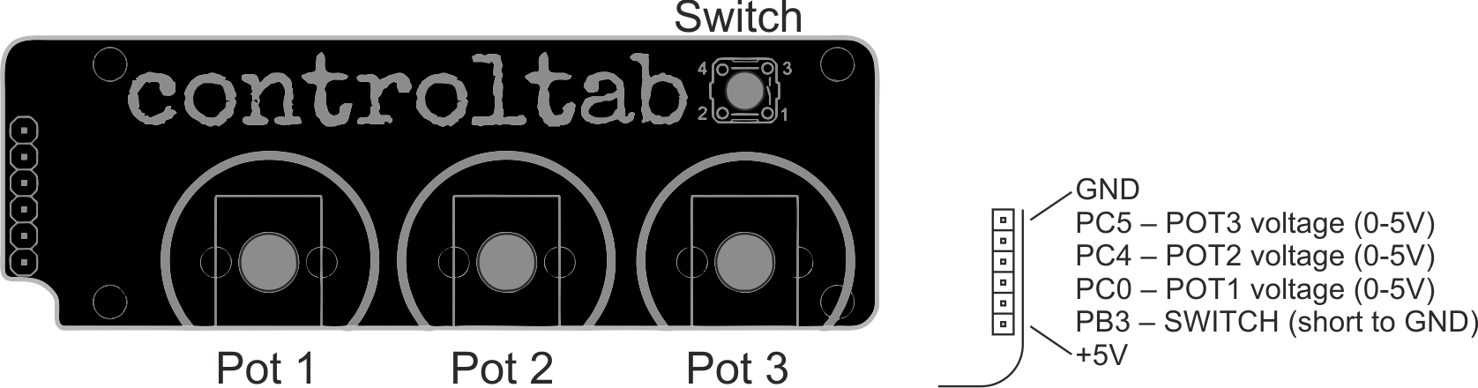
docs/manual/images/TAB_CTRL.png
