hotchk155/arpie/docs/manual/images/TAB_SYNC.png

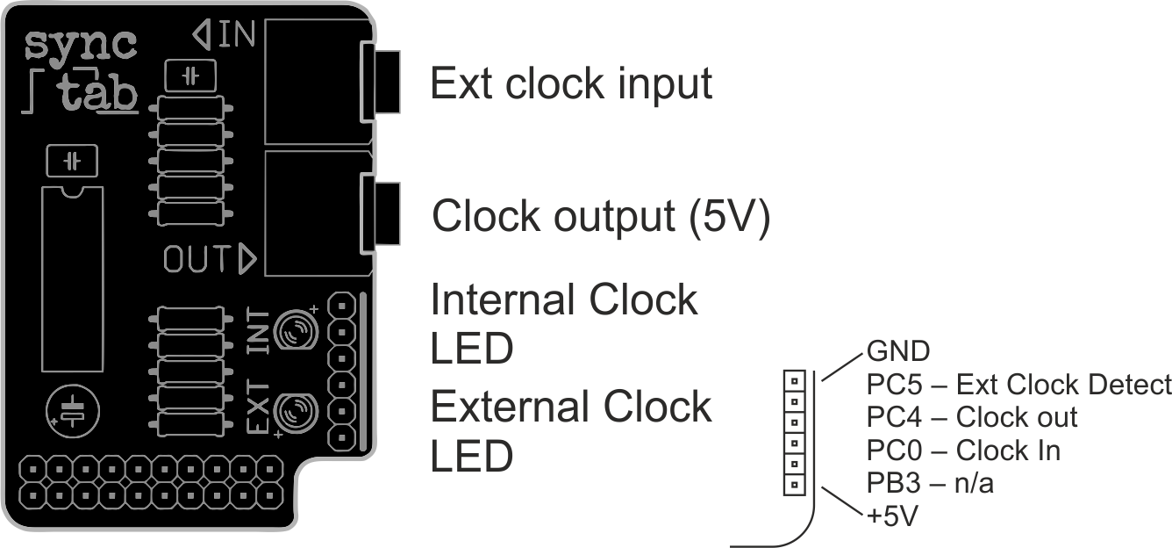
docs/manual/images/TAB_SYNC.png
