hotchk155/arpie/docs/manual/images/VERSION2.png

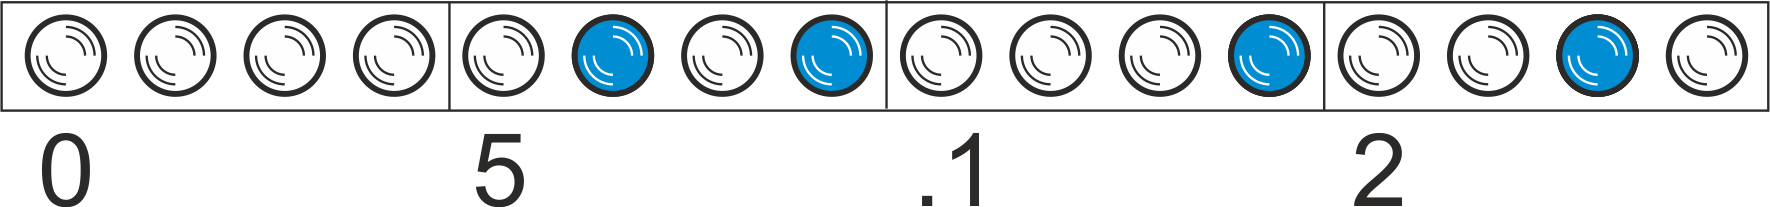
docs/manual/images/VERSION2.png
