hotchk155/arpie/docs/manual/images/VERSION.png

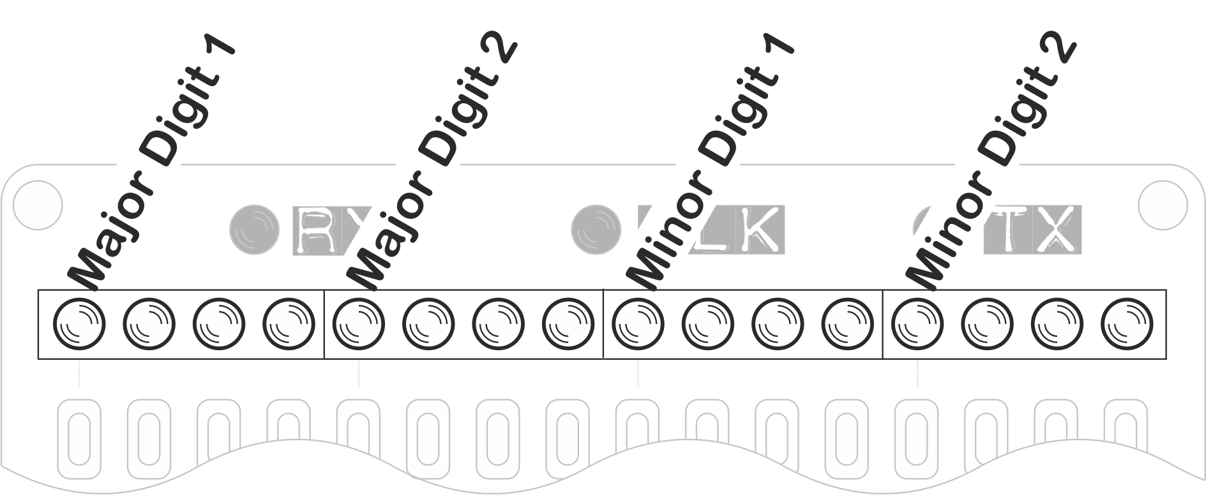
docs/manual/images/VERSION.png
