hotchk155/arpie/docs/Arpie Release Notes release 1.6.odt

# ARPIE RELEASE NOTES REL 6 BETA 19MAY2014

# IMPROVEMENT: MIDI STOP AND CONTINUE

Arpie now detects MIDI STOP and CONTINUE events coming from the external MIDI synch port and will stop playback after a STOP even if the MIDI beat clock continues.

# NEW FEATURE: FORCE TO SCALE

Force to scale is accessible by pressing and holding the SPAN button

SCALE TYPE | | | | | | | | | | | OFF-SCALE NOTE ADJUST
Chromatic | Ionian | Dorian | Phrygian | Lydian | Mixolydian | Aeolian | Locrian | | | | Ignore (No Rest) | Mute (Rest) | Flatten | Sharpen | Alternate

Notes output by the arpeggiator are adjusted (if neccessary) to fall on the scale defined by the key root note (see below) and the scale type. Out of scale notes can be skipped (with or without a rest) or sharpened/flattened by 1 semitone to bring them on to the scale. The Alternate mode sharpens and flattens alternate off-scale notes in the arpeggio sequence. Each time the arpeggio is rebuilt the adjustment applied to each note is also toggled. You can force a rebuild by pressing Alternate while the arpeggio is playing. The adjustment is also alternated with each octave in the arpeggio sequence (so in a sequence spanning 2 octaves notes which are sharpened on the first octave are flattened in the second and vice-versa)

Chromatic | C | C# | D | D# | E | F | F# | G | G# | A | A# | B
Ionian | C | | D | | E | F | | G | | A | | B
Dorian | C | | D | D# | | F | | G | | A | A#
Phrygian | C | C# | | D# | | F | | G | G# | | A#
Lydian | C | | D | | E | | F# | G | | A | | B
Mixolydian | C | | D | | E | F | | G | | A | A#
Aeolian | C | | D | D# | | F | | G | G# | | A#
Locrian | C | C# | | D# | | F | F# | | G# | | A#

The scale root note is selected by pressing and holding the SHFT button

SCALE ROOT NOTE
C | C# | D | D# | E | F | F# | G | G# | A | A# | B

# NEW FEATURE: PREFERENCES

A new "global preferences" menu has been added. This is accessed with a long press to the PLEN menu button. These options are save to EEPROM

| | | | | | | | | | | Auto revert | Long Press | | LED Profile
| | | | | | | | | | | | A | B | A | B

Auto Display Revert determines whether the display reverts to "pattern" display

OFF = do not revert

ON = revert back after approx 10 seconds

Long Press Time selects the amount of time that a menu button needs to be held down in order to access "second function"

A = OFF, B=OFF - 1.5 seconds

A = ON, B=OFF - 1 second

A = OFF, B=ON- 0.5 seconds

A = ON, B=ON- 0.25 seconds

LED Profile allows a choice between different sets of LED brighness levels. Select the best option for the LEDs you have installed on your ARPIE, where you have a decent contrast between the DIM, MEDIUM and BRIGHT options without excessive flickering. As a guideline:

A = OFF, B=OFF - Use with super high brightness LEDs (e.g. super bright white/green)

A = ON, B=OFF - Use with high brightness LEDs (e.g. super bright blue)

A = OFF, B=ON - Use with medium brightness LEDs (e.g. bright blue/red)

A = ON, B=ON - Use with low brightness LEDs (e.g. standard green)

# NEW FEATURE: PERFORMANCE OPTIONS

A new "performance options" menu has been added. This is accessed with a long press to the MODE menu button. These options are saved to EEPROM

Hold Button Fn 2 | | Skip On Rest

Hold Button Secondary Function controls what happens when the hold button is held for a long period of time and starts flashing.

OFF = MIDI Lockout (normal function)

ON = MIDI Transpose (New feature - see below)

Skip On Rest controls how the arpeggio sequencer handles "rests" in the rhythmic pattern

OFF = Notes from the arpeggiated sequence are not skipped when they coincide with a rest in the patten editor. The current position in the sequence increments only when notes are played (New feature - see below)

ON = Notes from the arpeggiated sequence are skipped when they coincide with a rest in the patten editor. The current position in the sequence increments at every step whether the note is played or note (normal function)

# NEW FEATURE: TRANSPOSE BY MIDI INPUT

This new option allows you to tranpose a held arpeggio using your MIDI keyboard. You select the mode by

- Selecting "MIDI Transpose" as the secondary HOLD button function in the preferences menu (This setting is saved when power is off)
- Holding an arpeggio using a single press of the HOLD button then pressing the HOLD button again and keeping it pressed until the HOLD LED starts to flash

Now pressing a key on your MIDI keyboard will transpose the held arpeggio. ARPIE takes the lowest note in the held chord as its root note, and transposes the chord to root it on the note you pressed.

To exit MIDI transpose, press the HOLD button once. Press it again to clear the held chord.

MIDI tranpose can be used interchangeably with the TRAN menu,

Pressing the same tranpose key repeatedly will rebuild the arpeggio, retriggering any "random" chord ordering or "alternating" force to scale setting.

# NEW FEATURE: SKIP ON REST OPTION

Usually when ARPIE encounters a reset in the current pattern position, the current note from the arpeggiator sequence is skipped (muted)

This behaviour can now be controlled by a new option. When the option is set (by default) the usual behaviour is observed however, if the option is unset, the note which coincides with the mute is not skipped but is played on the next pattern note, so no notes from the arpeggio are skipped.

# NEW FEATURE: POLYPHONIC CHORD GATE

A new option has been added to the ARP mode menu

ARP MODE | | | | | | | | | | | | | PATTERN
UP | DOWN | UP-DOWN | RANDOM | KEYBOARD | POLY GATE | | | | | | | | RANDOM | CLEAR | FILL

In this mode, all notes of the arp sequence play together as a single chord, which is gated according to the pattern of beats and mutes.
