hotchk155/arpie/docs/Changes_A5.odt

Hold mode

In hold mode the pattern should

When in hold mode, stop playing when all notes are released, but keep the pattern running

When first key of a chord is pressed

Wait until next step (Y/N)

In HOLD mode after all keys released

Restart sequence next keypress (Y/N)

Restart pattern next keypress (Y/N)

Keep notes playing (Y/N)
