hotchk155/arpie/(threads)

Thread 13 (2013-11-05):

Ability to only advance step when step is enabled

hotchk155, 2013-11-05:
Skip Mode: Notes concurrent with disabled steps are not muted, just held in memory and played whenever a new step is active. For instance, with the following LED sequence:

ooo_oo_oooo_oo_o ( _ = disabled step)

and a C major (C-E-G) input chord, UP mode:

Present behaviour: CEG_EG_EGCE_CE_C EGC_...
Skip mode: CEG_CE_GCEG_CE_G CEG_...

IMO it would be musically interesting to be able to toggle between these two modes mid-chord.
(JP)

hotchk155, 2015-08-31:
SKIP REST option in arpie v4

Closed 2015-08-31.

Thread 31 (2016-04-23):

save current arp chord and settings as a "patch"

hotchk155, 2016-04-23:

cloudyskyle, 2016-07-17:
Maybe a reassigned menu button could allow for at least 16 or maybe 32 pattern presets (bright LED/dim LED) that can be stored with a few keystrokes from the main PATN display. Could even be tucked under TRAN (hold).

Thread 33 (2016-11-07):

No midi input/output

shawnsick, 2016-11-07:
My Arpie has stopped sending MIDI notes, RX LED lights up when I play a note on my MIDI keyboard. Nothing appears to be going through the MIDI output even though the TX LED lights up when notes are received via the MIDI input or in hold/inst without keyboard. The LEDS for IC1 and IC2 show that there is life and I have selected the appropriate MIDI channels, I have tried different synths and MIDI cables and all the solders and resistors are fine but the problem remains.

hotchk155, 2016-11-07:
Hi - I just replied to the question in the Tindie PM you sent. Cheers/Jason

Closed 2016-11-07.

Thread 34 (2017-09-23):

Use Arpie with my own arduino

billyjoker, 2017-09-23:
Hi, i've tried loading this code with my Arduino with a [MIDI breakout](https://www.sparkfun.com/products/retired/9598), but i can not get it work. So, i would have to modify some code? Some help would be very appreciated.

Thanks!!

hotchk155, 2017-09-23:
Hi – Arpie is based on Arduino and code can be loaded to the AVR chip using Arduino environment – However if you want to make your own Arpie you would need to copy the whole circuit, which includes other parts for the control panel and the LED outputs. If you just run it on an Arduino with a MIDI breakout you have no means to control it.

The files for the schematics and PCB design are all in this github repo

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

billyjoker, 2017-09-24:
Hi, thanks for your answer, i understand the point, but my goal was only to get it work with limited (lite?) functions, like to have a bypass mode and some arpeggios defined by me triggered with a midi keyboard.

vskabelkin, 2017-09-24:
Hi, I wonder if there is open code for "synch in" function with PIC MCU for this project? I suppose it is programmed separatly. Thanks for sharing such a cool device!

hotchk155, 2017-09-25:
Hi - the code for the PIC is available here
https://github.com/hotchk155/MIDI-Synch-Decoder/tree/master/src
Cheers
Jason

hotchk155, 2017-09-25:
@billyjoker - yeah you can probably get a cut down firmware working but you would probably need to strip out all code that reads the inputs (a good start would be disabling the interrupt handlers) since otherwise it could be getting random inputs from nonexistent buttons which would interfere with arpeggiation

billyjoker, 2017-09-27:
Thanks i will try in that way!!

Thread 37 (2021-12-19):

Fuses description for ATmega328p

Atarity, 2021-12-19:
It is good to have fuses description for ATmega328p somewhere in docs. Spend whole day checking my build and trying to flash MCU with `avrdude` before realise: fuses should be sat the same way as for Arduino Duemilanove. Otherwise FW will start with wrong clock.

- Setting fuses: `avrdude -B 100 -V -p m328p -c usbasp -P usb -e -u -U lfuse:w:0xFF:m -U hfuse:w:0xDE:m -U efuse:w:0x05:m`
- Flashing FW: `avrdude -B 20 -v -p m328p -c usbasp -P usb -b 57600 -D -U flash:w:arpie.ino.standard.hex:i`

Great project btw. It was a joy to build. 👍

Thread 38 (2023-03-26):

Value for C1, C2 on Control Surface Board?

6040, 2023-03-26:
Hi
does anybody know what the value for C1, C2 on the control surface board should be?

Thanks
6040

6040, 2023-03-29:
Thanks for the quick reply and this great project. I am looking forward to putting this together.
I know I am very late to the party. Just a heads up for any future builders. My pcb maker did not like the control surface because the dimension was not air tight. I just copied the dimension layer from the main pcb and it worked.
