hotchk155/arpie/docs/Quick Ref v6.pdf

# patn

# PLEN

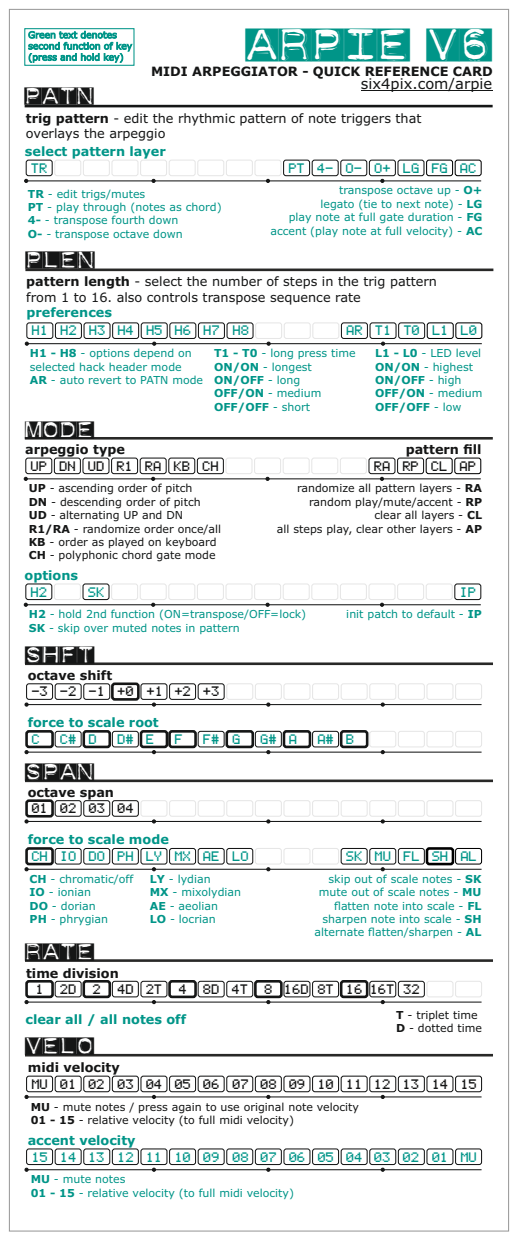
[picture p221: page 1]
time division; LY - lydian MX - mixolydian AE - aeolian LO - locrian; octave span; octave shift; midi velocity; Arpie v6; velo; six4pix.com/arpie; arpeggio type; pattern fill; T - triplet time D - dotted time

Green text denotes
second function of key
(press and hold key)

MIDI ARPEGGIATOR - QUICK REFERENCE CARD

trig pattern - edit the rhythmic pattern of note triggers that
overlays the arpeggio
select pattern layer

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

TR - edit trigs/mutes
PT - play through (notes as chord)
4- - transpose fourth down
O- - transpose octave down

pattern length - select the number of steps in the trig pattern
from 1 to 16. also controls transpose sequence rate
preferences

H1 - H8 - options depend on
selected hack header mode
AR - auto revert to PATN mode
mode

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

L1 - L0 - LED level
ON/ON - highest
ON/OFF - high
OFF/OFF - low

UP - ascending order of pitch
DN - descending order of pitch
UD - alternating UP and DN
R1/RA - randomize order once/all
KB - order as played on keyboard
CH - polyphonic chord gate mode
options
SHFT

randomize all pattern layers - RA
random play/mute/accent - RP

all steps play, clear other layers - AP

clear all layers - CL

H2 - hold 2nd function (ON=transpose/OFF=lock)
SK - skip over muted notes in pattern

init patch to default - IP

force to scale root
span

force to scale mode

CH - chromatic/off
IO - ionian
DO - dorian
PH - phrygian
rate

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

clear all / all notes off

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

MU - mute notes

chromatic transpose

-3 | -2 | -1 | +0 | +1 | +2 | +3 | +4 | +5 | +6 | +7 | +8 | +9 | 10 | 11 | 12

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

01 - 15 - relative note length (to whole note)
LG - play legato (tie notes)

# gate

arp note insertion
NO | HI | LO | 31 | 42 | M7 | C7 | Cm | CM

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

chord insertion
RN | m7
C | C# | D | D# | E | F | F# | G | G# | A | A# | B

manual chord insertion
C | C# | D | D#

# inst

SP - manual transport stop
ST - manual transport start CT - manual transport continue

ext clock (CS led is ON)
CS

CS - switch to internal clock source
SC - send clock to midi out
SC | SP | ST | CT

int clock (CS led is OFF)
CS

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

# sync

# chan

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

press any channel button twice for OMNI mode

# tran

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

# hold

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

midi settings
FC | TC

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

NM - do not thru chan mode msg VK - volca keys velocity mode LO - send midi local off
RS - resync beat count
FN | IC | SC | NM | VK | LO | RS
NO | CT | SY | CV | ME

NO - none
CT - control tab
SY - sync tab
CV - cv tab
ME - memo tab

firmware version display
keep HOLD pressed at power on settings reset
press MODE while version displayed hack header mode
press while version displayed:

with cv tab or memo tab installed: load patch - HOLD+PATN
save patch - HOLD+PLEN
clear patch - HOLD+MODE
followed by slot 1-16
DV | AC | HZ

DV- 8th (ON) or 16th clock*
AC- accent (ON) or clock output
HZ - hz/volt (ON) or 1v/oct cv scaling *also for sync tab

hack header settings for cv tab (long press PLEN)
