hotchk155/arpie/docs/Arpie Quick Reference.pdf

# ARPIE

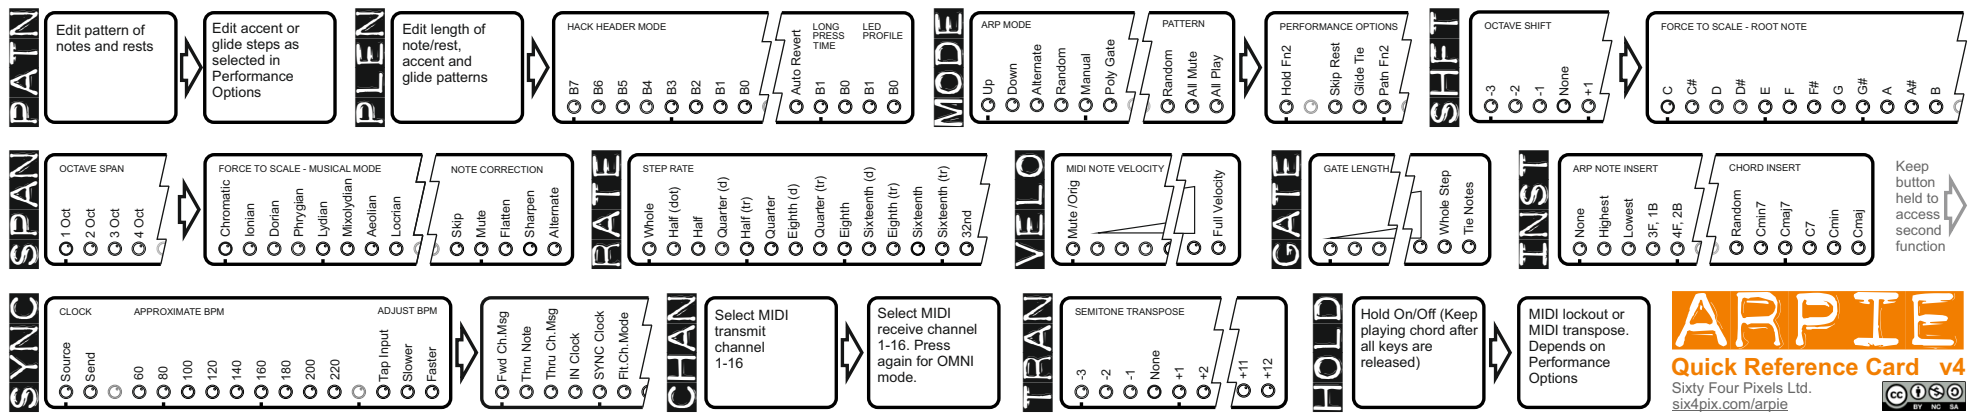
[picture p222: page 1]
HACK HEADER MODE B⁷; Auto Revert; LONG PRESS; LED PROFILE; TIME; Down; Alternate; Random; Manual; Poly Gate; ARP MODE; None; OCTAVE SHIFT; 1 Oct; 2 Oct; 3 Oct; 4 Oct; OCTAVE SPAN; Whole; Half (dot); Half; Quarter (d); STEP RATE; Half (tr); Quarter; Eighth (d); Quarter (tr); Eighth; Sixteenth (d); Eighth (tr); Sixteenth; Sixteenth (tr); Source; Send; Slower; Faster; Thru Note; IN Clock; SYNC Clock; CLOCK; ADJUST BPM; Tap Input; APPROXIMATE BPM; Highest; Lowest; Cmin; Cmaj; CHORD INSERT Cmin7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

Edit accent or
glide steps as
selected in
Performance

Edit length of
note/rest,
accent and
glide patterns

FORCE TO SCALE - ROOT NOTE

Edit pattern of
notes and rests

MIDI NOTE VELOCITY

ARP NOTE INSERT

Thru Ch.Msg

Select MIDI
receive channel
1-16. Press
again for OMNI
mode.

HOLDHold On/Off (Keep

Fwd Ch.Msg

Flt.Ch.Mode

playing chord after
all keys are
released)

MIDI lockout or
MIDI transpose.
Depends on
Options

Quick Reference Card v4
Sixty Four Pixels Ltd.
six4pix.com/arpie
