hotchk155/arpie/hardware/arpie_main.brd

## EAGLE design hardware/arpie_main.brd (2015-04-27)

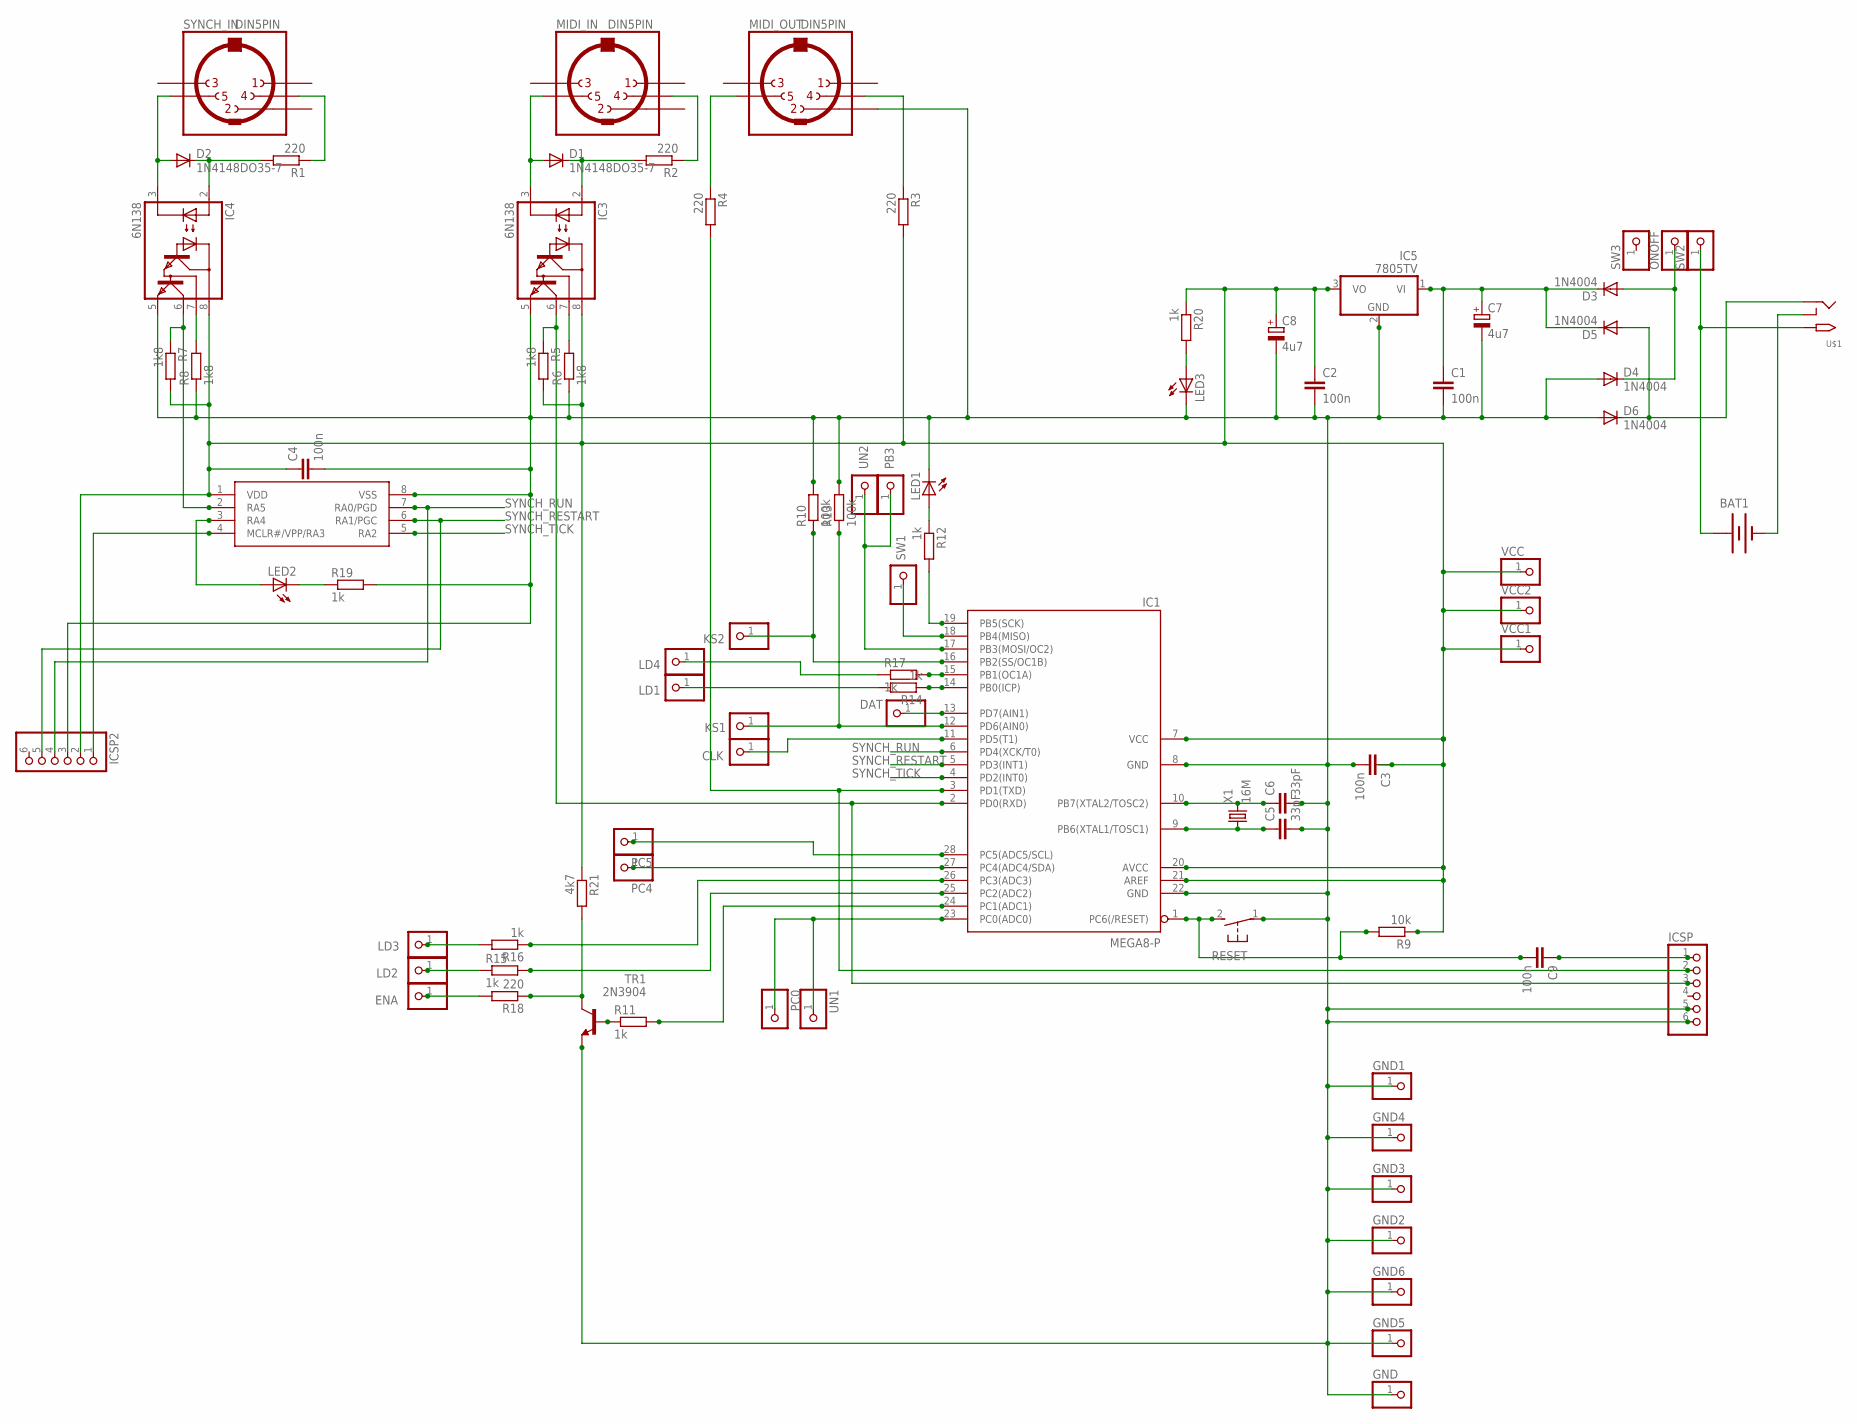
[picture p223: schematic arpie_main.sch]

Parts:
BAT1: BATTERY; PP3_BATTERBOX
C1, C2, C3, C4, C9: 100n; C025-024X044
C5, C6: 33pF; C025-024X044
C7, C8: 4u7; E2,5-7
CLK: PINHD-1X1; 1X01
D1, D2: 1N4148DO35-7; DO35-7
D3, D4, D5, D6: 1N4004; DO-VERT
DAT: PINHD-1X1; 1X01
ENA: PINHD-1X1; 1X01
GND, GND1, GND2, GND3, GND4, GND5, GND6: PINHD-1X1; 1X01
IC1: MEGA8-P; DIL28-3
IC2: PIC12F1822; DIL08
IC3, IC4: 6N138; DIL08
IC5: 7805TV; TO220V
ICSP, ICSP2: PINHD-1X6; 1X06
KS1, KS2: PINHD-1X1; 1X01
LD1, LD2, LD3, LD4: PINHD-1X1; 1X01
LED1, LED2, LED3: LED3MM
MIDI_IN: DIN5PIN; RAPIDDIN5
MIDI_OUT: DIN5PIN; RAPIDDIN5
ONOFF: PINHD-1X1; 1X01
PB3: PINHD-1X1; 1X01
PC0, PC4, PC5: PINHD-1X1; 1X01
R1, R2, R3, R4: 220; 0207/7
R5, R6, R7, R8: 1k8; 0207/7
R9: 10k; 0207/7
R10: 100k; 0207/7
R11, R12, R19, R20: 1k; 0207/7
R13: 100k; 0207/2V
R14, R15, R16, R17: 1k; 0207/2V
R18: 220; 0207/2V
R21: 4k7; 0207/2V
RESET: 31-XX; B3F-31XX
SW1, SW2, SW3: PINHD-1X1; 1X01
SYNCH_IN: DIN5PIN; RAPIDDIN5
TR1: 2N3904; TO92
U$1: 2.1MMJACKTHM; PJ-102A
UN1, UN2: PINHD-1X1; 1X01
VCC, VCC1, VCC2: PINHD-1X1; 1X01
X1: 16M; HC49/S

Connections:
CLK: CLK.1, IC1.11 (PD5(T1))
DAT: DAT.1, IC1.13 (PD7(AIN1))
ENA: ENA.1, R18.2
GND: C1.2, C2.2, C3.2, C4.2, C5.2, C6.2, C7.-, C8.-, D4.A, D6.A, GND.1, GND1.1, GND2.1, GND3.1, GND4.1, GND5.1, GND6.1, IC1.8 (GND), IC1.22 (GND), IC2.8 (VSS), IC3.5 (GND), IC4.5 (GND), IC5.2 (GND), ICSP.5, ICSP.6, ICSP2.3, LED1.K (C), LED3.K (C), MIDI_OUT.2, R6.1, R8.1, R10.2, R13.2, R19.2, RESET.1, TR1.3 (E)
KS1: IC1.12 (PD6(AIN0)), KS1.1, R13.1
KS2: IC1.16 (PB2(SS/OC1B)), KS2.1, R10.1
LD1: LD1.1, R14.2
LD2: LD2.1, R15.1
LD3: LD3.1, R16.2
LD4: LD4.1, R17.1
unnamed: D1.A, IC3.3 (C), MIDI_IN.5
unnamed: D1.C, IC3.2 (A), R2.2
unnamed: MIDI_IN.4, R2.1
unnamed: D2.A, IC4.3 (C), SYNCH_IN.5
unnamed: D2.C, IC4.2 (A), R1.2
unnamed: R1.1, SYNCH_IN.4
unnamed: IC1.2 (PD0(RXD)), IC3.6 (VO), ICSP.3, R5.1
unnamed: IC3.7 (VB), R6.2
unnamed: C9.1, ICSP.1
unnamed: IC4.7 (VB), R8.2
unnamed: MIDI_OUT.5, R4.1
unnamed: IC1.3 (PD1(TXD)), ICSP.2, R4.2
unnamed: MIDI_OUT.4, R3.1
unnamed: R18.1, R21.2, TR1.1 (C)
unnamed: IC2.2 (RA5), IC4.6 (VO), R7.1
unnamed: IC2.3 (RA4), LED2.A
unnamed: IC1.28 (PC5(ADC5/SCL)), PC5.1
unnamed: IC2.4 (MCLR#/VPP/RA3), ICSP2.1
unnamed: LED3.A, R20.2
unnamed: IC1.27 (PC4(ADC4/SDA)), PC4.1
unnamed: D5.A, D6.C, U$1.RING
unnamed: R11.1, TR1.2 (B)
unnamed: IC1.26 (PC3(ADC3)), R16.1
unnamed: C6.1, IC1.10 (PB7(XTAL2/TOSC2)), X1.2
unnamed: C5.1, IC1.9 (PB6(XTAL1/TOSC1)), X1.1
unnamed: C9.2, IC1.1 (PC6(/RESET)), R9.2, RESET.2 (S)
unnamed: IC1.25 (PC2(ADC2)), R15.2
unnamed: IC1.24 (PC1(ADC1)), R11.2
unnamed: IC1.14 (PB0(ICP)), R14.1
unnamed: IC1.19 (PB5(SCK)), R12.2
unnamed: LED1.A, R12.1
unnamed: LED2.K (C), R19.1
unnamed: D3.A, D4.C, ONOFF.1
unnamed: IC1.15 (PB1(OC1A)), R17.2
unnamed: BAT1.0V (-), U$1.RING_SW
PWR+: BAT1.9V (+), SW2.1, U$1.TIP
SW1: IC1.18 (PB4(MISO)), SW1.1
SYNCH_RESTART: IC1.5 (PD3(INT1)), IC2.6 (RA1/PGC), ICSP2.5
SYNCH_RUN: IC1.6 (PD4(XCK/T0)), IC2.7 (RA0/PGD), ICSP2.4
SYNCH_TICK: IC1.4 (PD2(INT0)), IC2.5 (RA2)
UN1: IC1.23 (PC0(ADC0)), PC0.1, UN1.1
UN2: IC1.17 (PB3(MOSI/OC2)), PB3.1, UN2.1
VCC: C2.1, C3.1, C4.1, C8.+, IC1.7 (VCC), IC1.20 (AVCC), IC1.21 (AREF), IC2.1 (VDD), IC3.8 (VCC), IC4.8 (VCC), IC5.3 (VO), ICSP2.2, R3.2, R5.2, R7.2, R9.1, R20.1, R21.1, VCC.1, VCC1.1, VCC2.1
VIN: C1.1, C7.+, D3.C, D5.C, IC5.1 (VI)

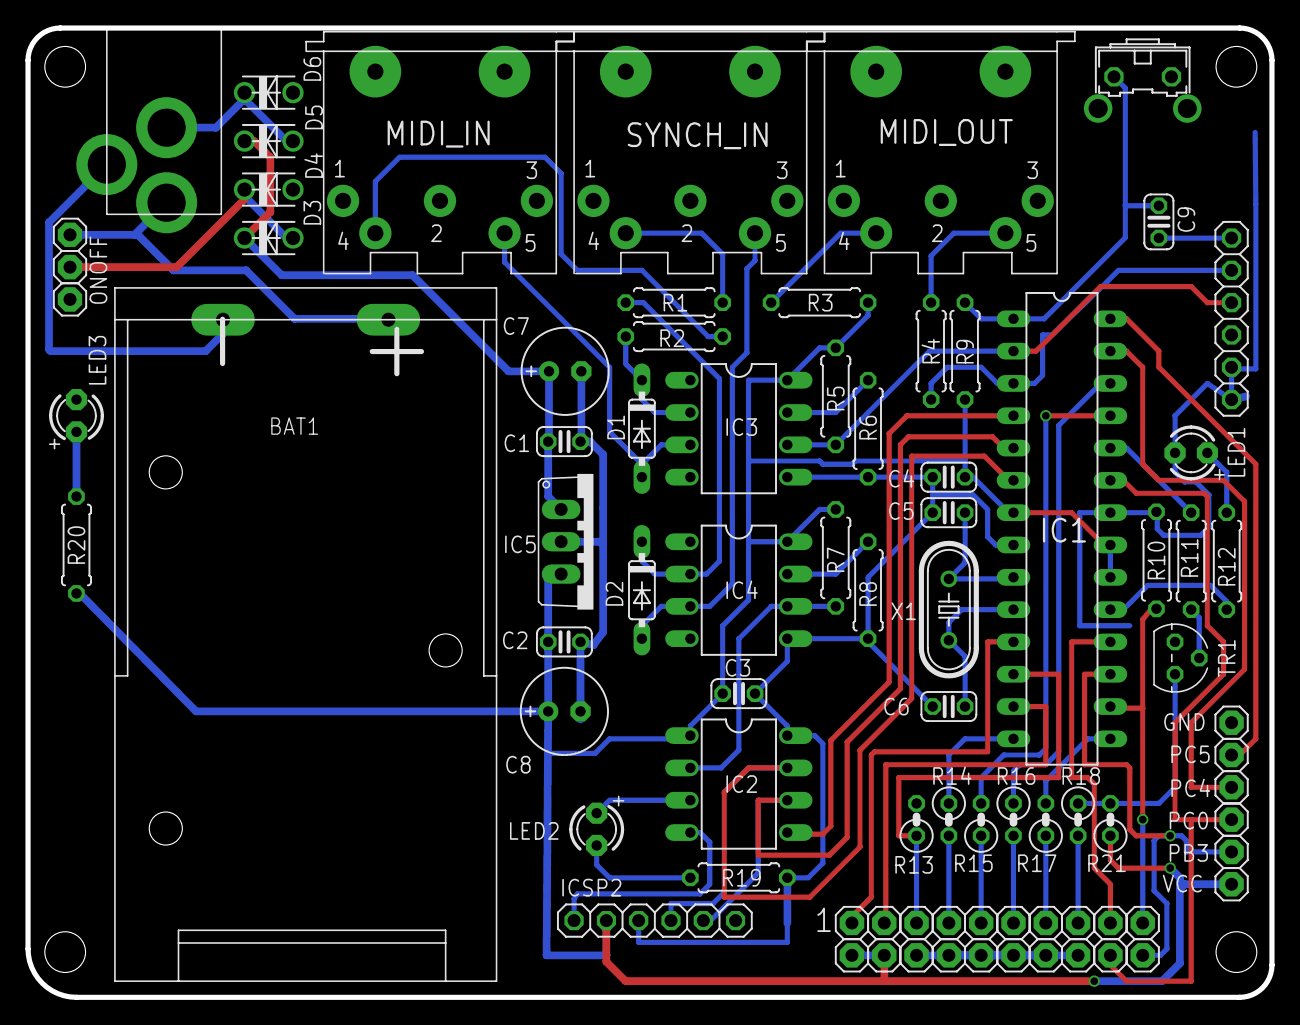
[picture p224: board arpie_main.brd from above]

Board: 2 copper layers, 97.8 x 76.2 mm, 83 parts (0 on the bottom side), 54 nets.
