hotchk155/arpie/(commit log)

2013-03-20 part values
    [arpie_main.brd, arpie_main.sch]
2013-03-20 initial commit of updated firmware
    [pin mappings.ods]
2013-03-25 tweaks an d bug fixes
    [arpie.ino]
2013-03-30 fix issue with held note count
    [arpie.ino]
2013-04-03 Rev 2 changes
    increase spacing of DIN connectors
    move reset button and DC socket
    larger holes for 3x6mm tact switches
    text changes
    [arpie_control_surface.brd, arpie_control_surface.sch, arpie_main.brd, arpie_main.sch]
2013-04-04 updates for pcb manuf
    [arpie_control_surface.brd, arpie_control_surface.sch]
2013-04-04 midi thru fixes/manual velocity
    [arpie.ino]
2013-04-16 tidying up
    [parts.ods]
2013-04-16 Fixes and enhancments
    Allow f/w version to be displayed by pressing HOLD when switching on
    Correct order of note rates
    [arpie.ino]
2013-04-23 add input lock mode via hold button
2013-05-13 Fix issue with synch thru/change lockout blink rate
    [full parts list.ods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]
2013-06-17 simon's case mod
2013-06-18 simons case
2013-11-06 Reflect main board rev 3
2013-11-08 rev3 board images
2014-01-04 big arpie
    [arpie_max.brd, arpie_max.sch]
2014-03-25 reduce flicker of dim level led
2015-02-14 // 99.99 07Feb14 Midi CC filter
2015-02-14 A4 release candidate
    [arpie_max.brd, arpie_max.sch]
2015-02-14 New docs for v4
    [full parts list.ods, parts.ods, pin mappings.ods]
2015-02-14 Order HH pot options like controltab reference design and tweak couple of other settings
2015-03-02 case files
    [arpie-case.dxf]
2015-04-27 move mainboard v3 to master
    [arpie_main.brd, arpie_main.sch]
2015-04-27 grounded MIDI output, add LED pullup
    [arpie_main.brd, arpie_main.sch]
2015-05-23 board rev4
2016-09-07 adjustable accent velocity
2018-01-10 case mods
2018-03-11 5.2
    rel 5.2 - fix timing glitch on aux sync
    [arpie.ino]
2018-12-23 shift by hold button
2019-01-11 hack header mode set at startup/blink leds in patch mode
2019-01-13 calibration function for cvtab
2019-01-13 storage of calibration data on cvtab
2019-02-24 case instructions from old web site
2019-04-25 fixes to pitch glide
    [arpie.ino]
2019-06-08 5.4 BETA with bug fixes
    avoid all attempts to access CVTab unless in the correct mode
    [arpie.ino]
2019-07-27 5.7beta with fix for step length
    [arpie.ino]
2019-07-27 LED profile tweak / accent+glide triggered only on real step
2019-09-17 fix dupe lines lg 5mm
2019-09-22 fix send clock LED issue
    [arpie.ino]
2019-09-22 resync button
2019-11-05 Revert "Update arpie.ino"
    This reverts commit 1b937bc56bd1caa416f44e9dfce60e194e3457db.
    [arpie.ino]
2020-04-24 bom update
2020-09-21 Update case parts.txt
2021-04-12 case tweaks
